equinoxorg/Micro-Hydro-ELC/README.md

hydrocontroller-hardware-designs
================================

This repository holds PCB/hardware designs for the e.quinox Kingfisher Micro Hydro Power Plant Controller.

Edit
