equinoxorg/Micro-Hydro-ELC/PCB_ControlStack/Images/breakoutTOP.png

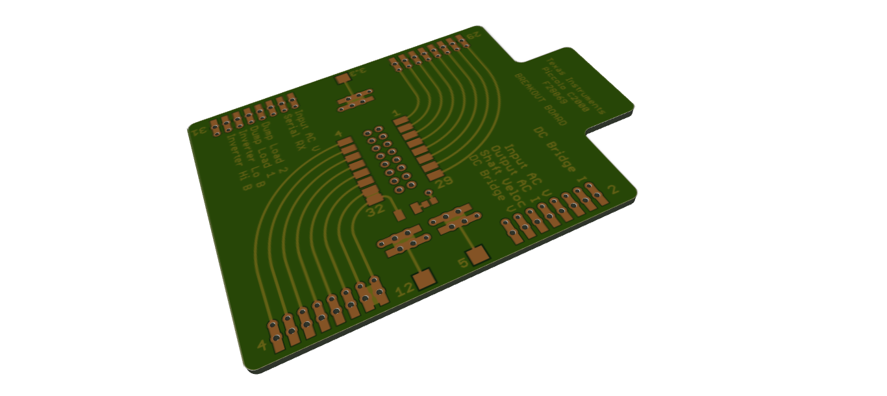
PCB_ControlStack/Images/breakoutTOP.png
