equinoxorg/Micro-Hydro-ELC/PCB_ControlStack/Images/supplyTOP.png

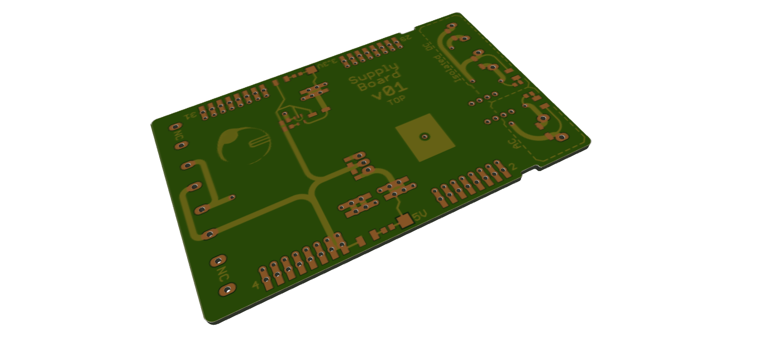
PCB_ControlStack/Images/supplyTOP.png
