equinoxorg/Micro-Hydro-ELC/PCB_ControlStack/Stacks Pin Layout.PNG

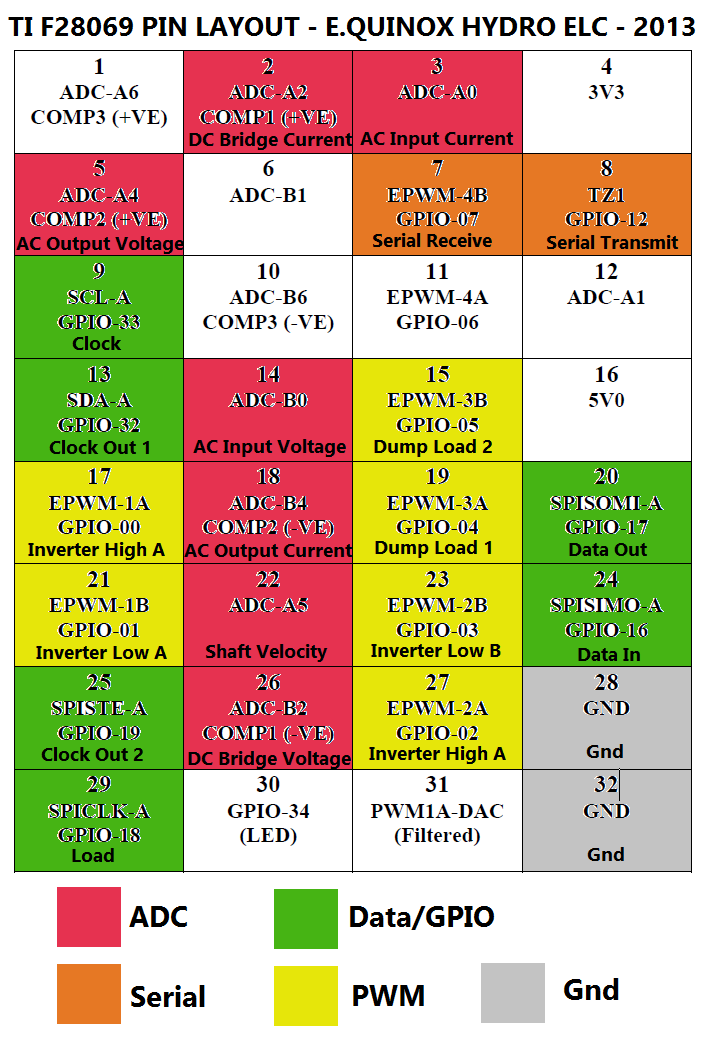
PCB_ControlStack/Stacks Pin Layout.PNG
