equinoxorg/Micro-Hydro-ELC/PCB_ControlStack/Components - Controller v07.xlsx

Sheet: Rev2
 | Board | Control PCB
 | Revision | 3rd |  | Authors | Wanyun Vivian Yang & Ali Al-Hakim |  |  |  | TOTAL | £95.75
 |  |  |  | Means EAGLE FILES ready available
Delivered? (Enter "d") | Order date | Supplier | Reference | Item Name | Description | Case/Package Type | Quantity | Minimum Order Quantity | Price, GBP | Total, GBP | URL | Other + EAGLE Package
d |  | OneCall | 1564483 | KA7805AETU | 12V to 5V regulator, 1A | TO-220 | 3 | 1 | £0.36 | £1.08 | http://onecall.farnell.com/fairchild-semiconductor/ka7805aetu/ic-reg-ldo-5v-1a-to220-3/dp/1564483 | controlPCB_aha.lbr
d |  | OneCall | 2219097 | MIC5219-3.3YM5TR | 12V to 3.3V regulator, 1.5A | SMD,SOT-23 | 6 | 1 | £1.14 | £6.84 | http://onecall.farnell.com/micrel-semiconductor/mic5219-3-3ym5-tr/ldo-0-5vdo-0-5a-3-3v-1-5sot23/dp/2219097 | MIC5219XX
d |  | OneCall | 8728151 | IL1212S | Isolated Power Supply 12V/12V |  | 4 | 1 | £4.50 | £18.00 | http://onecall.farnell.com/xp-power/il1212s/converter-dc-dc-2w-12v/dp/8728151 | controlPCB_aha.lbr
d |  | OneCall | 1201249 | 74HC165D | Shift Register Parallel to Serial | SOIC | 6 | 1 | £0.38 | £2.28 | http://uk.farnell.com/nxp/74hc165d/ic-74hc-cmos-smd-74hc165-soic16/dp/1201249 | U1 74HC165D.lbr
d |  | OneCall | 1752869 | SN74AHC594D | Shift Register Serial to Parallel | SMD, SO-16 | 6 | 1 | £0.29 | £1.74 | http://uk.farnell.com/texas-instruments/sn74ahc594d/logic-8bit-shift-register-16soic/dp/1752869 | S_REG_ONE, S_REG_TWO controlPCB_aha.lbr
d |  | OneCall | 1781148 | MCP2200 | USB 2.0 to UART chip, | SMD, SO-20 | 3 | 1 | £1.50 | £4.50 | http://onecall.farnell.com/microchip/mcp2200-i-so/ic-usb2-0-to-uart-w-gpio-20soic/dp/1781148 | controlPCB_aha.lbr
d |  | Onecall | 2063133 | MC22008B6W | Midas 2x20 character LCD display | n/a | 1 | 1 | £13.09 | £13.09 | http://onecall.farnell.com/midas/mc22008b6w-sptly/lcd-2x20-stn-g-b-l-8mm/dp/2063133?Ntt=2063133
d |  | OneCall | 1593421 | MC34735 | Male-Male Header 2.54mm pitch | Through-hole | 80 | 10 | £0.12 | £9.60 | http://onecall.farnell.com/multicomp/mc34735/header-1-row-vert-14way/dp/1593421?Ntt=1593421 | headers v6-2.lbr
d |  | RS | 681-6848 | n/a | HARWIN DIL receptacles, 2.54mm pitch | Through-hole | 4 | 5 | £1.78 | £8.90 | http://uk.rs-online.com/web/p/pcb-sockets/6816848/ | controlPCB_aha.lbr
d |  | RS | 673-7486 | n/a | HARWIN SIL 1x10w header, straight | Through-hole | 8 | 5 | £0.19 | £1.92 | http://uk.rs-online.com/web/p/headers-pcb-receptacles/6737486/ | headers v6-2.lbr
d |  | EE stores | CN0001 | n/a | PCB 2WAY 18A TERMINAL BLOCK 7.5MM | Through-hole | 10 | 1 | £0.14 | £1.40 | http://www.ee.ic.ac.uk/storesweb/Page8.html | headers v6-2.lbr
d |  | OneCall | RE06737 | 3296Y-1-103LF | 10kohmtrimmer, 25 turn, (through-hole) | 64Y | 4 | 1 | £0.89 | £3.56 | http://onecall.farnell.com/bourns/3296-1-103lf/trimmer-25-turn-10k/dp/RE06737 | R-TRIMM64Y
d |  | OneCall | 1506148 | LHVC0805-100KFT5 | Welwyn 100kohm resistor | SMD, 0805 | 20 | 10 | £0.02 | £0.46 | http://onecall.farnell.com/welwyn/lhvc0805-100kft5/resistor-100k-1-0805/dp/1506148 | R9, R10, R11, R12 R-EU_M0805
d |  | OneCall | 1500670 | RT0805FRE071K2L | Yageo 1.2kohm resistor | SMD, 0805 | 15 | 5 | £0.02 | £0.28 | http://onecall.farnell.com/yageo-phycomp/rt0805fre071k2l/resistor-0805-1-50ppm-1k2/dp/1500670 | R24, R25, R26 R-EU_M0805
d |  | OneCall | 2138843 | CRCW0805102RFKEA | Vishay Draloric 102ohm resistor | SMD, 0805 | 5 | 50 | £0.01 | £0.30 | http://onecall.farnell.com/vishay-draloric/crcw0805102rfkea/resistor-0805-102r-1/dp/2138843 | R27 R-EU_M0805
d |  | OneCall | 2138818 | CRCW080561R9FKEA | Vishay Draloric 61.9ohm resistor | SMD, 0805 | 5 | 50 | £0.01 | £0.30 | http://onecall.farnell.com/vishay-draloric/crcw080561r9fkea/resistor-0805-61r9-1/dp/2138818 | R28 R-EU_M0805
d |  | OneCall | 1653294 | RR1220P-201 | Susumu 200ohm resistor | SMD, 0805 | 100 | 1 | £0.06 | £6.40 | http://onecall.farnell.com/susumu/rr1220p-201-b-t5/resistor-0805-0-1-200r/dp/1653294 | R1, R2, R3, R4, R5, R6, R7, R8, R13, R14, R15, R16, R17, R18, R19, R20, R21, R22, R23, R29, R30 R-EY_M0805
d |  | OneCall | 1223746 | HSMF-A211-A00J1 | Avago LED red / yellow-green dual LED | SMD, PLCC-4 | 3 | 5 | £0.23 | £1.15 | http://onecall.farnell.com/avago-technologies/hsmf-a211-a00j1/led-smd-red-yel-grn/dp/1223746 http://onecall.farnell.com/avago-technologies/asmt-shb4-pw905/led-smd-plcc4-silicone-red-orange/dp/2065649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 | LEDP-LCC-4
d |  | OneCall | 1058404 | HSMS-A100-L00J1 | Avago LED red | SMD, PLCC-2 | 5 | 5 | £0.08 | £0.40 | http://onecall.farnell.com/avago-technologies/hsms-a100-l00j1/led-smd-plcc2-he-red/dp/1058404 | LG_T679-E1F1-1 OR LEDP-LCC-2
d |  | OneCall | 1659076 | VLMC3100-GS08 | Vishay LED green | SMD, PLCC-2 | 10 | 5 | £0.07 | £0.70 | http://onecall.farnell.com/vishay/vlmc3100-gs08/led-smd-plcc2-green/dp/1659076 | LG_T679-E1F1-1 OR LEDP-LCC-2
d |  | OneCall | 1865504 | C0603C390J1GACTU | Kemet 39pF ceramic capacitor | SMD, 0603 | 5 | 10 | £0.01 | £0.11 | http://onecall.farnell.com/kemet/c0603c390j1gactu/capacitor-np0-0603-100v-39pf/dp/1865504 | C11, C12 C-EUC0603
d |  | OneCall | 1833809 | 0603ZG105ZAT2A | AVX 1uF ceramic capacitor | SMD, 0603 | 3 | 10 | £0.02 | £0.19 | http://onecall.farnell.com/avx/0603zg105zat2a/capacitor-06035v-10v-1uf/dp/1833809 | C7
d |  | OneCall | 1889265 | GRM188C80J225KE19D | Murata 2.2uF ceramic capacitor | SMD, 0603 | 3 | 10 | £0.03 | £0.33 | http://onecall.farnell.com/murata/grm188c80j225ke19d/capacitor-0603-x6s-6-3v-2-2uf/dp/1889265 | C8
d |  | OneCall | 2112833 | C0603C104K8RACTU | Kemet 0.1uF ceramic capacitor | SMD, 0603 | 10 | 1 | £0.01 | £0.11 | http://onecall.farnell.com/kemet/c0603c104k8ractu/capacitor-0-1uf-10v-x7r-0603/dp/2112833 | C9, C10, C6 C-EUC0603
d |  | OneCall | 1510713 | PESD3V3L2BT | Bidirectional, dual ESD Protection | SMD, SOT-23 | 21 | 5 | £0.15 | £3.67 | http://uk.farnell.com/nxp/pesd3v3l2bt/diode-tvs-2ua-3-3v-sot-23/dp/1510713RL | BAS40-06
d |  | OneCall | SC10048 | LF A158A | IQD crystal oscillator, 12MHz | HC-49 | 4 | 1 | £0.28 | £1.12 | http://onecall.farnell.com/iqd-frequency-products/lf-a158a/crystal-12mhz/dp/SC10048 | CRYSTALHC49U-V
d |  | OneCall | CN15415 | MC32593 | USB connector | Through-hole | 4 | 1 | £0.32 | £1.28 | http://onecall.farnell.com/multicomp/mc32593/socket-usb-pcb-r-a-type-a/dp/CN15415 | controlPCB_aha.lbr
d |  | OneCall | CN15441 | 47346-0001 | Micro USB connector | SMD | 4 | 1 | £0.46 | £1.84 | http://onecall.farnell.com/molex/47346-0001/receptacle-micro-usb-b-bottom-mount/dp/CN15441 | MINI-USB-SCHIELD-32005-301

Sheet: Breakout
 | Board | Control PCB - Breakout Module
 | Revision | 4th |  | Authors | Ali Al-Hakim |  |  |  | TOTAL | £20.27
 |  |  |  | Means EAGLE FILES ready available
Delivered? (Enter "d") | Order date | Supplier | Reference | Item Name | Description | Case/Package Type | Quantity | Minimum Order Quantity | Price, GBP | Total, GBP | URL | Other + EAGLE Package
d |  | Onecall | 1022257 |  | Male header, 1x8way, 2.54mm pitch | TH | 4 | 10 | £0.10 | £0.97 | http://onecall.farnell.com/harwin/m20-9990846/header-1row-8way/dp/1022257
d |  | Onecall | 7992017 |  | Female header, 2x8way, 2.54mm pitch | TH | 2 | 10 | £1.86 | £18.60 | http://onecall.farnell.com/harwin/m20-7830846/socket-pcb-0-1-8-8way/dp/7992017
 |  | Onecall | 1830409 |  | LED, green | SMD, PLCC2 | 0 | 5 | £0.07 | £0.00 | http://onecall.farnell.com/avago-technologies/hsmg-a100-l02j1/led-smd-plcc2-green/dp/1830409
d |  | Onecall | SC11679 |  | LED, orange | SMD, PLCC2 | 1 | 5 | £0.08 | £0.40 | http://onecall.farnell.com/avago-technologies/hsmd-a100-j00j1/led-smd-plcc2-orange/dp/SC11679
 |  | Onecall | 1058404 |  | LED, red | SMD, PLCC2 | 0 | 5 | £0.08 | £0.00 | http://onecall.farnell.com/avago-technologies/hsms-a100-l00j1/led-smd-plcc2-he-red/dp/1058404 | LED1, LED2, LED3, LED4
 |  | Onecall | 1328367 |  | LED, yellow | SMD, PLCC2 | 0 | 5 | £0.09 | £0.00 | http://onecall.farnell.com/vishay/vlmy31j1k2-gs08/led-plcc2-yellow/dp/1328367
 |  | Onecall | 1561007 |  | LED, blue | SMD, PLCC2 | 0 | 5 | £0.32 | £0.00 | http://onecall.farnell.com/vishay/vlmb41p1q2-gs08/led-plcc2-blue/dp/1561007
 |  | Onecall | 1561003 |  | LED, white | SMD, PLCC2 | 0 | 5 | £0.18 | £0.00 | http://onecall.farnell.com/vishay/vlmw41s1t1-5k8l-08/led-plcc2-white/dp/1561003
d |  |  | 2138798 |  | Resistor, 39ohm | SMD, 0805 | 1 | 50 | £0.01 | £0.30 | http://onecall.farnell.com/vishay-draloric/crcw080539r0fkea/resistor-0805-39r-1/dp/2138798 | R3

Sheet: Power
 | Board | Control PCB - Supply Module
 | Revision | 4th |  | Authors | Ali Al-Hakim |  |  |  | TOTAL | £10.51
 |  |  |  | Means EAGLE FILES ready available
Delivered? (Enter "d") | Order date | Supplier | Reference | Item Name | Description | Case/Package Type | Quantity | Minimum Order Quantity | Price, GBP | Total, GBP | URL | Other + EAGLE Package
d |  | EEE | CN0001 |  | Vertical terminal block, 7.5mm pitch | TH | 7
d |  | Onecall |  | MIC5219 | Micrel 12V to 3V3 LDO | SMD, SOT23 | 1 | 1 | £1.14 | £1.14 | http://onecall.farnell.com/micrel-semiconductor/mic5219-3-3ym5-tr/ldo-0-5vdo-0-5a-3-3v-1-5sot23/dp/2219097 | U1
d |  | OneCall |  |  | Fairchild 10V to 5V LDO | TH, TO220 | 1 | 1 | £0.36 | £0.36 | http://onecall.farnell.com/fairchild-semiconductor/ka7805aetu/ic-reg-ldo-5v-1a-to220-3/dp/1564483 | U2
d |  |  | 9334688 |  | Resistor, 560ohm | SMD, 0805 | 2 | 50 | £0.01 | £0.50 | http://onecall.farnell.com/multicomp/mc-0-1w-0805-5-560r/resistor-0805-560r/dp/9334688 | R1, R2
d |  |  | 9333916 |  | Resistor, 150ohm | SMD, 0805 | 1 | 50 | £0.01 | £0.50 | http://onecall.farnell.com/multicomp/mc-0-1w-0805-5-150r/resistor-0805-150r/dp/9333916 | R4
d |  |  | 2138798 |  | Resistor, 39ohm | SMD, 0805 | 1 | 50 | £0.01 | £0.30 | http://onecall.farnell.com/vishay-draloric/crcw080539r0fkea/resistor-0805-39r-1/dp/2138798 | R3
d |  | Onecall | 2069174 |  | Electrolytic capacitor, 10uF | SMD, 4mm | 3 | 10 | £0.12 | £1.19 | http://onecall.farnell.com/kemet/exv106m025a9baa/capacitor-10uf-25v-smd/dp/2069174 | C1, C2, C3
d |  | Onecall | 2068683 |  | Electolytic capacitor, 2.2uF | SMD, 4mm | 1 | 10 | £0.08 | £0.81 | http://onecall.farnell.com/jsp/search/browse.jsp?N=411+202457+732+502+110059735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 | C4
d |  | Onecall | CA06659 |  | Ceramic capacitor, 470pF | SMD, 0805 | 1 | 10 | 0.028 | £0.28 | http://onecall.farnell.com/kemet/c0805c471j5gactu/capacitor-0805-470pf-50v-np0/dp/CA06659 | C5
d |  | Onecall | 1845770 |  | Ceramic capacitor, 1uF | SMD, 0805 | 1 | 10 | £0.04 | £0.42 | http://onecall.farnell.com/murata/grm219r71e105ka88d/cap-ceramic-1uf-25v-x7r-0805/dp/1845770 | C6
d |  | OneCall | 1759265 |  | Ceramic capacitor, 0.1uF | SMD, 0805 | 1 | 100 | £0.01 | £0.70 | http://onecall.farnell.com/multicomp/mcca000386/cap-ceramic-0-1uf-50v-x7r-0805/dp/1759265 | C8
d |  | Onecall | CA06414 |  | Ceramic capacitor, 0.33uF | SMD, 0805 | 1 | 100 | £0.02 | £1.60 | http://onecall.farnell.com/multicomp/mcca000283/mlcc-0805-x7r-16v-330nf/dp/CA06414 | C7
 |  | Onecall | 1830409 |  | LED, green | SMD, PLCC2 | 0 | 5 | £0.07 | £0.00 | http://onecall.farnell.com/avago-technologies/hsmg-a100-l02j1/led-smd-plcc2-green/dp/1830409
 |  | Onecall | SC11679 |  | LED, orange | SMD, PLCC2 | 0 | 5 | £0.08 | £0.00 | http://onecall.farnell.com/avago-technologies/hsmd-a100-j00j1/led-smd-plcc2-orange/dp/SC11679
nd |  | Onecall | 1058404 |  | LED, red | SMD, PLCC2 | 4 | 5 | £0.08 | £0.40 | http://onecall.farnell.com/avago-technologies/hsms-a100-l00j1/led-smd-plcc2-he-red/dp/1058404 | LED1, LED2, LED3, LED4
 |  | Onecall | 1328367 |  | LED, yellow | SMD, PLCC2 | 0 | 5 | £0.09 | £0.00 | http://onecall.farnell.com/vishay/vlmy31j1k2-gs08/led-plcc2-yellow/dp/1328367
 |  | Onecall | 1561007 |  | LED, blue | SMD, PLCC2 | 0 | 5 | £0.32 | £0.00 | http://onecall.farnell.com/vishay/vlmb41p1q2-gs08/led-plcc2-blue/dp/1561007
 |  | Onecall | 1561003 |  | LED, white | SMD, PLCC2 | 0 | 5 | £0.18 | £0.00 | http://onecall.farnell.com/vishay/vlmw41s1t1-5k8l-08/led-plcc2-white/dp/1561003
d |  | Amazon |  |  | Stackable header, 1x8way, 2.54mm pitch | TH | 7 | 1 | £0.33 | £2.31 | http://www.amazon.co.uk/8-Pin-Stackable-Header-Arduino/dp/B0046AKKHS

Sheet: Measure
 | Board | Control PCB - PWM and Measurement Module
 | Revision | 4th |  | Authors | Ali Al-Hakim |  |  |  | TOTAL | £11.97
 |  |  |  | Means EAGLE FILES ready available
Delivered? (Enter "d") | Order date | Supplier | Reference | Item Name | Description | Case/Package Type | Quantity | Minimum Order Quantity | Price, GBP | Total, GBP | URL | Other + EAGLE Package
d |  | Amazon | n/a |  | Stackable header, 1x8way, 2.54mm pitch | TH | 7 | 1 | £0.330 | £2.31 | http://www.amazon.co.uk/8-Pin-Stackable-Header-Arduino/dp/B0046AKKHS
d |  | Onecall | CN14508 |  | Right-angle male header, 1x14way, 2.35mm pitch | TH | 1 | 10 | £0.225 | £2.25 | http://onecall.farnell.com/multicomp/mc34759/header-1-row-r-angle-14way/dp/CN14508
d |  | OneCall | CN14560 |  | Multicomp crimp housing, 1x8way, 2.54mm pitch | n/a | 10 | 10 | £0.140 | £1.40 | http://onecall.farnell.com/multicomp/2226a-08/crimp-housing-1-row-8-way/dp/CN14560
d |  | OneCall | CN14558 |  | Multicomp crimp housing, 1x5way, 2.54mm pitch | n/a | 10 | 10 | £0.062 | £0.62 | http://onecall.farnell.com/multicomp/2226a-05/crimp-housing-1-row-5-way/dp/CN14558
d |  | OneCall | CN14556 |  | Multicomp crimp housing, 1x3way, 2.54mm pitch | n/a | 10 | 10 | £0.039 | £0.39 | http://onecall.farnell.com/multicomp/2226a-03/crimp-housing-1-row-3-way/dp/CN14556
d |  | OneCall | CN14576 |  | Multicomp crimp terminal, 24-28AWG | n/a | 100 | 100 | £0.050 | £5.00 | http://onecall.farnell.com/multicomp/2226tg/crimp-terminal-24-28awg/dp/CN14576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

Sheet: DigitalOut
 | Board | Control PCB - Digital Output Module
 | Revision | 4th |  | Authors | Ali Al-Hakim |  |  |  | TOTAL | £23.46
 |  |  |  | Means EAGLE FILES ready available
Delivered? (Enter "d") | Order date | Supplier | Reference | Item Name | Description | Case/Package Type | Quantity | Minimum Order Quantity | Price, GBP | Total, GBP | URL | Other + EAGLE Package
 |  | Onecall | 1607849 | SN74HC595DR | Texas Instruments serial-to-parallel shift register, 8 bit withstorage, tri-state | SOIC-16 | 2 | 1 | £0.25 | £0.50 | http://onecall.farnell.com/texas-instruments/sn74hc595dr/ic-sm-logic-74hc-register/dp/1607849
 |  | Onecall | 1201266 | 74HCT165D | NXP parallel-to-serial shift register, 8 bit | SOIC-16 | 1 | 1 | £0.23 | £0.23 | http://onecall.farnell.com/nxp/74hct165d/74hct-cmos-smd-74hct165-soic16/dp/1201266
 |  | Onecall | 2063133 | MC22008B6W | Midas Components LCD Display, 2x20 way, yellow/green | n/a | 1 | 1 | £13.09 | £13.09 | http://onecall.farnell.com/midas/mc22008b6w-sptly/lcd-2x20-stn-g-b-l-8mm/dp/2063133?Ntt=2063133
 |  | Onecall | 1099017 | MC9B232 | Multicomp latched male header, 2x8way, 2.54mm pitch, right angled | TH | 1 | 1 | £0.64 | £0.64 | http://onecall.farnell.com/multicomp/mc9b232-1634/header-right-angle-l-latch-16way/dp/1099017
 |  | Onecall | 1099238 | MC6FD016 | Multicomp IDC socket, 2x8way, 2.54mm pin pitch, 1.27mm cable pitch | n/a | 1 | 1 | £0.49 | £0.49 | http://onecall.farnell.com/multicomp/mc6fd016-30p1/socket-idc-with-s-relief-16way/dp/1099238
 |  | Onecall | 297318 | 3365-16 | 3M ribbon cable, 1x16way, 1.27mm pitch, 28AWG, per m cost | n/a | 1 | 1 | £1.56 | £1.56 | http://onecall.farnell.com/3m/3365-16/ribbon-cable-16way-per-m/dp/297318
 |  | Onecall | 473091 | 22-01-2165 | Molex crimp housing, 1x16way, 2.54mm pitch | n/a | 1 | 10 | £0.42 | £4.20 | http://onecall.farnell.com/molex/22-01-2165/crimp-housing-0-1-16way/dp/473091
 |  | Onecall | 1393516 | 22-05-7168 | Molex shrouded male header, 1x16way, 2.54mm pitch, right angled | TH | 1 | 1 | £0.10 | £0.10 | http://onecall.farnell.com/molex/22-05-7168/header-2-54mm-16way/dp/1393516
 |  | Onecall | 1696071 | 3361S-1-203GLF | Bourns trimmer, 20kohm, 1 turn | SMD | 1 | 5 | £0.53 | £2.65 | http://onecall.farnell.com/bourns/3361s-1-203glf/trimmer-smd-20k/dp/1696071
