equinoxorg/Micro-Hydro-ELC/PCB_ControlStack/Schematic v07.pdf

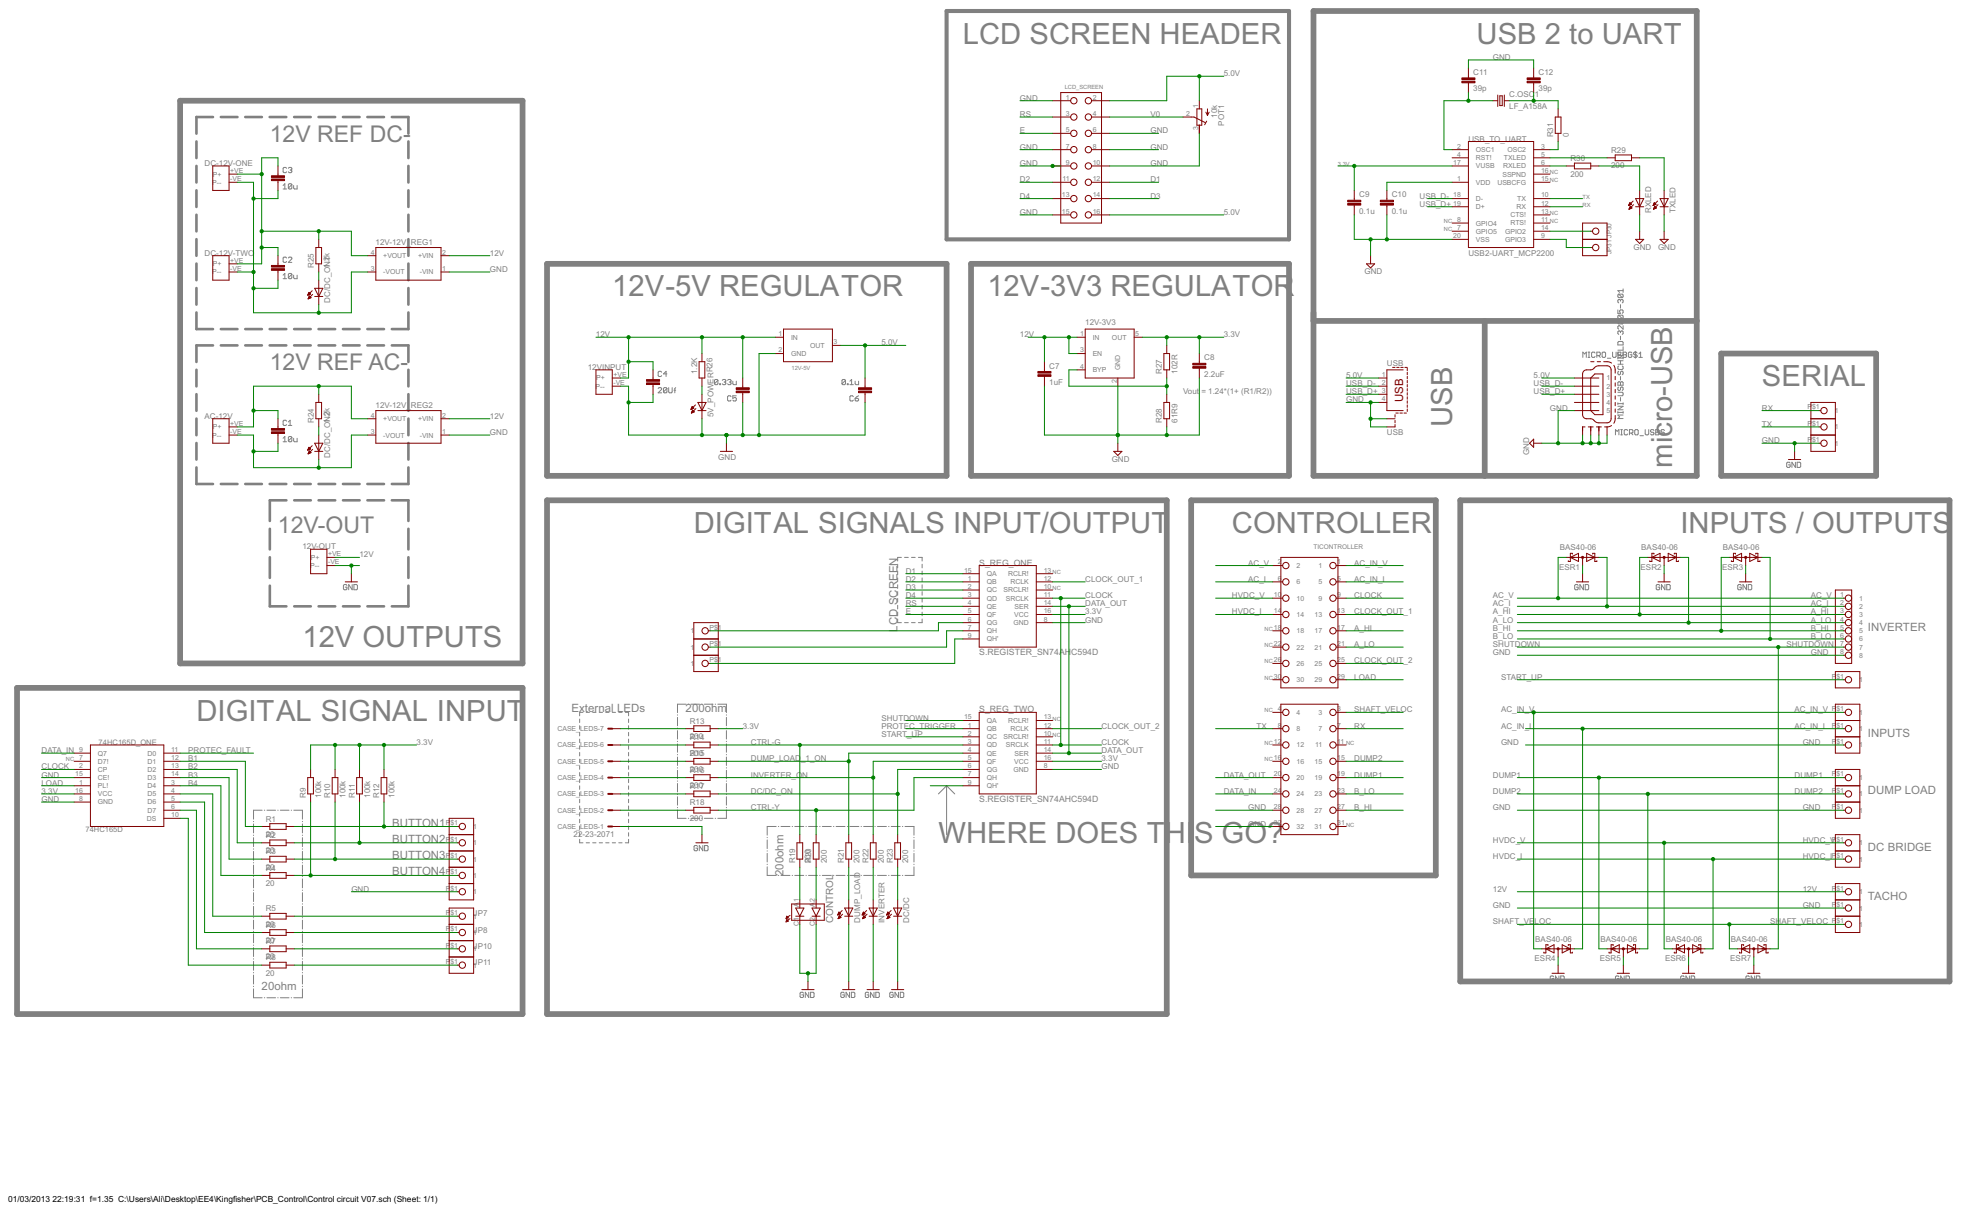
[picture p14: page 1]

16 SER
8 VCC

S.REGISTER_SN74AHC594D
WHERE DOES THIS GO?

01/03/2013 22:19:31 f=1.35 C:\Users\Ali\Desktop\EE4\Kingfisher\PCB_Control\Control circuit V07.sch (Sheet: 1/1)
