equinoxorg/Micro-Hydro-ELC/board_controller/controller 2.b.pdf

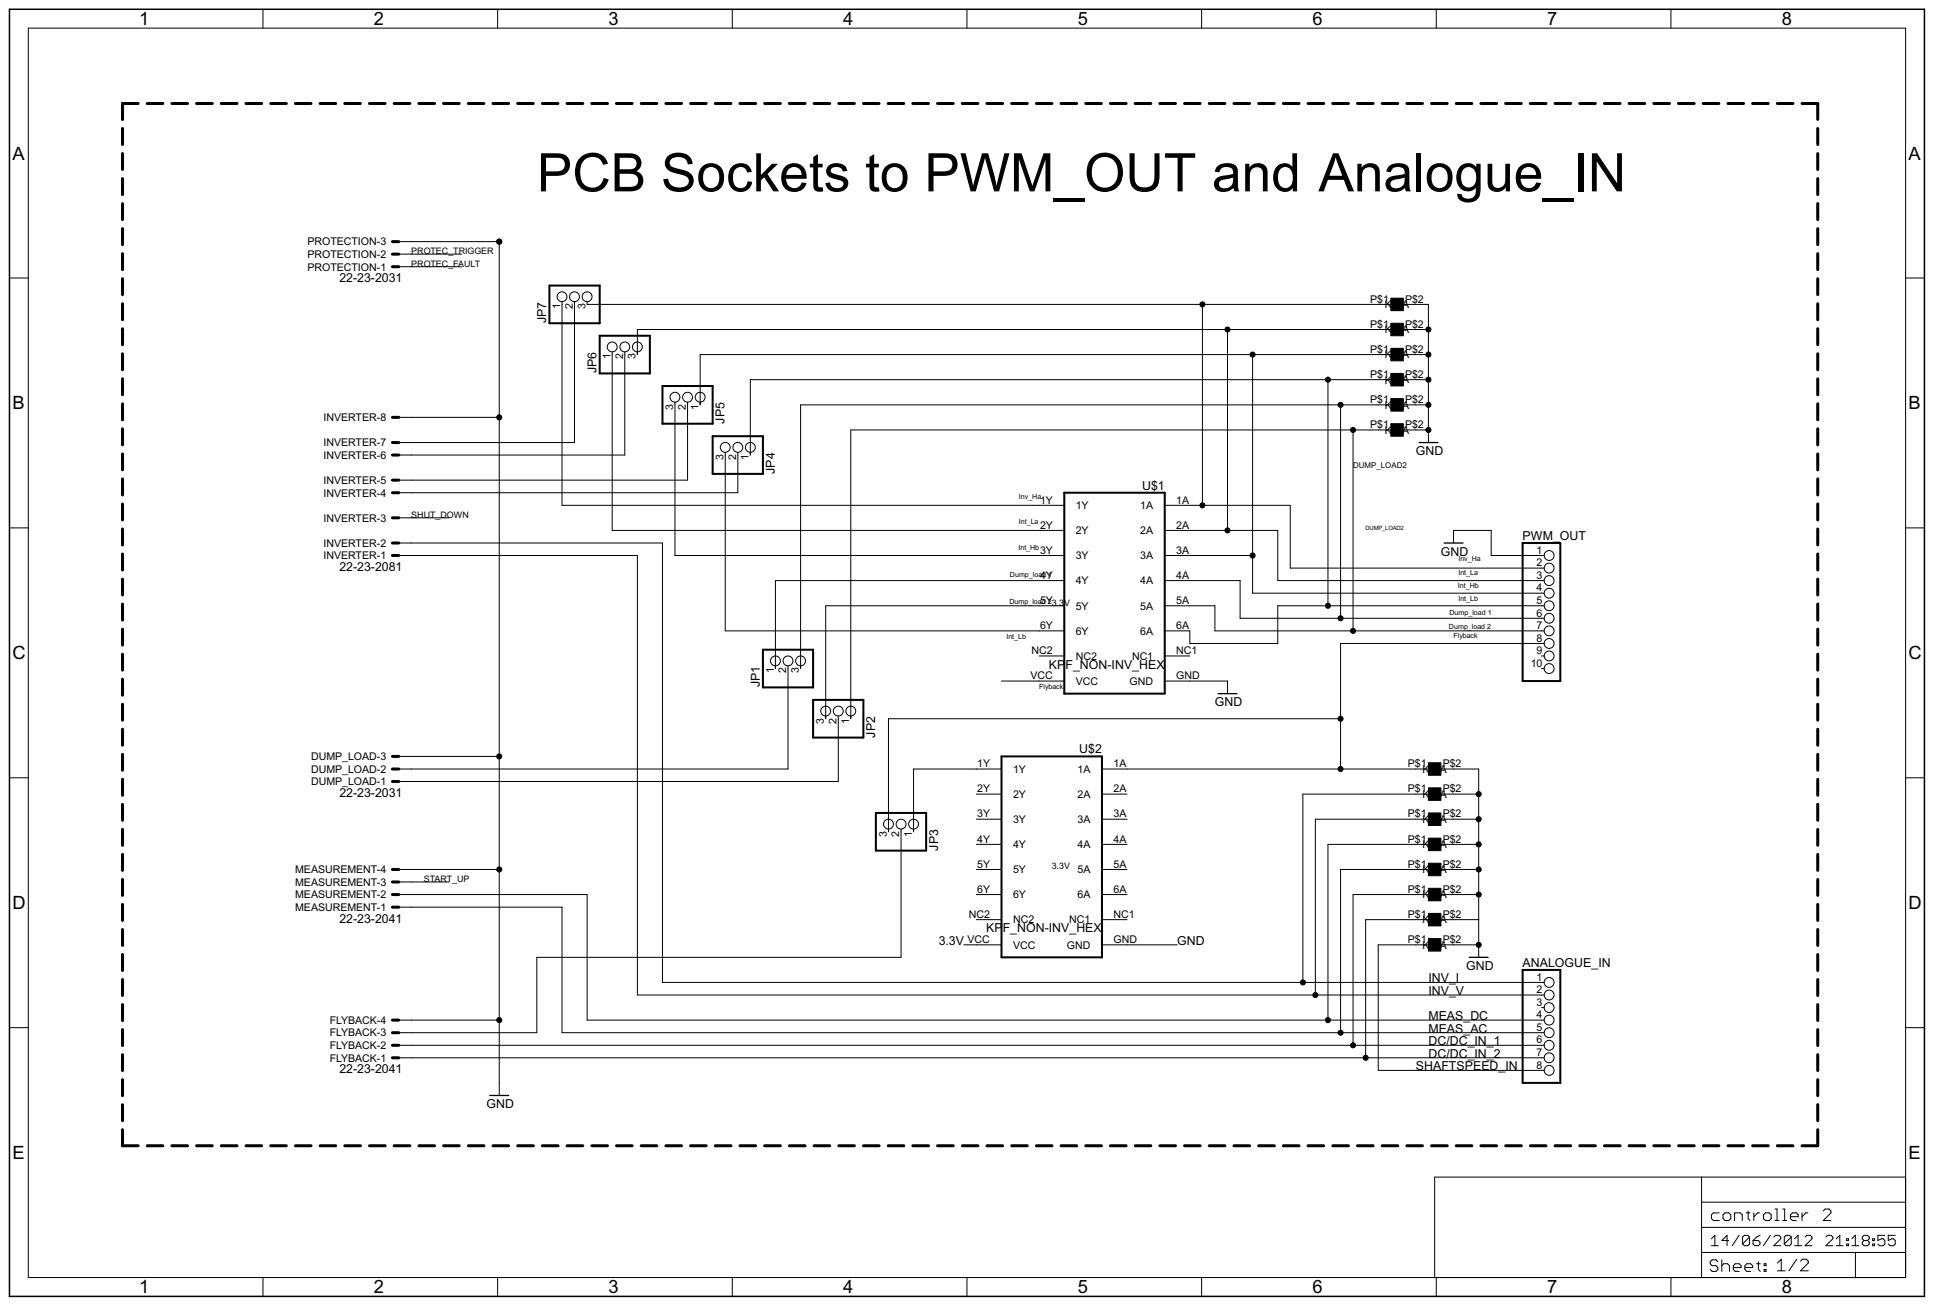
[picture p15: page 1]

PCB Sockets to PWM_OUT and Analogue_IN

Dump_load 1 Dump_load 2 5Y 3.3V | | 5A

Int_Lb VCC | NC2
