equinoxorg/Micro-Hydro-ELC/board_controller/controller 2.pdf

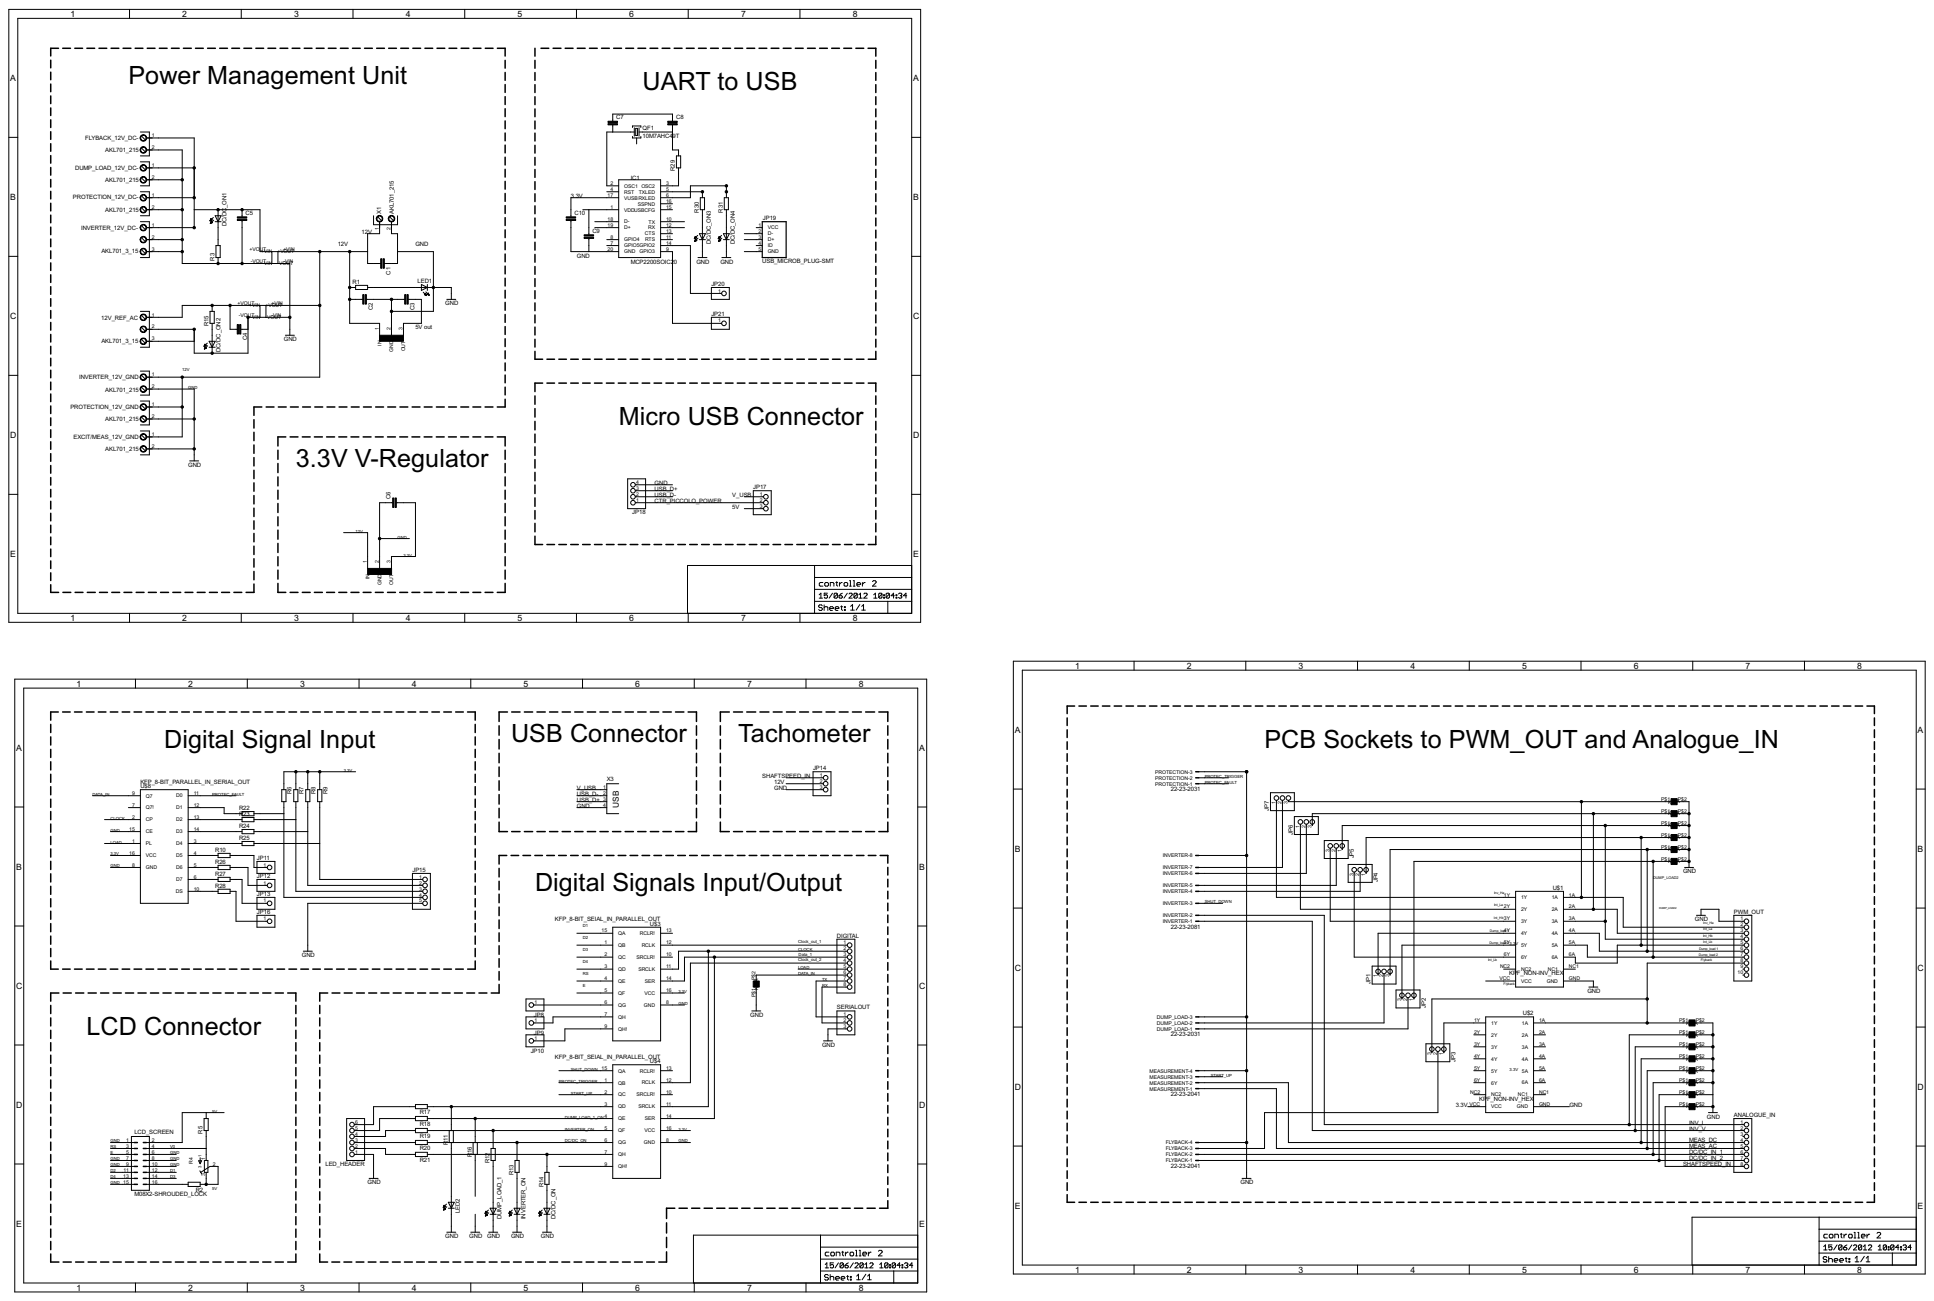
[picture p16: page 1]

PCB Sockets to PWM_OUT and Analogue_IN

Digital Signals Input/Output

MEASUREMENT-1 MEASUREMENT-2 MEASUREMENT-3 MEASUREMENT-4

FLYBACK-1 FLYBACK-2 FLYBACK-3 FLYBACK-4
