equinoxorg/Micro-Hydro-ELC/board_controller/controller 2.a.pdf

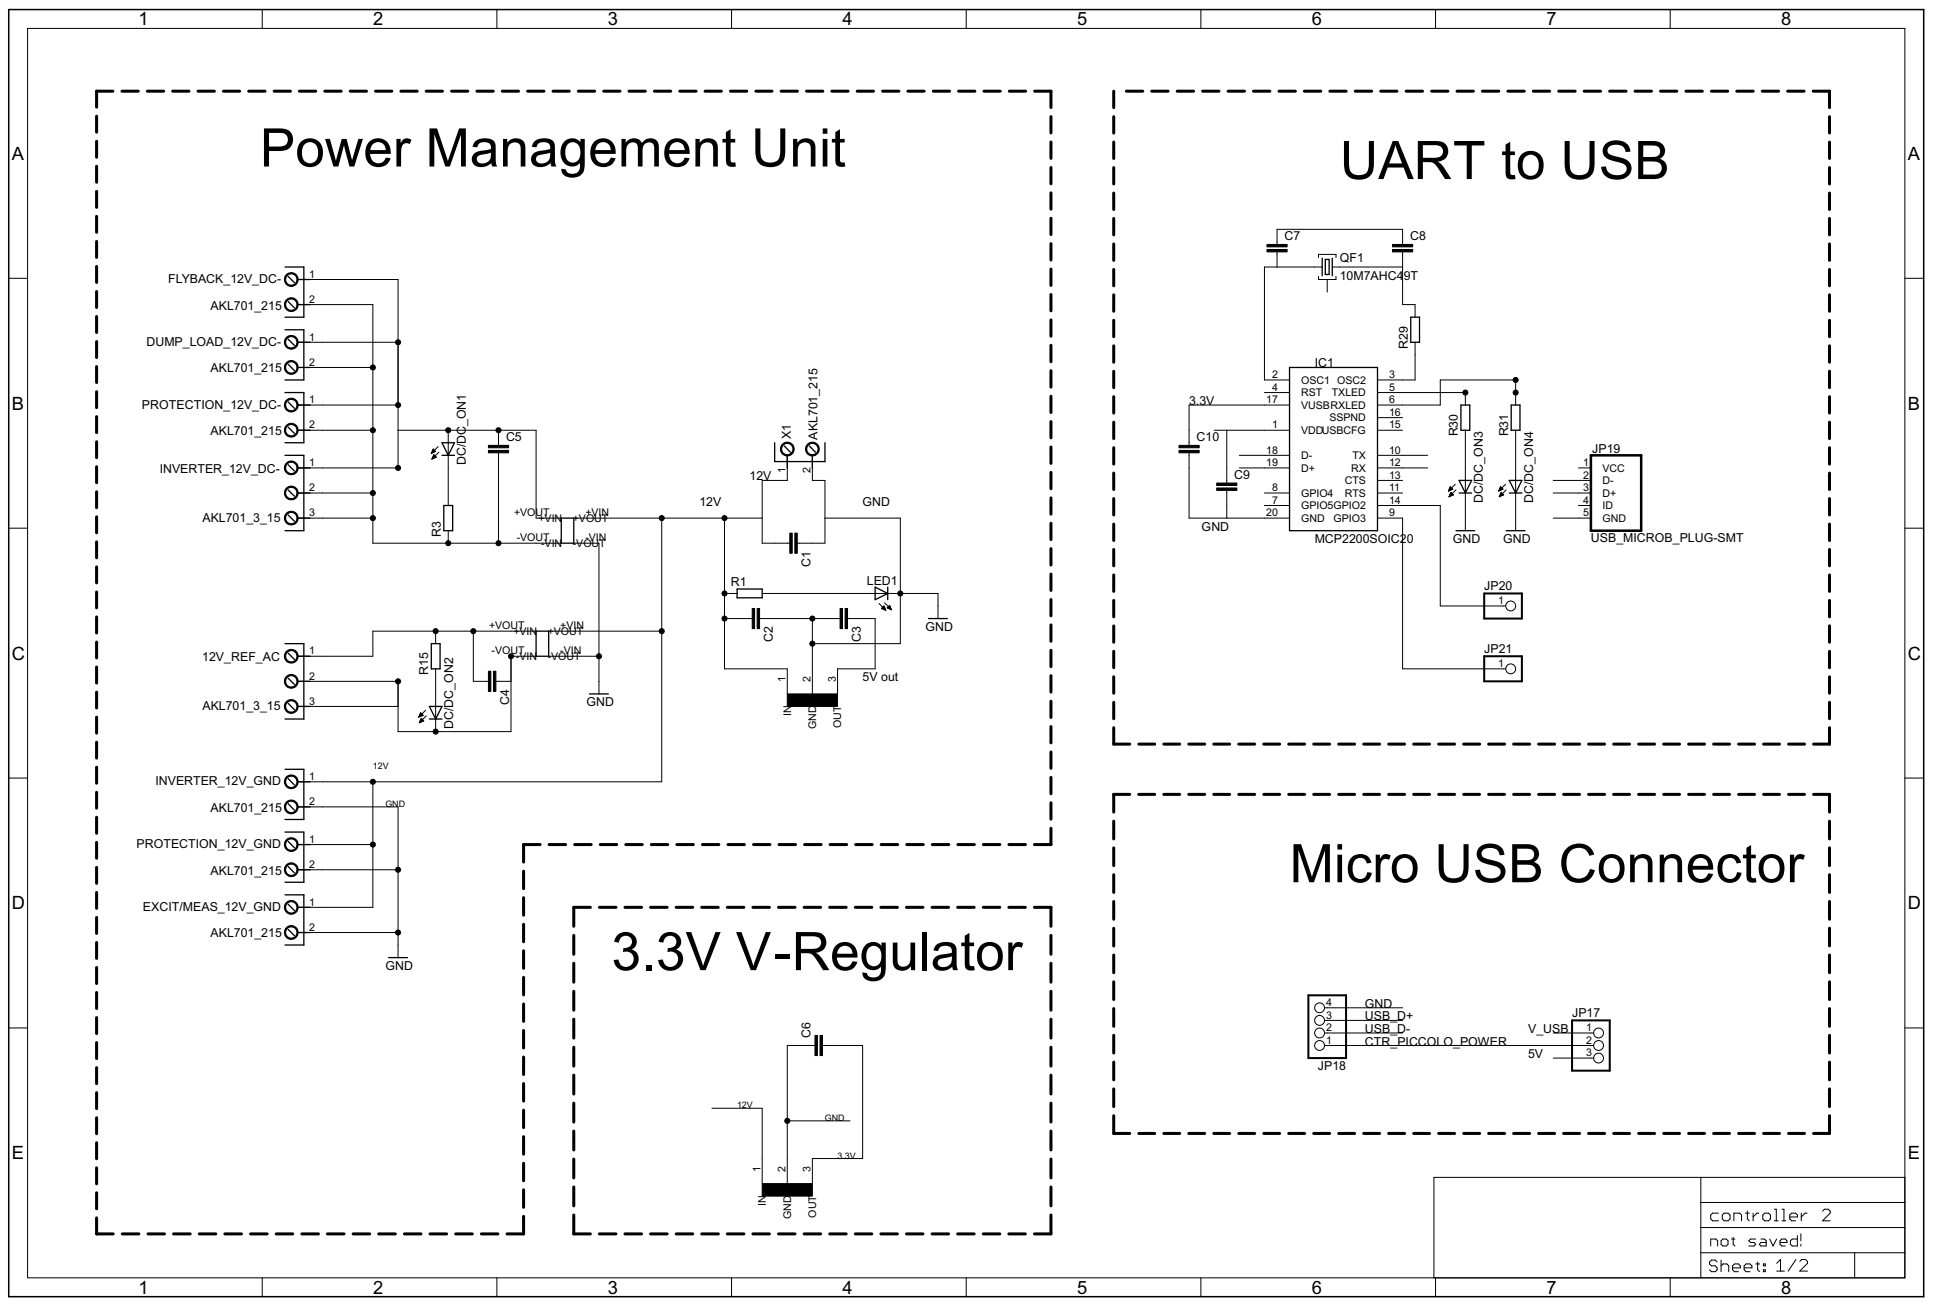
[picture p17: page 1]
