equinoxorg/Micro-Hydro-ELC/board_controller/controller 2.c.pdf

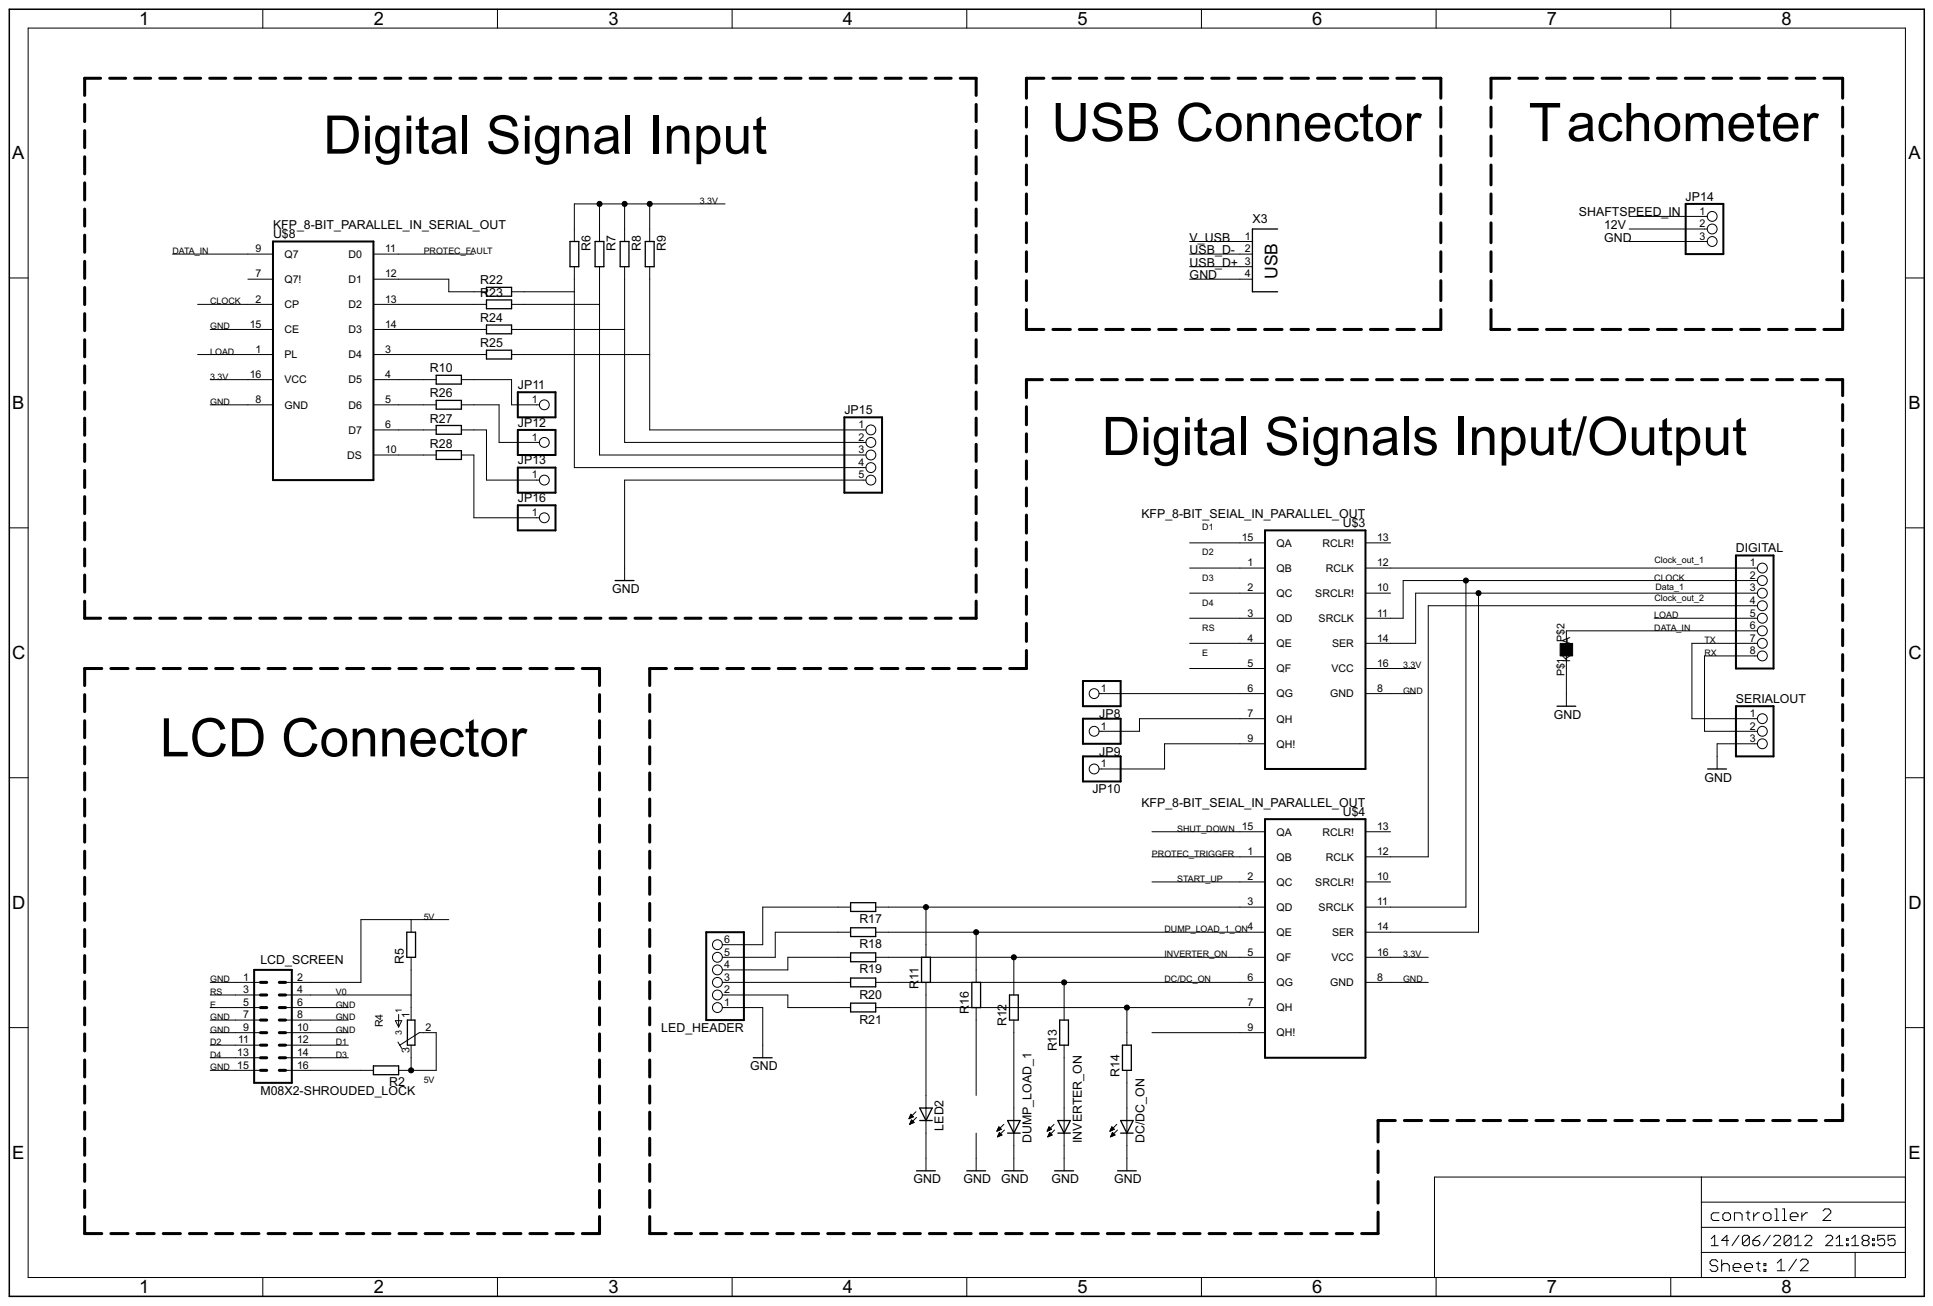
[picture p18: page 1]

Digital Signals Input/Output

LOAD DATA_IN | 5 6
