equinoxorg/Micro-Hydro-ELC/PCB_ControlStack/Supply-02.brd

## EAGLE design PCB_ControlStack/Supply-02.brd (2013-05-16)

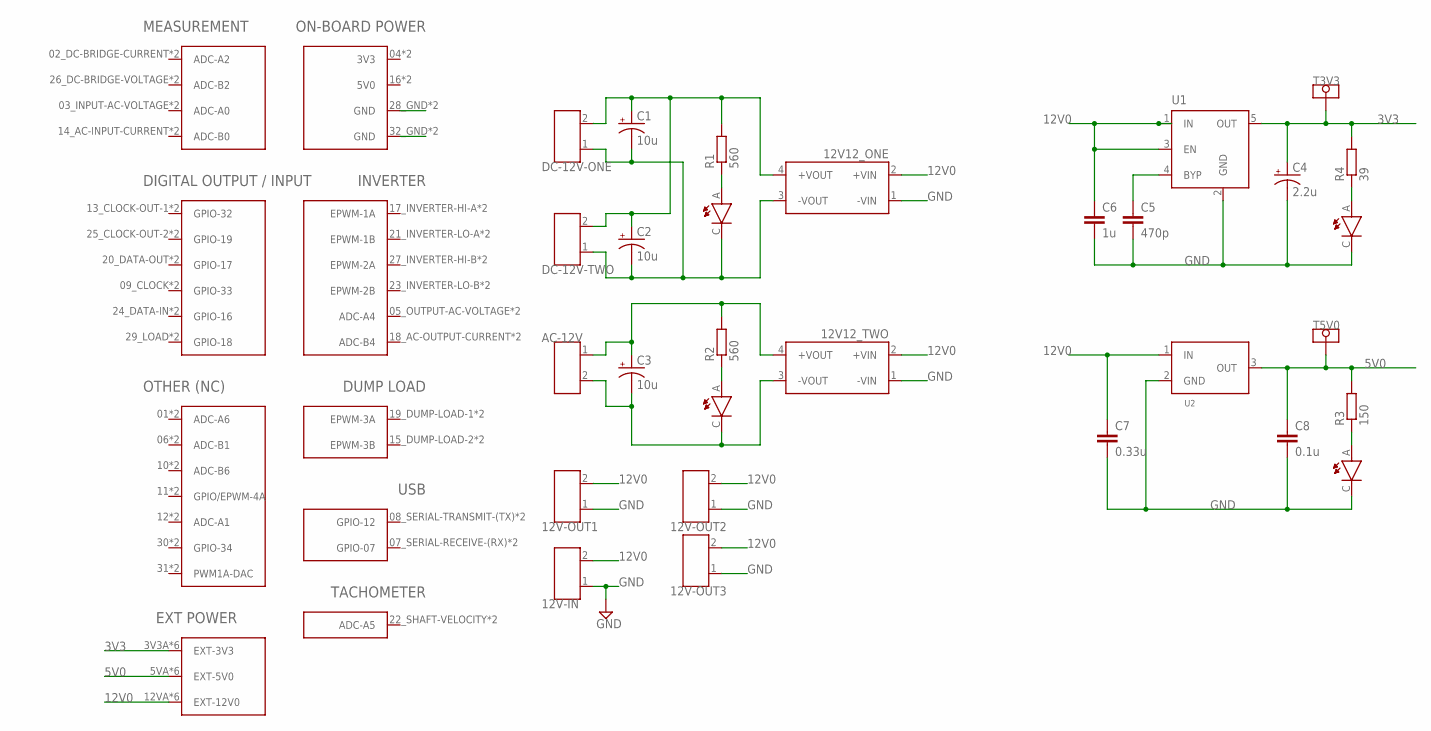
[picture p19: schematic Supply-02.sch]

Parts:
12V12_ONE, 12V12_TWO: 12V12_ISO_REG; SIL_REG
12V-IN, 12V-OUT1, 12V-OUT2, 12V-OUT3: 1X2_7,5_TB
AC-12V: 1X2_7,5_TB
C1, C2, C3: 10u; CPOL-4.0MM
C4: 2.2u; CPOL-4.0MM
C5: 470p; C0805
C6: 1u; C0805
C7: 0.33u; C0805
C8: 0.1u; C0805
DC-12V-ONE, DC-12V-TWO: 1X2_7,5_TB
H1: CONTROLLER_STACK
LED1, LED2, LED3, LED4: PLCC2
R1, R2: 560; R0805
R3: 150; R0805
R4: 39; R0805
T3V3, T5V0: TESTPAD
U1: MIC5219XX; SOT23-5
U2: 10V5V-REG-H; TO-220H

Connections:
3V3: C4.+, H1.3V3A (EXT-3V3), H1.3V3B (EXT-3V3), H1.3V3C (EXT-3V3), H1.3V3D (EXT-3V3), H1.3V3E (EXT-3V3), H1.3V3F (EXT-3V3), R4.2, T3V3.TP, U1.5 (OUT)
5V0: C8.1, H1.5VA (EXT-5V0), H1.5VB (EXT-5V0), H1.5VC (EXT-5V0), H1.5VD (EXT-5V0), H1.5VE (EXT-5V0), H1.5VF (EXT-5V0), R3.2, T5V0.TP, U2.3 (OUT)
12V0: 12V12_ONE.2 (+VIN), 12V12_TWO.2 (+VIN), 12V-IN.2, 12V-OUT1.2, 12V-OUT2.2, 12V-OUT3.2, C6.1, C7.1, H1.12VA (EXT-12V0), H1.12VB (EXT-12V0), H1.12VC (EXT-12V0), H1.12VD (EXT-12V0), H1.12VE (EXT-12V0), H1.12VF (EXT-12V0), U1.1 (IN), U1.3 (EN), U2.1 (IN)
GND: 12V12_ONE.1 (-VIN), 12V12_TWO.1 (-VIN), 12V-IN.1, 12V-OUT1.1, 12V-OUT2.1, 12V-OUT3.1, C4.-, C5.2, C6.2, C7.2, C8.2, H1.28_GND (GND), H1.32_GND (GND), H1.C28 (GND), H1.C32 (GND), LED3.C, LED4.C, U1.2 (GND), U2.2 (GND)
unnamed: 12V12_ONE.4 (+VOUT), C1.+, C2.+, DC-12V-ONE.2, DC-12V-TWO.2, R1.2
unnamed: 12V12_ONE.3 (-VOUT), C1.-, C2.-, DC-12V-ONE.1, DC-12V-TWO.1, LED1.C
unnamed: LED1.A, R1.1
unnamed: LED3.A, R3.1
unnamed: 12V12_TWO.3 (-VOUT), AC-12V.2, C3.-, LED2.C
unnamed: C5.1, U1.4 (BYP)
unnamed: LED2.A, R2.1
unnamed: 12V12_TWO.4 (+VOUT), AC-12V.1, C3.+, R2.2
unnamed: LED4.A, R4.1

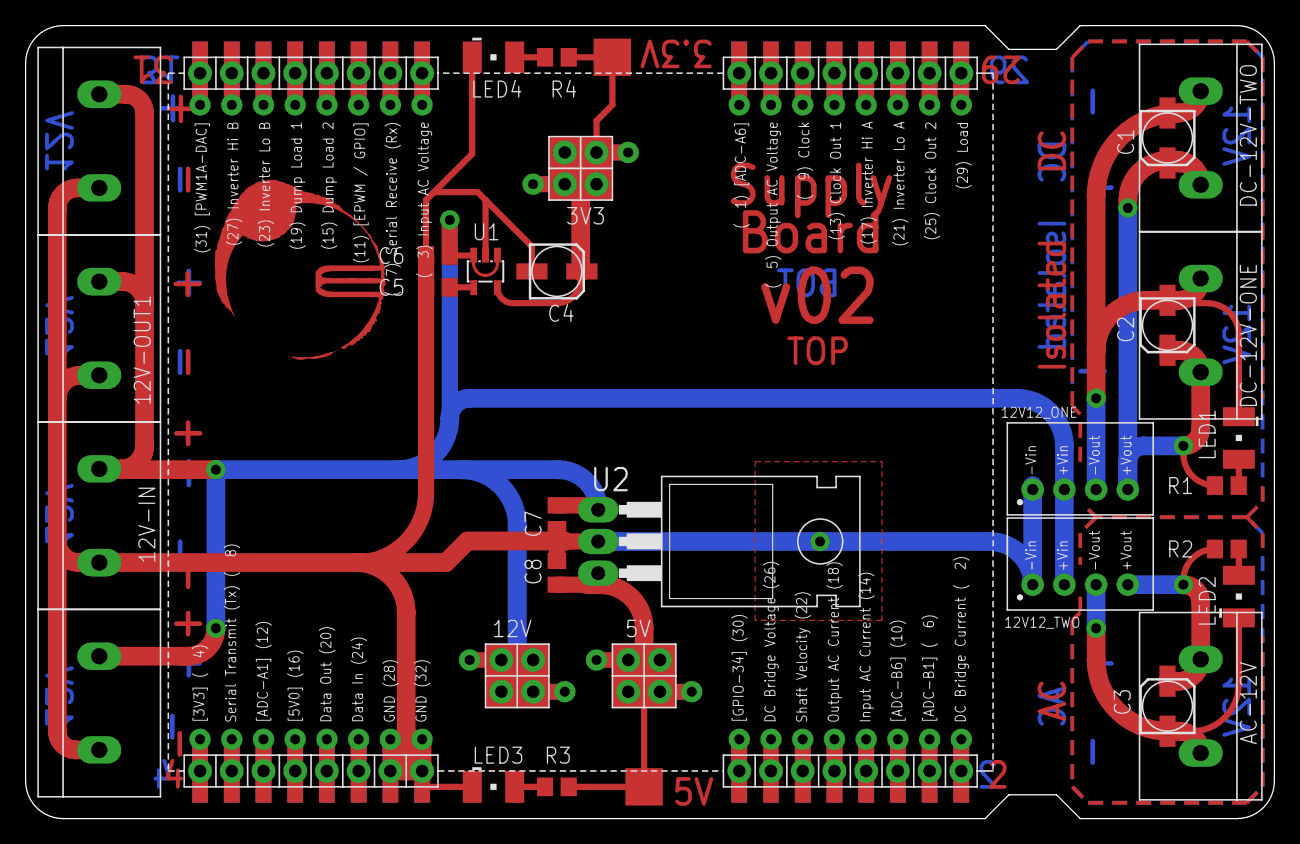
[picture p20: board Supply-02.brd from above]

Board: 2 copper layers, 100.0 x 63.5 mm, 30 parts (0 on the bottom side), 13 nets.
