equinoxorg/Micro-Hydro-ELC/PCB_ControlStack/DigitalOut-01.brd

## EAGLE design PCB_ControlStack/DigitalOut-01.brd (2013-05-16)

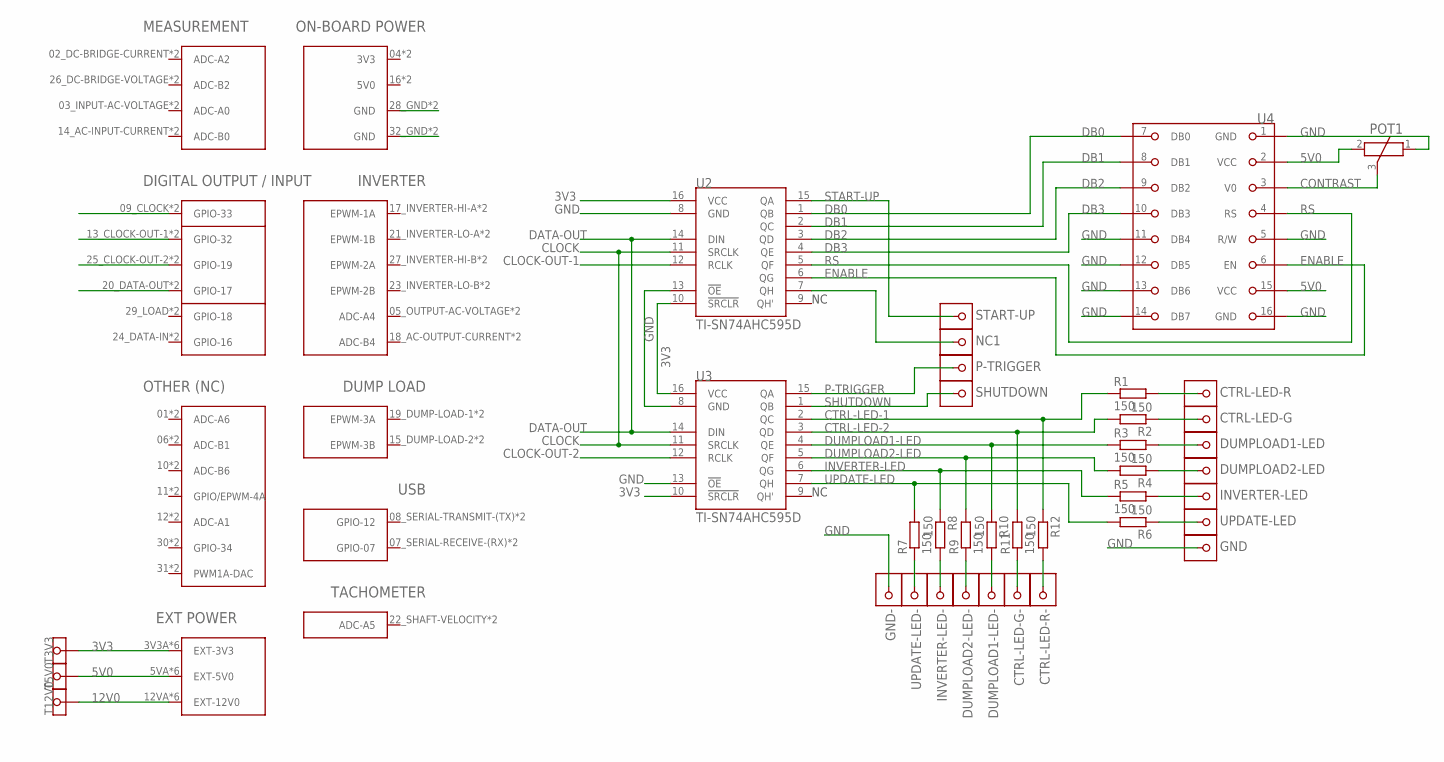
[picture p21: schematic DigitalOut-01.sch]

Parts:
CTRL-LED-G: 1X1HEADER(W/VIA)
CTRL-LED-G-: 1X1HEADER
CTRL-LED-R: 1X1HEADER(W/VIA)
CTRL-LED-R-: 1X1HEADER
DUMPLOAD1-LED, DUMPLOAD2-LED: 1X1HEADER(W/VIA)
DUMPLOAD1-LED-, DUMPLOAD2-LED-: 1X1HEADER
GND: 1X1HEADER(W/VIA)
GND-: 1X1HEADER
INVERTER-LED: 1X1HEADER(W/VIA)
INVERTER-LED-: 1X1HEADER
NC1: 1X1HEADER(W/VIA)
P-TRIGGER: 1X1HEADER(W/VIA)
POT1: BOURNS-3361S
R1, R2, R3, R4, R5, R6, R7, R8, R9, R10, R11, R12: 150; R0805
SHUTDOWN: 1X1HEADER(W/VIA)
START-UP: 1X1HEADER(W/VIA)
T3V3, T5V0, T12V0: TESTPAD
U1: CONTROLLER_STACK
U2, U3: TI-SN74AHC595D; SOIC-16D
U4: MULTICOMP-MC9B232
UPDATE-LED: 1X1HEADER(W/VIA)
UPDATE-LED-: 1X1HEADER

Connections:
3V3: T3V3.TP, U1.3V3A (EXT-3V3), U1.3V3B (EXT-3V3), U1.3V3C (EXT-3V3), U1.3V3D (EXT-3V3), U1.3V3E (EXT-3V3), U1.3V3F (EXT-3V3), U2.10 (!SRCLR), U2.16 (VCC), U3.10 (!SRCLR), U3.16 (VCC)
5V0: POT1.2, T5V0.TP, U1.5VA (EXT-5V0), U1.5VB (EXT-5V0), U1.5VC (EXT-5V0), U1.5VD (EXT-5V0), U1.5VE (EXT-5V0), U1.5VF (EXT-5V0), U4.2 (VCC), U4.15 (VCC)
12V0: T12V0.TP, U1.12VA (EXT-12V0), U1.12VB (EXT-12V0), U1.12VC (EXT-12V0), U1.12VD (EXT-12V0), U1.12VE (EXT-12V0), U1.12VF (EXT-12V0)
CLOCK: U1.09_CLOCK (GPIO-33), U1.C9 (GPIO-33), U2.11 (SRCLK), U3.11 (SRCLK)
CLOCK-OUT-1: U1.13_CLOCK-OUT-1 (GPIO-32), U1.C13 (GPIO-32), U2.12 (RCLK)
CLOCK-OUT-2: U1.25_CLOCK-OUT-2 (GPIO-19), U1.C25 (GPIO-19), U3.12 (RCLK)
CONTRAST: POT1.3, U4.3 (V0)
CTRL-LED-1: R1.1, R12.1, U3.2 (QC)
CTRL-LED-2: R2.2, R11.2, U3.3 (QD)
DATA-OUT: U1.20_DATA-OUT (GPIO-17), U1.C20 (GPIO-17), U2.14 (DIN), U3.14 (DIN)
DB0: U2.1 (QB), U4.7 (DB0)
DB1: U2.2 (QC), U4.8 (DB1)
DB2: U2.3 (QD), U4.9 (DB2)
DB3: U2.4 (QE), U4.10 (DB3)
DUMPLOAD1-LED: R3.1, R10.1, U3.4 (QE)
DUMPLOAD2-LED: R4.2, R9.2, U3.5 (QF)
ENABLE: U2.6 (QG), U4.6 (EN)
GND: GND.P$2, GND.P$3, GND.P$4, GND.PAD, GND-.P$1, POT1.1, U1.28_GND (GND), U1.32_GND (GND), U1.C28 (GND), U1.C32 (GND), U2.8 (GND), U2.13 (!OE), U3.8 (GND), U3.13 (!OE), U4.1 (GND), U4.5 (R/W), U4.11 (DB4), U4.12 (DB5), U4.13 (DB6), U4.14 (DB7), U4.16 (GND)
INVERTER-LED: R5.1, R8.1, U3.6 (QG)
unnamed: R7.1, UPDATE-LED-.P$1
unnamed: INVERTER-LED-.P$1, R8.2
unnamed: DUMPLOAD2-LED-.P$1, R9.1
unnamed: DUMPLOAD1-LED-.P$1, R10.2
unnamed: CTRL-LED-G-.P$1, R11.1
unnamed: CTRL-LED-R.P$2, CTRL-LED-R.P$3, CTRL-LED-R.P$4, CTRL-LED-R.PAD, R1.2
unnamed: CTRL-LED-R-.P$1, R12.2
unnamed: CTRL-LED-G.P$2, CTRL-LED-G.P$3, CTRL-LED-G.P$4, CTRL-LED-G.PAD, R2.1
unnamed: DUMPLOAD1-LED.P$2, DUMPLOAD1-LED.P$3, DUMPLOAD1-LED.P$4, DUMPLOAD1-LED.PAD, R3.2
unnamed: DUMPLOAD2-LED.P$2, DUMPLOAD2-LED.P$3, DUMPLOAD2-LED.P$4, DUMPLOAD2-LED.PAD, R4.1
unnamed: NC1.P$2, NC1.P$3, NC1.P$4, NC1.PAD, U2.7 (QH)
unnamed: INVERTER-LED.P$2, INVERTER-LED.P$3, INVERTER-LED.P$4, INVERTER-LED.PAD, R5.2
unnamed: R6.1, UPDATE-LED.P$2, UPDATE-LED.P$3, UPDATE-LED.P$4, UPDATE-LED.PAD
P-TRIGGER: P-TRIGGER.P$2, P-TRIGGER.P$3, P-TRIGGER.P$4, P-TRIGGER.PAD, U3.15 (QA)
RS: U2.5 (QF), U4.4 (RS)
SHUTDOWN: SHUTDOWN.P$2, SHUTDOWN.P$3, SHUTDOWN.P$4, SHUTDOWN.PAD, U3.1 (QB)
START-UP: START-UP.P$2, START-UP.P$3, START-UP.P$4, START-UP.PAD, U2.15 (QA)
UPDATE-LED: R6.2, R7.2, U3.7 (QH)

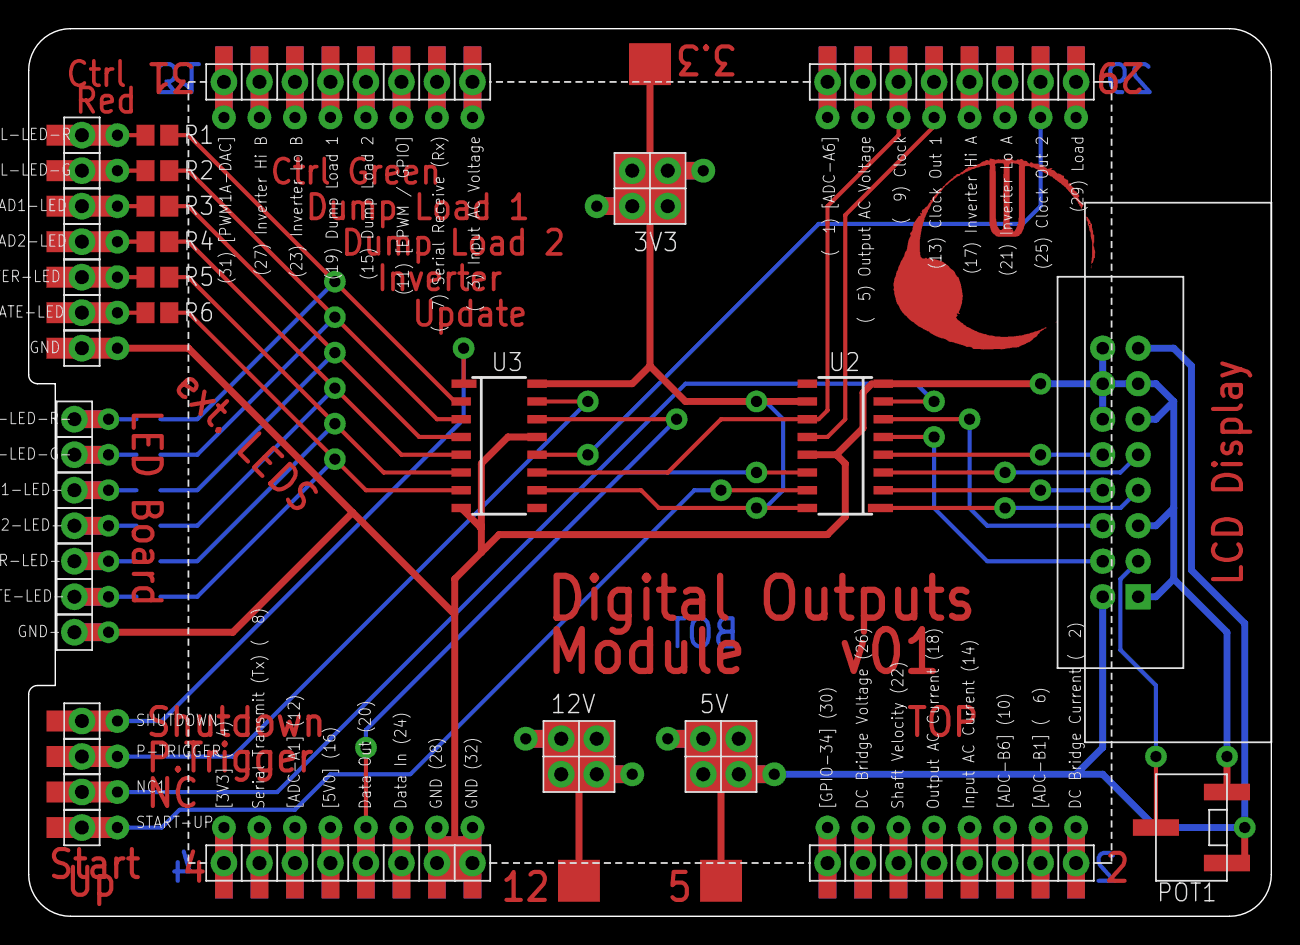
[picture p22: board DigitalOut-01.brd from above]

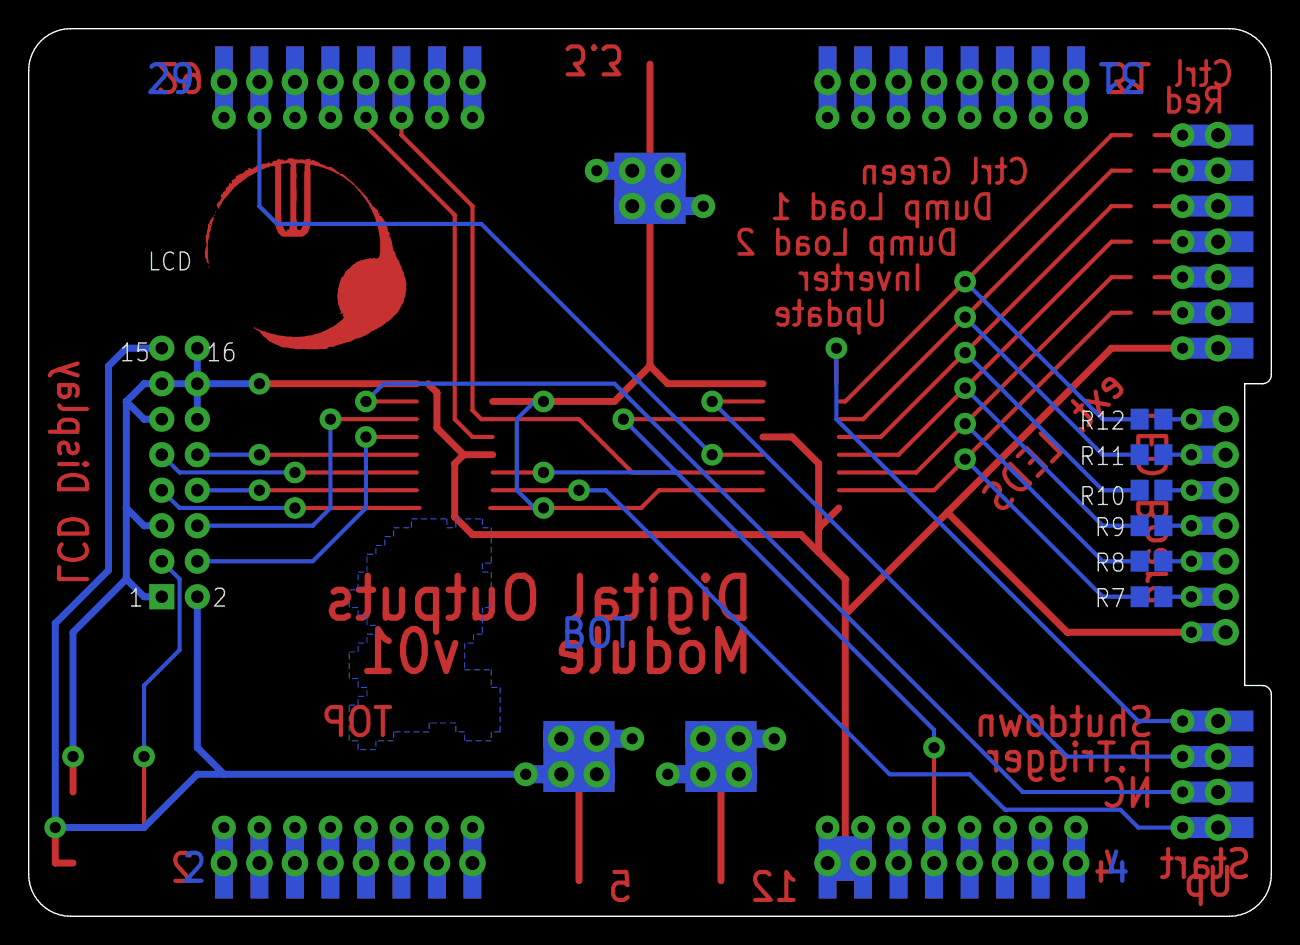
[picture p23: board DigitalOut-01.brd from below]

Board: 2 copper layers, 88.9 x 63.5 mm, 38 parts (6 on the bottom side), 37 nets.
