equinoxorg/Micro-Hydro-ELC/PCB_ControlStack/Measure-02b.brd

## EAGLE design PCB_ControlStack/Measure-02b.brd (2013-05-16)

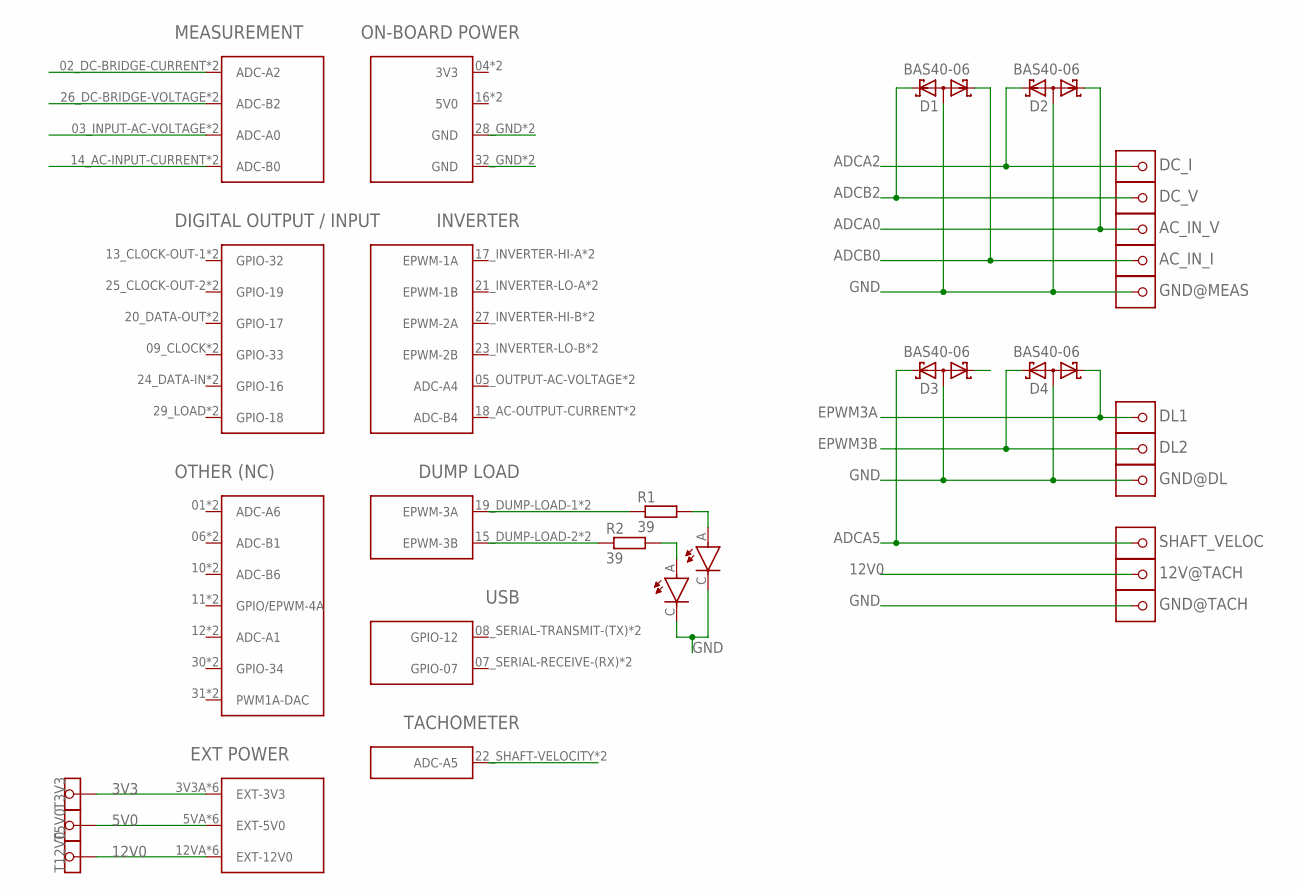
[picture p26: schematic Measure-02b.sch]

Parts:
12V@TACH: 1X1HEADER(W/VIA)
AC_IN_I: 1X1HEADER(W/VIA)
AC_IN_V: 1X1HEADER(W/VIA)
D1, D2, D3, D4: BAS40-06; SOT23
DC_I: 1X1HEADER(W/VIA)
DC_V: 1X1HEADER(W/VIA)
DL1, DL2: 1X1HEADER(W/VIA)
DL.1, DL.2: PLCC2
GND@DL: 1X1HEADER(W/VIA)
GND@MEAS: 1X1HEADER(W/VIA)
GND@TACH: 1X1HEADER(W/VIA)
R1, R2: 39; R0805
SHAFT_VELOC: 1X1HEADER(W/VIA)
T3V3, T5V0, T12V0: TESTPAD
U$1: CONTROLLER_STACK

Connections:
3V3: T3V3.TP, U$1.3V3A (EXT-3V3), U$1.3V3B (EXT-3V3), U$1.3V3C (EXT-3V3), U$1.3V3D (EXT-3V3), U$1.3V3E (EXT-3V3), U$1.3V3F (EXT-3V3)
5V0: T5V0.TP, U$1.5VA (EXT-5V0), U$1.5VB (EXT-5V0), U$1.5VC (EXT-5V0), U$1.5VD (EXT-5V0), U$1.5VE (EXT-5V0), U$1.5VF (EXT-5V0)
12V0: 12V@TACH.P$2, 12V@TACH.P$3, 12V@TACH.P$4, 12V@TACH.PAD, T12V0.TP, U$1.12VA (EXT-12V0), U$1.12VB (EXT-12V0), U$1.12VC (EXT-12V0), U$1.12VD (EXT-12V0), U$1.12VE (EXT-12V0), U$1.12VF (EXT-12V0)
ADCA0: AC_IN_V.P$2, AC_IN_V.P$3, AC_IN_V.P$4, AC_IN_V.PAD, D2.1 (K1), U$1.03_INPUT-AC-VOLTAGE (ADC-A0), U$1.C3 (ADC-A0)
ADCA2: D2.2 (K2), DC_I.P$2, DC_I.P$3, DC_I.P$4, DC_I.PAD, U$1.02_DC-BRIDGE-CURRENT (ADC-A2), U$1.C2 (ADC-A2)
ADCA5: D3.2 (K2), SHAFT_VELOC.P$2, SHAFT_VELOC.P$3, SHAFT_VELOC.P$4, SHAFT_VELOC.PAD, U$1.22_SHAFT-VELOCITY (ADC-A5), U$1.C22 (ADC-A5)
ADCB0: AC_IN_I.P$2, AC_IN_I.P$3, AC_IN_I.P$4, AC_IN_I.PAD, D1.1 (K1), U$1.14_AC-INPUT-CURRENT (ADC-B0), U$1.C14 (ADC-B0)
ADCB2: D1.2 (K2), DC_V.P$2, DC_V.P$3, DC_V.P$4, DC_V.PAD, U$1.26_DC-BRIDGE-VOLTAGE (ADC-B2), U$1.C26 (ADC-B2)
EPWM3A: D4.1 (K1), DL1.P$2, DL1.P$3, DL1.P$4, DL1.PAD, R1.1, U$1.19_DUMP-LOAD-1 (EPWM-3A), U$1.C19 (EPWM-3A)
EPWM3B: D4.2 (K2), DL2.P$2, DL2.P$3, DL2.P$4, DL2.PAD, R2.1, U$1.15_DUMP-LOAD-2 (EPWM-3B), U$1.C15 (EPWM-3B)
GND: D1.3 (AA), D2.3 (AA), D3.3 (AA), D4.3 (AA), DL.1.C, DL.2.C, GND@DL.P$2, GND@DL.P$3, GND@DL.P$4, GND@DL.PAD, GND@MEAS.P$2, GND@MEAS.P$3, GND@MEAS.P$4, GND@MEAS.PAD, GND@TACH.P$2, GND@TACH.P$3, GND@TACH.P$4, GND@TACH.PAD, U$1.28_GND (GND), U$1.32_GND (GND), U$1.C28 (GND), U$1.C32 (GND)
unnamed: DL.2.A, R2.2
unnamed: DL.1.A, R1.2
STARTUP: D3.1 (K1)

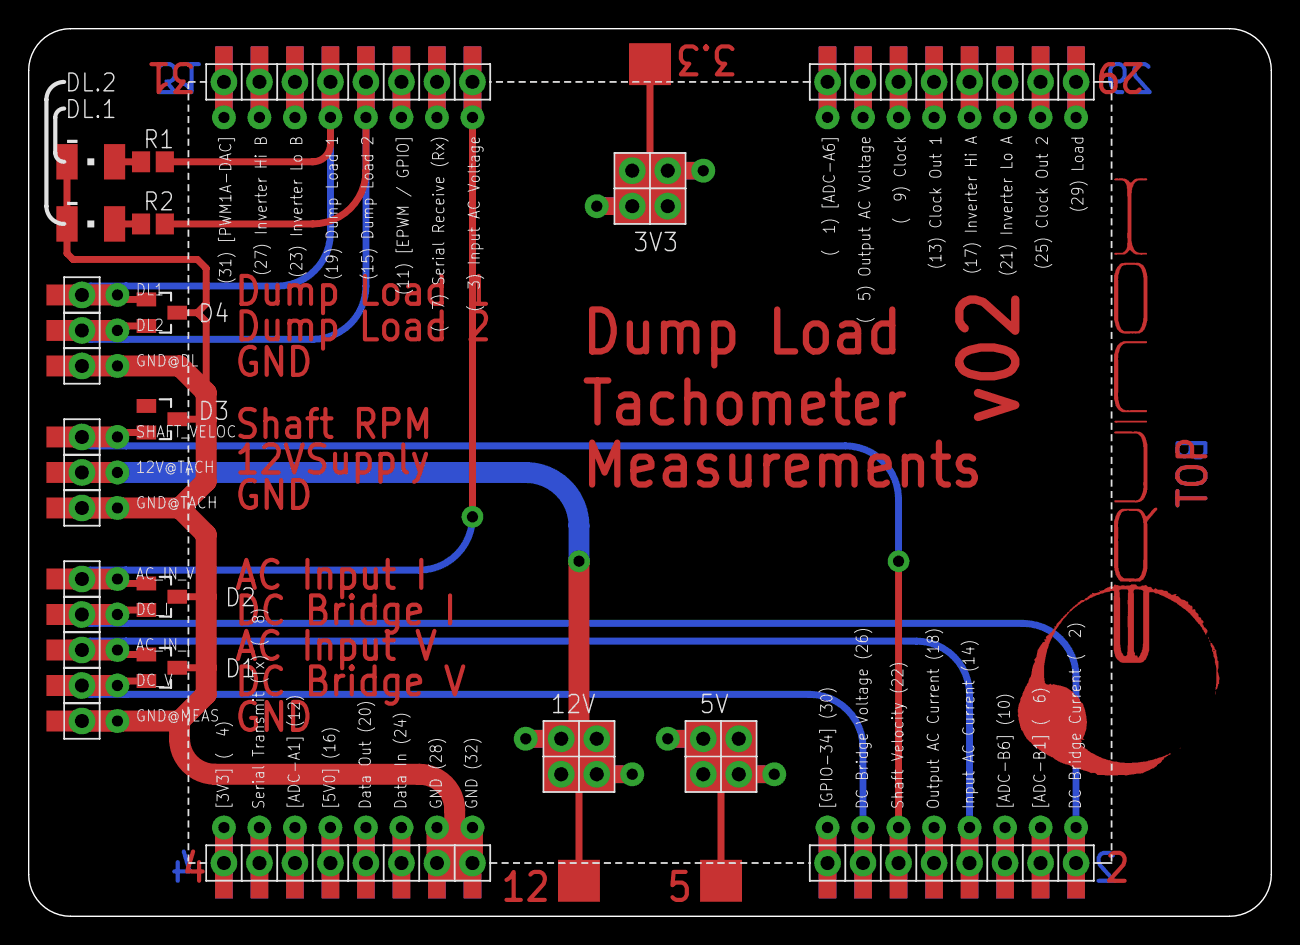
[picture p27: board Measure-02b.brd from above]

Board: 2 copper layers, 88.9 x 63.5 mm, 23 parts (0 on the bottom side), 13 nets.
