equinoxorg/Micro-Hydro-ELC/PCB_ControlStack/DigitalOutLED-02.brd

## EAGLE design PCB_ControlStack/DigitalOutLED-02.brd (2013-05-16)

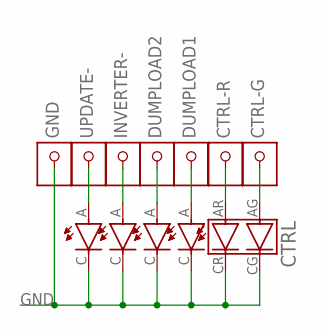
[picture p28: schematic DigitalOutLED-02.sch]

Parts:
CTRL: PLCC4-RG; PLCC4
CTRL-G: 1X1HEADER
CTRL-R: 1X1HEADER
DL1, DL2: PLCC2
DUMPLOAD1, DUMPLOAD2: 1X1HEADER
GND: 1X1HEADER
INVERTER: PLCC2
INVERTER-: 1X1HEADER
UPDATE: PLCC2
UPDATE-: 1X1HEADER

Connections:
GND: CTRL.CG, CTRL.CR, DL1.C, DL2.C, GND.P$1, INVERTER.C, UPDATE.C
unnamed: UPDATE.A, UPDATE-.P$1
unnamed: INVERTER.A, INVERTER-.P$1
unnamed: DL2.A, DUMPLOAD2.P$1
unnamed: DL1.A, DUMPLOAD1.P$1
unnamed: CTRL.AR, CTRL-R.P$1
unnamed: CTRL.AG, CTRL-G.P$1

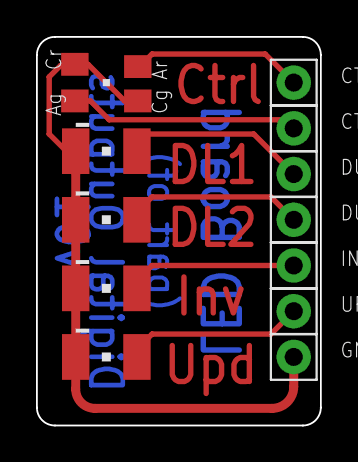
[picture p29: board DigitalOutLED-02.brd from above]

Board: 2 copper layers, 15.8 x 21.6 mm, 12 parts (0 on the bottom side), 7 nets.
