equinoxorg/Micro-Hydro-ELC/PCB_ControlStack/Breakout-02.brd

## EAGLE design PCB_ControlStack/Breakout-02.brd (2013-05-16)

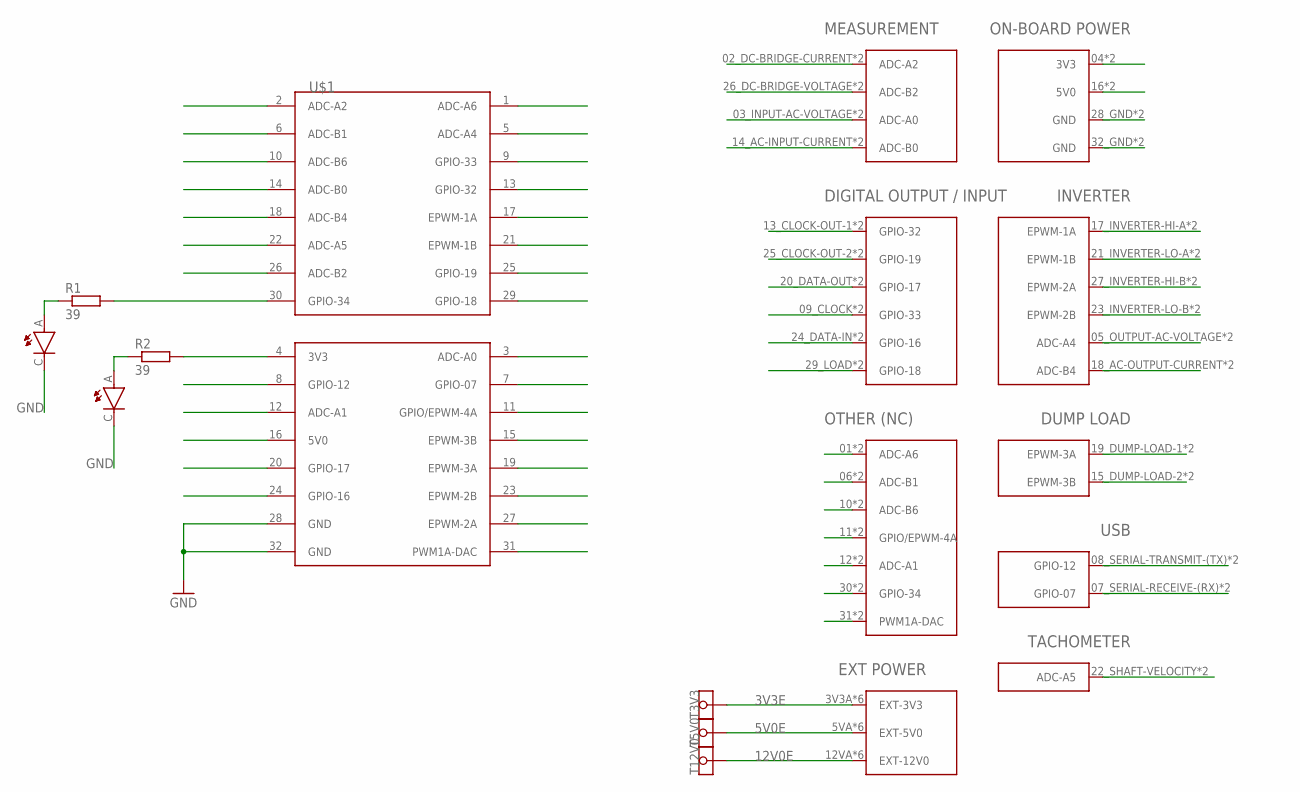
[picture p30: schematic Breakout-02.sch]

Parts:
GPIO34: PLCC2
PWR: PLCC2
R1, R2: 39; R0805
T3V3, T5V0, T12V0: TESTPAD
U$1: CONTROLLER_SOCKET
U$2: CONTROLLER_STACK

Connections:
3V3: R2.2, U$1.4 (3V3), U$2.04 (3V3), U$2.C4 (3V3)
3V3E: T3V3.TP, U$2.3V3A (EXT-3V3), U$2.3V3B (EXT-3V3), U$2.3V3C (EXT-3V3), U$2.3V3D (EXT-3V3), U$2.3V3E (EXT-3V3), U$2.3V3F (EXT-3V3)
5V0: U$1.16 (5V0), U$2.16 (5V0), U$2.C16 (5V0)
5V0E: T5V0.TP, U$2.5VA (EXT-5V0), U$2.5VB (EXT-5V0), U$2.5VC (EXT-5V0), U$2.5VD (EXT-5V0), U$2.5VE (EXT-5V0), U$2.5VF (EXT-5V0)
12V0E: T12V0.TP, U$2.12VA (EXT-12V0), U$2.12VB (EXT-12V0), U$2.12VC (EXT-12V0), U$2.12VD (EXT-12V0), U$2.12VE (EXT-12V0), U$2.12VF (EXT-12V0)
ADCA0: U$1.3 (ADC-A0), U$2.03_INPUT-AC-VOLTAGE (ADC-A0), U$2.C3 (ADC-A0)
ADCA1: U$1.12 (ADC-A1), U$2.12 (ADC-A1), U$2.C12 (ADC-A1)
ADCA2: U$1.2 (ADC-A2), U$2.02_DC-BRIDGE-CURRENT (ADC-A2), U$2.C2 (ADC-A2)
ADCA4: U$1.5 (ADC-A4), U$2.05_OUTPUT-AC-VOLTAGE (ADC-A4), U$2.C5 (ADC-A4)
ADCA5: U$1.22 (ADC-A5), U$2.22_SHAFT-VELOCITY (ADC-A5), U$2.C22 (ADC-A5)
ADCA6: U$1.1 (ADC-A6), U$2.01 (ADC-A6), U$2.C1 (ADC-A6)
ADCB0: U$1.14 (ADC-B0), U$2.14_AC-INPUT-CURRENT (ADC-B0), U$2.C14 (ADC-B0)
ADCB1: U$1.6 (ADC-B1), U$2.06 (ADC-B1), U$2.C6 (ADC-B1)
ADCB2: U$1.26 (ADC-B2), U$2.26_DC-BRIDGE-VOLTAGE (ADC-B2), U$2.C26 (ADC-B2)
ADCB4: U$1.18 (ADC-B4), U$2.18_AC-OUTPUT-CURRENT (ADC-B4), U$2.C18 (ADC-B4)
ADCB6: U$1.10 (ADC-B6), U$2.10 (ADC-B6), U$2.C10 (ADC-B6)
EPWM1A: U$1.17 (EPWM-1A), U$2.17_INVERTER-HI-A (EPWM-1A), U$2.C17 (EPWM-1A)
EPWM1B: U$1.21 (EPWM-1B), U$2.21_INVERTER-LO-A (EPWM-1B), U$2.C21 (EPWM-1B)
EPWM2A: U$1.27 (EPWM-2A), U$2.27_INVERTER-HI-B (EPWM-2A), U$2.C27 (EPWM-2A)
EPWM2B: U$1.23 (EPWM-2B), U$2.23_INVERTER-LO-B (EPWM-2B), U$2.C23 (EPWM-2B)
EPWM3A: U$1.19 (EPWM-3A), U$2.19_DUMP-LOAD-1 (EPWM-3A), U$2.C19 (EPWM-3A)
EPWM3B: U$1.15 (EPWM-3B), U$2.15_DUMP-LOAD-2 (EPWM-3B), U$2.C15 (EPWM-3B)
EPWM4A: U$1.11 (GPIO/EPWM-4A), U$2.11 (GPIO/EPWM-4A), U$2.C11 (GPIO/EPWM-4A)
GND: GPIO34.C, PWR.C, U$1.28 (GND), U$1.32 (GND), U$2.28_GND (GND), U$2.32_GND (GND), U$2.C28 (GND), U$2.C32 (GND)
GPIO07: U$1.7 (GPIO-07), U$2.07_SERIAL-RECEIVE-(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 (GPIO-07), U$2.C7 (GPIO-07)
GPIO12: U$1.8 (GPIO-12), U$2.08_SERIAL-TRANSMIT-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 (GPIO-12), U$2.C8 (GPIO-12)
GPIO16: U$1.24 (GPIO-16), U$2.24_DATA-IN (GPIO-16), U$2.C24 (GPIO-16)
GPIO17: U$1.20 (GPIO-17), U$2.20_DATA-OUT (GPIO-17), U$2.C20 (GPIO-17)
GPIO18: U$1.29 (GPIO-18), U$2.29_LOAD (GPIO-18), U$2.C29 (GPIO-18)
GPIO19: U$1.25 (GPIO-19), U$2.25_CLOCK-OUT-2 (GPIO-19), U$2.C25 (GPIO-19)
GPIO32: U$1.13 (GPIO-32), U$2.13_CLOCK-OUT-1 (GPIO-32), U$2.C13 (GPIO-32)
GPIO33: U$1.9 (GPIO-33), U$2.09_CLOCK (GPIO-33), U$2.C9 (GPIO-33)
GPIO34: R1.2, U$1.30 (GPIO-34), U$2.30 (GPIO-34), U$2.C30 (GPIO-34)
unnamed: PWR.A, R2.1
unnamed: GPIO34.A, R1.1
PWM1ADAC: U$1.31 (PWM1A-DAC), U$2.31 (PWM1A-DAC), U$2.C31 (PWM1A-DAC)

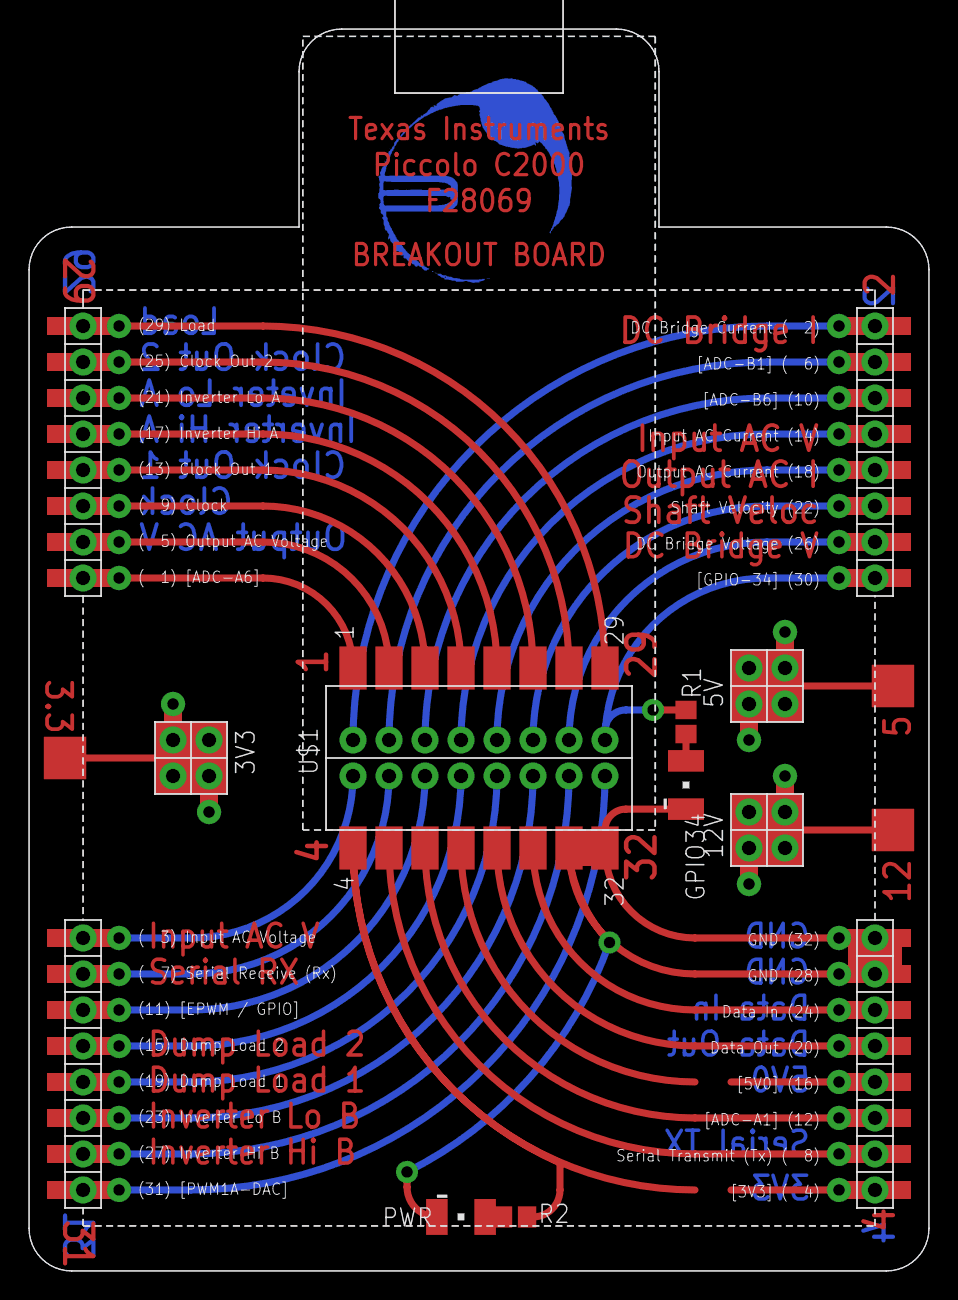
[picture p31: board Breakout-02.brd from above]

Board: 2 copper layers, 63.5 x 87.6 mm, 9 parts (0 on the bottom side), 36 nets.
