equinoxorg/Micro-Hydro-ELC/PCB_ControlStack/Breakout-01.brd

## EAGLE design PCB_ControlStack/Breakout-01.brd (2013-05-16)

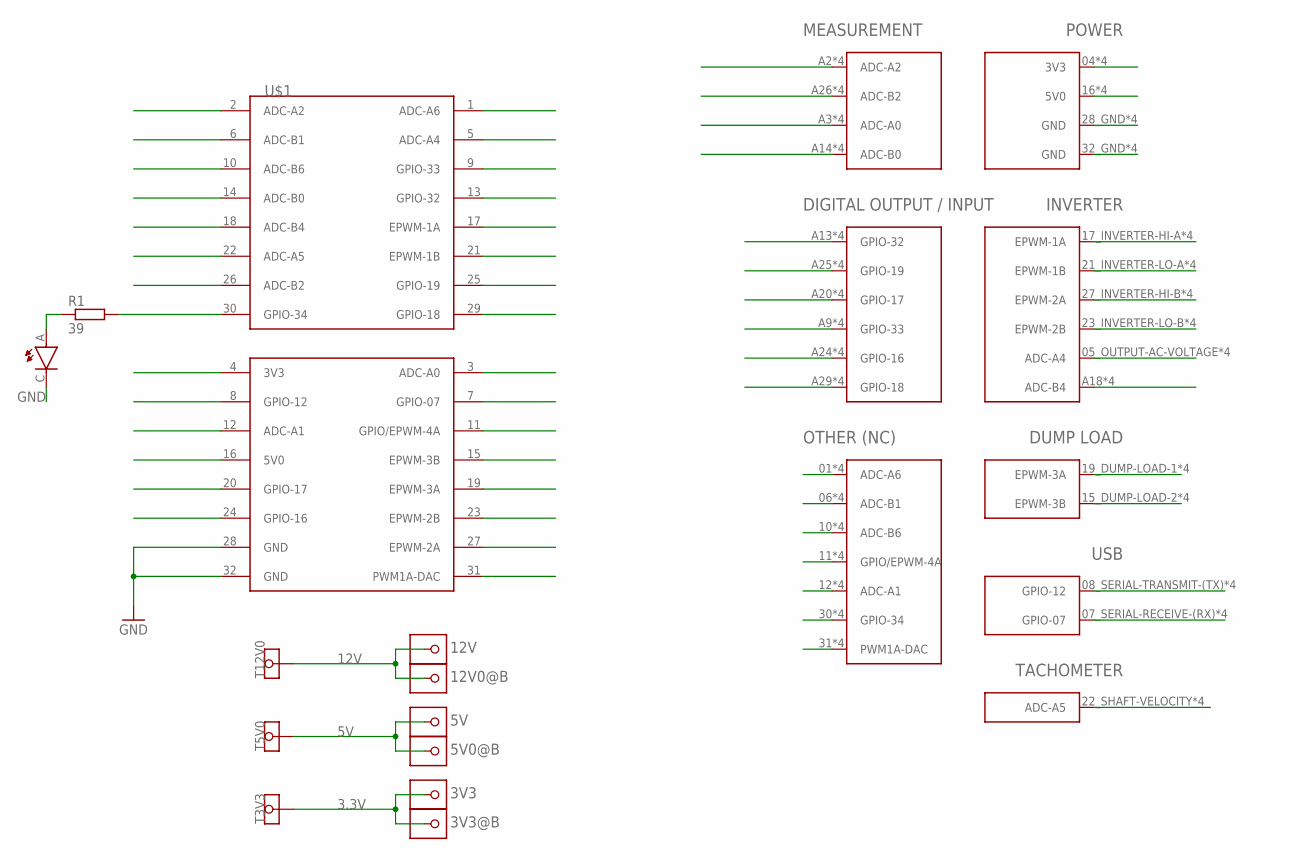
[picture p32: schematic Breakout-01.sch]

Parts:
3V3, 3V3@B, 5V, 5V0@B, 12V, 12V0@B: 1X1STACK
GPIO34: PLCC2
R1: 39; R0805
T3V3, T5V0, T12V0: TESTPAD
U$1: CONTROLLER_SOCKET
U$2: CONTROLLER_STACK

Connections:
3.3V: 3V3.P$2, 3V3.P$5, 3V3.P$58, 3V3.P$65, 3V3.PAD, 3V3@B.P$2, 3V3@B.P$5, 3V3@B.P$58, 3V3@B.P$65, 3V3@B.PAD, T3V3.TP
3V3: U$1.4 (3V3), U$2.04 (3V3), U$2.A4 (3V3), U$2.B4 (3V3), U$2.C4 (3V3)
5V: 5V.P$2, 5V.P$5, 5V.P$58, 5V.P$65, 5V.PAD, 5V0@B.P$2, 5V0@B.P$5, 5V0@B.P$58, 5V0@B.P$65, 5V0@B.PAD, T5V0.TP
5V0: U$1.16 (5V0), U$2.16 (5V0), U$2.A16 (5V0), U$2.B16 (5V0), U$2.C16 (5V0)
12V: 12V.P$2, 12V.P$5, 12V.P$58, 12V.P$65, 12V.PAD, 12V0@B.P$2, 12V0@B.P$5, 12V0@B.P$58, 12V0@B.P$65, 12V0@B.PAD, T12V0.TP
ADCA0: U$1.3 (ADC-A0), U$2.A3 (ADC-A0), U$2.B3 (ADC-A0), U$2.C3 (ADC-A0), U$2.INPUT-AC-VOLTAGE_03 (ADC-A0)
ADCA1: U$1.12 (ADC-A1), U$2.12 (ADC-A1), U$2.A12 (ADC-A1), U$2.B12 (ADC-A1), U$2.C12 (ADC-A1)
ADCA2: U$1.2 (ADC-A2), U$2.A2 (ADC-A2), U$2.B2 (ADC-A2), U$2.C2 (ADC-A2), U$2.DC-BRIDGE-CURRENT_02 (ADC-A2)
ADCA4: U$1.5 (ADC-A4), U$2.05_OUTPUT-AC-VOLTAGE (ADC-A4), U$2.A5 (ADC-A4), U$2.B5 (ADC-A4), U$2.C5 (ADC-A4)
ADCA5: U$1.22 (ADC-A5), U$2.22_SHAFT-VELOCITY (ADC-A5), U$2.A22 (ADC-A5), U$2.B22 (ADC-A5), U$2.C22 (ADC-A5)
ADCA6: U$1.1 (ADC-A6), U$2.01 (ADC-A6), U$2.A1 (ADC-A6), U$2.B1 (ADC-A6), U$2.C1 (ADC-A6)
ADCB0: U$1.14 (ADC-B0), U$2.A14 (ADC-B0), U$2.AC-INPUT-CURRENT_14 (ADC-B0), U$2.B14 (ADC-B0), U$2.C14 (ADC-B0)
ADCB1: U$1.6 (ADC-B1), U$2.06 (ADC-B1), U$2.A6 (ADC-B1), U$2.B6 (ADC-B1), U$2.C6 (ADC-B1)
ADCB2: U$1.26 (ADC-B2), U$2.A26 (ADC-B2), U$2.B26 (ADC-B2), U$2.C26 (ADC-B2), U$2.DC-BRIDGE-VOLTAGE_26 (ADC-B2)
ADCB4: U$1.18 (ADC-B4), U$2.A18 (ADC-B4), U$2.AC-OUTPUT-CURRENT_18 (ADC-B4), U$2.B18 (ADC-B4), U$2.C18 (ADC-B4)
ADCB6: U$1.10 (ADC-B6), U$2.10 (ADC-B6), U$2.A10 (ADC-B6), U$2.B10 (ADC-B6), U$2.C10 (ADC-B6)
EPWM1A: U$1.17 (EPWM-1A), U$2.17_INVERTER-HI-A (EPWM-1A), U$2.A17 (EPWM-1A), U$2.B17 (EPWM-1A), U$2.C17 (EPWM-1A)
EPWM1B: U$1.21 (EPWM-1B), U$2.21_INVERTER-LO-A (EPWM-1B), U$2.A21 (EPWM-1B), U$2.B21 (EPWM-1B), U$2.C21 (EPWM-1B)
EPWM2A: U$1.27 (EPWM-2A), U$2.27_INVERTER-HI-B (EPWM-2A), U$2.A27 (EPWM-2A), U$2.B27 (EPWM-2A), U$2.C27 (EPWM-2A)
EPWM2B: U$1.23 (EPWM-2B), U$2.23_INVERTER-LO-B (EPWM-2B), U$2.A23 (EPWM-2B), U$2.B23 (EPWM-2B), U$2.C23 (EPWM-2B)
EPWM3A: U$1.19 (EPWM-3A), U$2.19_DUMP-LOAD-1 (EPWM-3A), U$2.A19 (EPWM-3A), U$2.B19 (EPWM-3A), U$2.C19 (EPWM-3A)
EPWM3B: U$1.15 (EPWM-3B), U$2.15_DUMP-LOAD-2 (EPWM-3B), U$2.A15 (EPWM-3B), U$2.B15 (EPWM-3B), U$2.C15 (EPWM-3B)
EPWM4A: U$1.11 (GPIO/EPWM-4A), U$2.11 (GPIO/EPWM-4A), U$2.A11 (GPIO/EPWM-4A), U$2.B11 (GPIO/EPWM-4A), U$2.C11 (GPIO/EPWM-4A)
GND: GPIO34.C, U$1.28 (GND), U$1.32 (GND), U$2.28_GND (GND), U$2.32_GND (GND), U$2.A28 (GND), U$2.A32 (GND), U$2.B28 (GND), U$2.B32 (GND), U$2.C28 (GND), U$2.C32 (GND)
GPIO07: U$1.7 (GPIO-07), U$2.07_SERIAL-RECEIVE-(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 (GPIO-07), U$2.A7 (GPIO-07), U$2.B7 (GPIO-07), U$2.C7 (GPIO-07)
GPIO12: U$1.8 (GPIO-12), U$2.08_SERIAL-TRANSMIT-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 (GPIO-12), U$2.A8 (GPIO-12), U$2.B8 (GPIO-12), U$2.C8 (GPIO-12)
GPIO16: U$1.24 (GPIO-16), U$2.A24 (GPIO-16), U$2.B24 (GPIO-16), U$2.C24 (GPIO-16), U$2.DATA-IN_24 (GPIO-16)
GPIO17: U$1.20 (GPIO-17), U$2.A20 (GPIO-17), U$2.B20 (GPIO-17), U$2.C20 (GPIO-17), U$2.DATA-OUT_20 (GPIO-17)
GPIO18: U$1.29 (GPIO-18), U$2.A29 (GPIO-18), U$2.B29 (GPIO-18), U$2.C29 (GPIO-18), U$2.LOAD_29 (GPIO-18)
GPIO19: U$1.25 (GPIO-19), U$2.A25 (GPIO-19), U$2.B25 (GPIO-19), U$2.C25 (GPIO-19), U$2.CLOCK-OUT-2_25 (GPIO-19)
GPIO32: U$1.13 (GPIO-32), U$2.A13 (GPIO-32), U$2.B13 (GPIO-32), U$2.C13 (GPIO-32), U$2.CLOCK-OUT-1_13 (GPIO-32)
GPIO33: U$1.9 (GPIO-33), U$2.A9 (GPIO-33), U$2.B9 (GPIO-33), U$2.C9 (GPIO-33), U$2.CLOCK_09 (GPIO-33)
GPIO34: R1.2, U$1.30 (GPIO-34), U$2.30 (GPIO-34), U$2.A30 (GPIO-34), U$2.B30 (GPIO-34), U$2.C30 (GPIO-34)
unnamed: GPIO34.A, R1.1
PWM1ADAC: U$1.31 (PWM1A-DAC), U$2.31 (PWM1A-DAC), U$2.A31 (PWM1A-DAC), U$2.B31 (PWM1A-DAC), U$2.C31 (PWM1A-DAC)

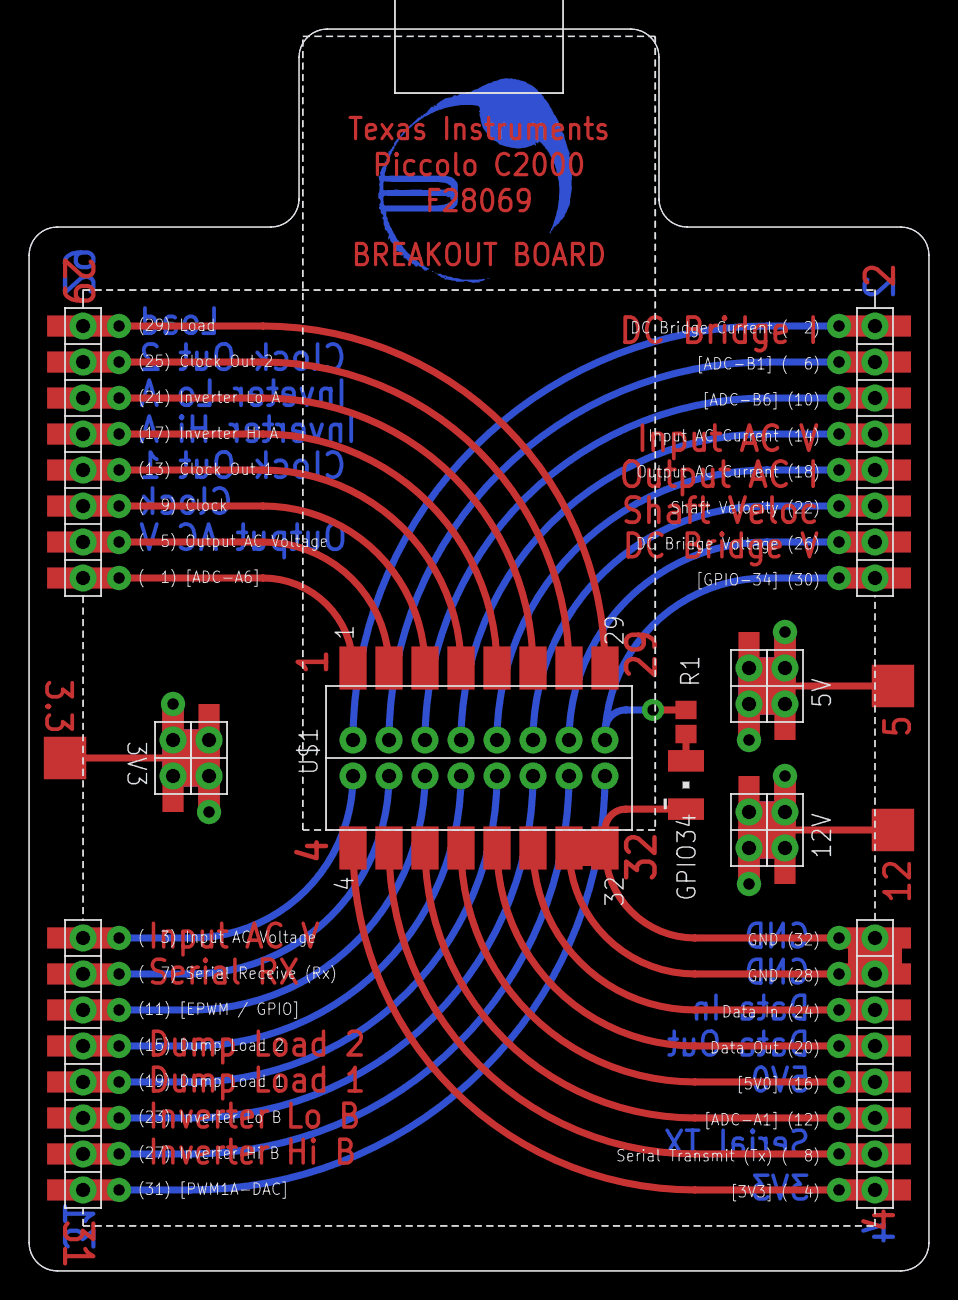
[picture p33: board Breakout-01.brd from above]

Board: 2 copper layers, 63.5 x 87.6 mm, 13 parts (0 on the bottom side), 35 nets.
