equinoxorg/Micro-Hydro-ELC/PCB_ControlStack/DigitalIn-01b.brd

## EAGLE design PCB_ControlStack/DigitalIn-01b.brd (2013-05-16)

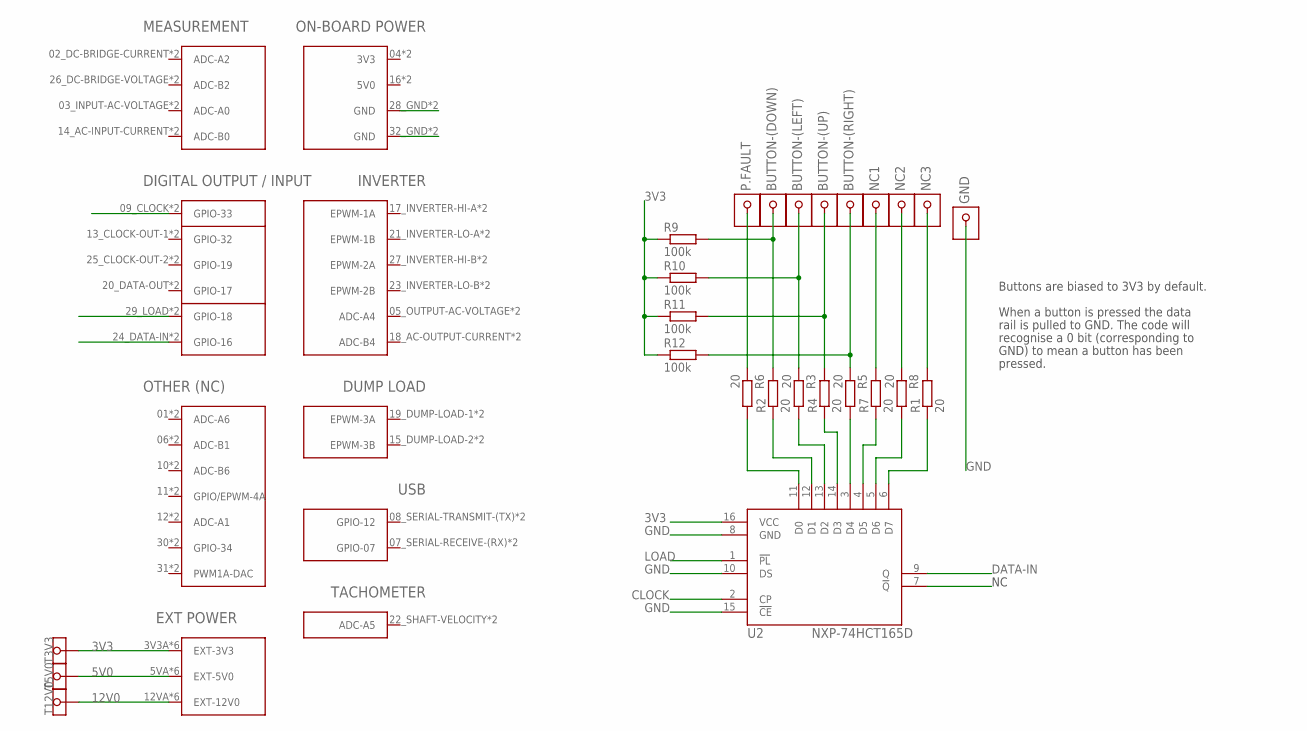
[picture p34: schematic DigitalIn-01b.sch]

Parts:
BUTTON-(DOWN): 1X1HEADER(W/VIA)
BUTTON-(LEFT): 1X1HEADER(W/VIA)
BUTTON-(RIGHT): 1X1HEADER(W/VIA)
BUTTON-(UP): 1X1HEADER(W/VIA)
GND: 1X1HEADER(W/VIA)
NC1, NC2, NC3: 1X1HEADER(W/VIA)
P.FAULT: 1X1HEADER(W/VIA)
R1, R2, R3, R4, R5, R6, R7, R8: 20; R0805
R9, R10, R11, R12: 100k; R0805
T3V3, T5V0, T12V0: TESTPAD
U1: CONTROLLER_STACK
U2: NXP-74HCT165D; SOIC-16D

Connections:
3V3: R9.1, R10.1, R11.1, R12.1, T3V3.TP, U1.3V3A (EXT-3V3), U1.3V3B (EXT-3V3), U1.3V3C (EXT-3V3), U1.3V3D (EXT-3V3), U1.3V3E (EXT-3V3), U1.3V3F (EXT-3V3), U2.16 (VCC)
5V0: T5V0.TP, U1.5VA (EXT-5V0), U1.5VB (EXT-5V0), U1.5VC (EXT-5V0), U1.5VD (EXT-5V0), U1.5VE (EXT-5V0), U1.5VF (EXT-5V0)
12V0: T12V0.TP, U1.12VA (EXT-12V0), U1.12VB (EXT-12V0), U1.12VC (EXT-12V0), U1.12VD (EXT-12V0), U1.12VE (EXT-12V0), U1.12VF (EXT-12V0)
CLOCK: U1.09_CLOCK (GPIO-33), U1.C9 (GPIO-33), U2.2 (CP)
DATA-IN: U1.24_DATA-IN (GPIO-16), U1.C24 (GPIO-16), U2.9 (Q)
GND: GND.P$2, GND.P$3, GND.P$4, GND.PAD, U1.28_GND (GND), U1.32_GND (GND), U1.C28 (GND), U1.C32 (GND), U2.8 (GND), U2.10 (DS), U2.15 (!CE)
LOAD: U1.29_LOAD (GPIO-18), U1.C29 (GPIO-18), U2.1 (!PL)
unnamed: R6.2, U2.11 (D0)
unnamed: R2.1, U2.12 (D1)
unnamed: R3.2, U2.13 (D2)
unnamed: R4.1, U2.14 (D3)
unnamed: P.FAULT.P$2, P.FAULT.P$3, P.FAULT.P$4, P.FAULT.PAD, R6.1
unnamed: R7.1, U2.4 (D5)
unnamed: R8.2, U2.5 (D6)
unnamed: R1.1, U2.6 (D7)
unnamed: R5.2, U2.3 (D4)
unnamed: BUTTON-(DOWN).P$2, BUTTON-(DOWN).P$3, BUTTON-(DOWN).P$4, BUTTON-(DOWN).PAD, R2.2, R9.2
unnamed: BUTTON-(LEFT).P$2, BUTTON-(LEFT).P$3, BUTTON-(LEFT).P$4, BUTTON-(LEFT).PAD, R3.1, R10.2
unnamed: BUTTON-(UP).P$2, BUTTON-(UP).P$3, BUTTON-(UP).P$4, BUTTON-(UP).PAD, R4.2, R11.2
unnamed: BUTTON-(RIGHT).P$2, BUTTON-(RIGHT).P$3, BUTTON-(RIGHT).P$4, BUTTON-(RIGHT).PAD, R5.1, R12.2
unnamed: NC1.P$2, NC1.P$3, NC1.P$4, NC1.PAD, R7.2
unnamed: NC2.P$2, NC2.P$3, NC2.P$4, NC2.PAD, R8.1
unnamed: NC3.P$2, NC3.P$3, NC3.P$4, NC3.PAD, R1.2

Notes on the sheet:
Buttons are biased to 3V3 by default.
When a button is pressed the data
rail is pulled to GND. The code will
recognise a 0 bit (corresponding to
GND) to mean a button has been
pressed.

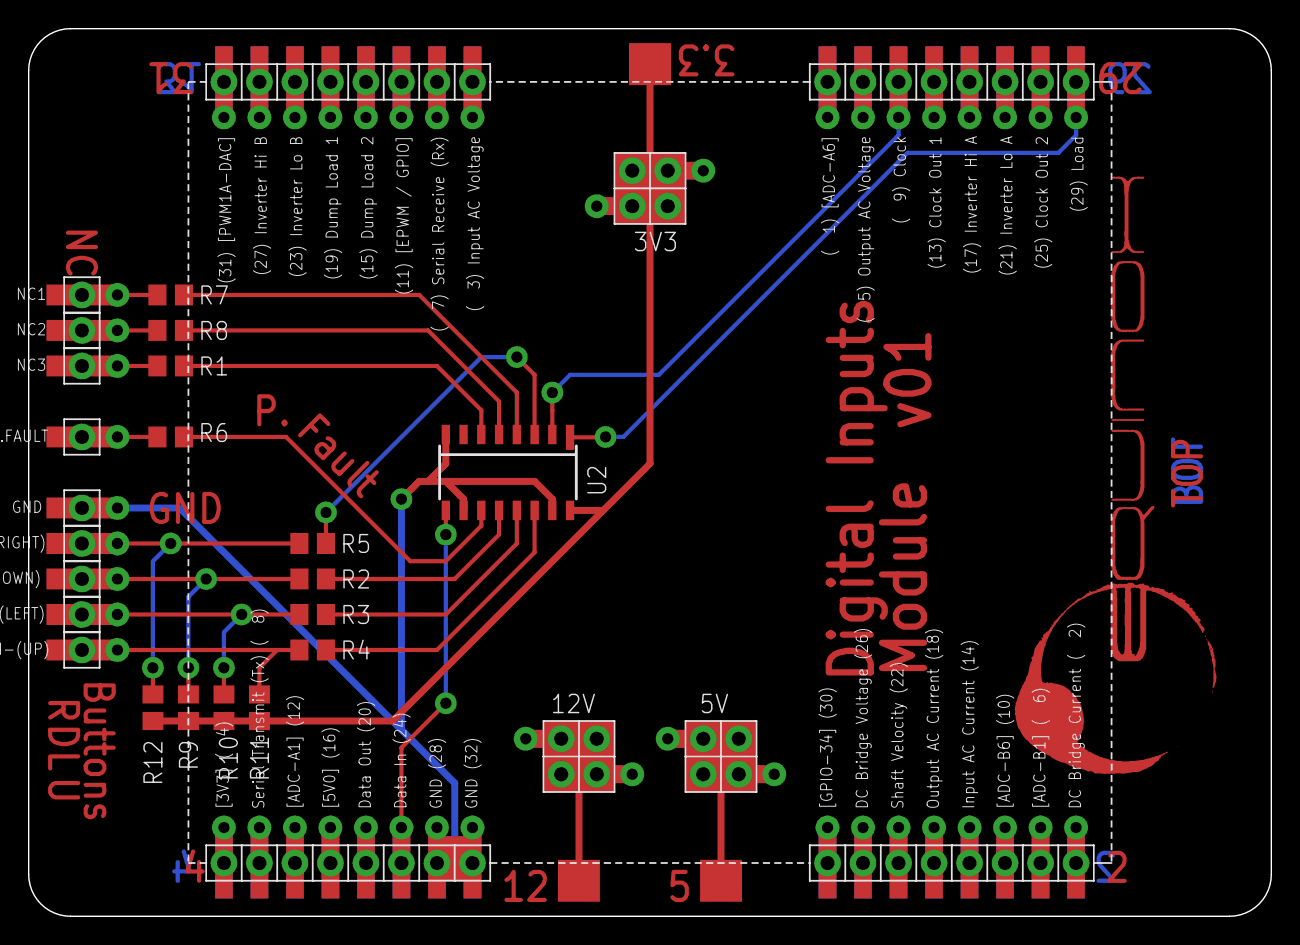
[picture p35: board DigitalIn-01b.brd from above]

Board: 2 copper layers, 88.9 x 63.5 mm, 26 parts (0 on the bottom side), 23 nets.
