equinoxorg/Micro-Hydro-ELC/board_dumpload/Dump Load 2.brd

## EAGLE design board_dumpload/Dump Load 2.brd (2012-08-17)

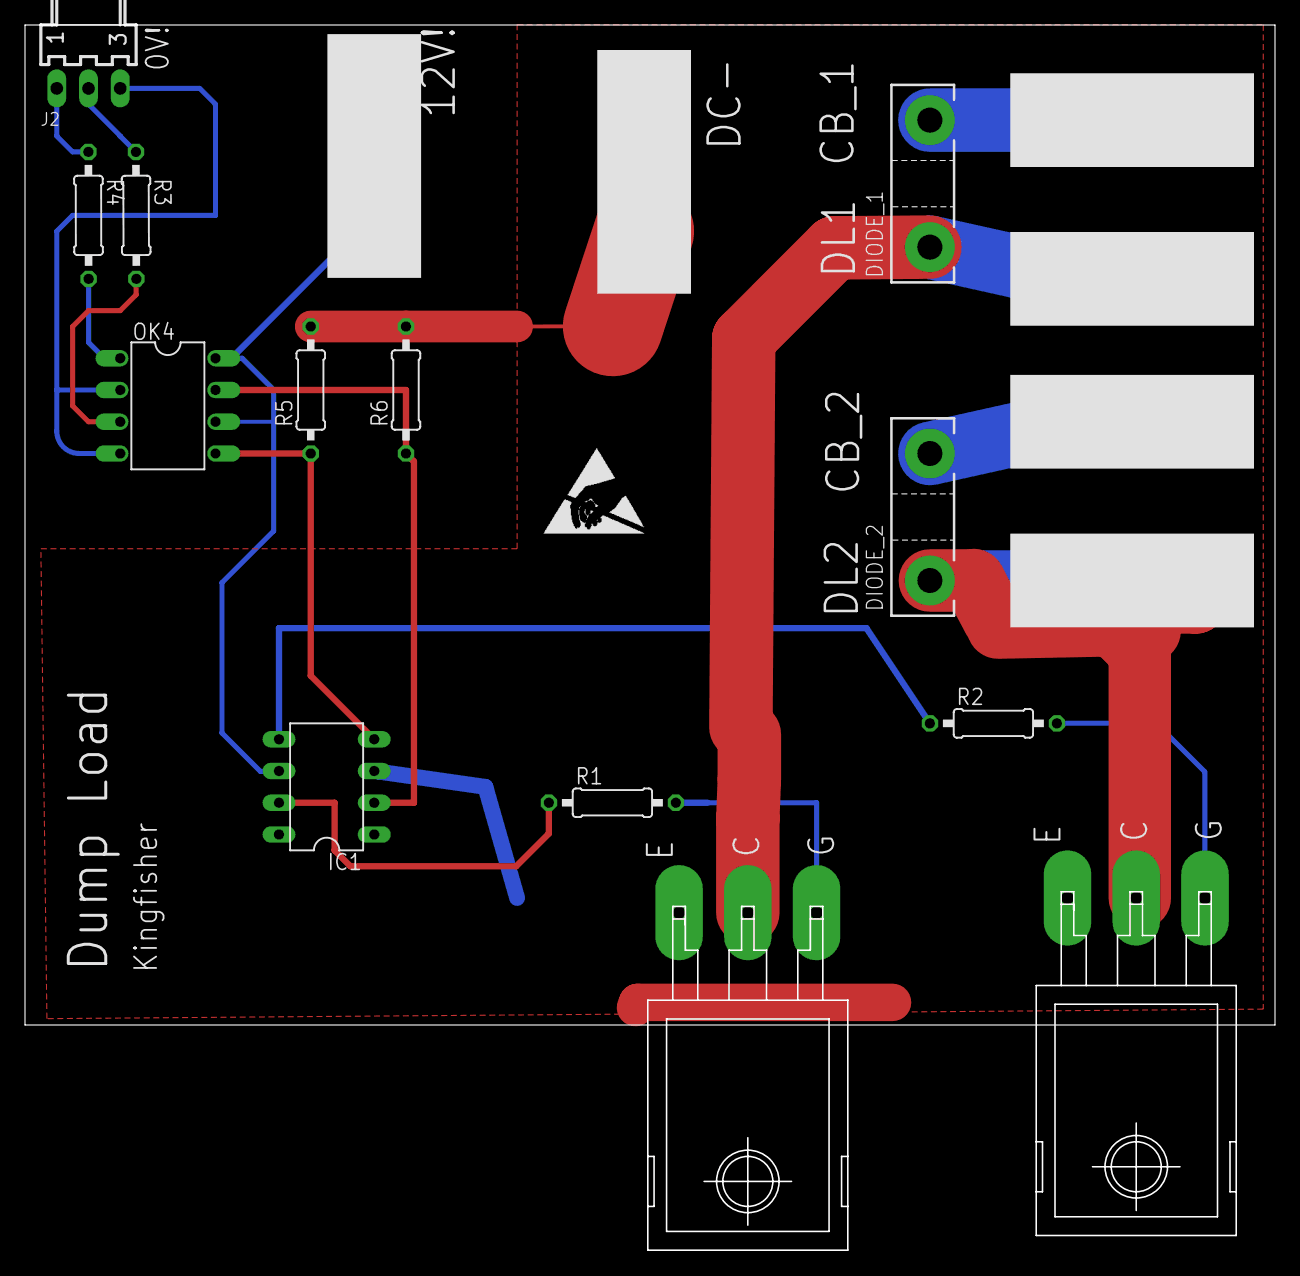
[picture p36: board Dump Load 2.brd from above]

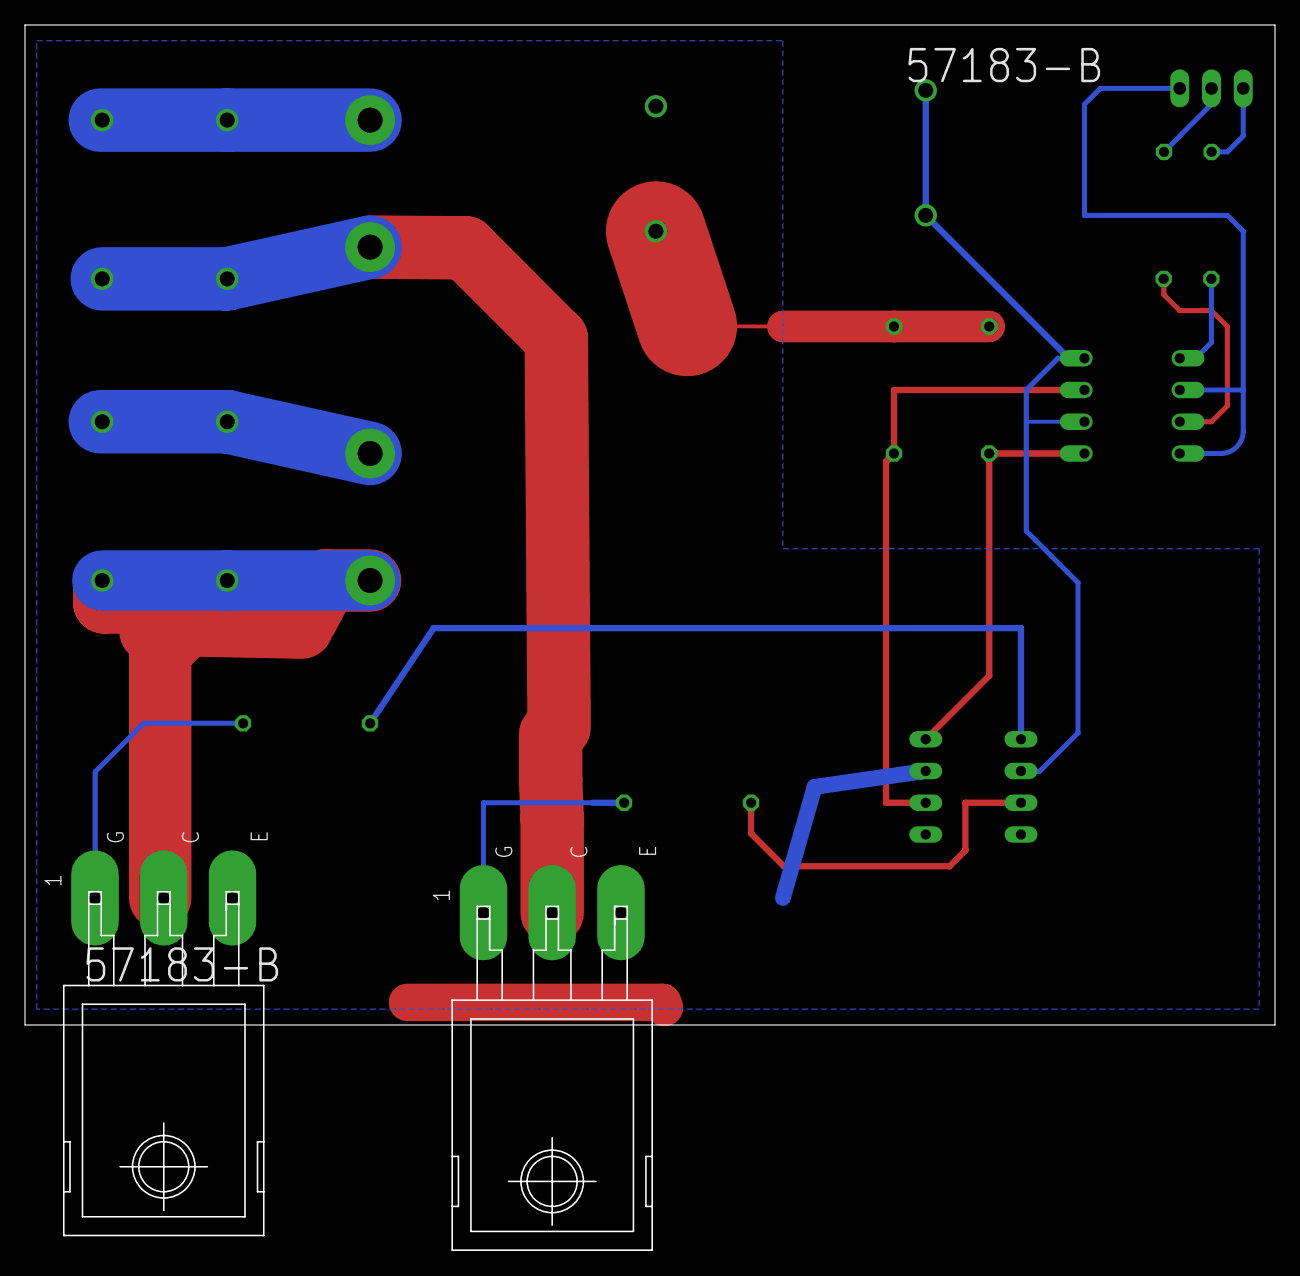
[picture p37: board Dump Load 2.brd from below]

Board: 2 copper layers, 100.0 x 80.0 mm, 19 parts (2 on the bottom side), 17 nets.

Parts:
DC_CB_1, DC_CB_2: HIGH_AMP_TERMINAL
DIODE_1, DIODE_2: TO-247-2V
DL1, DL2: HIGH_AMP_TERMINAL
IC1: DIL08
J2: 22-05-7038-03; 7395-03
OK4: TIL198; DIL08
R1, R2, R3, R4, R5, R6: 0207/10
U$1, U$2: TO-247C; TO-247-FLATUD
U$4: HIGH_AMP_TERMINAL
VCC_12V: HIGH_AMP_TERMINAL

Connections:
DC-: IC1.3, R5.2, R6.2, U$1.P$3, U$2.P$3, U$4.P$1, U$4.P$2
GND: J2.3, OK4.2, OK4.4
unnamed: R1.2, U$1.P$1
unnamed: R2.2, U$2.P$1
unnamed: IC1.4, OK4.5, R5.1
unnamed: IC1.7, R1.1
unnamed: IC1.5, R2.1
unnamed: J2.1, R4.1
unnamed: IC1.6, OK4.6, OK4.8, VCC_12V.P$1, VCC_12V.P$2
unnamed: DIODE_2.1, DL2.P$1, DL2.P$2, U$2.P$2
unnamed: OK4.3, R3.2
unnamed: J2.2, R3.1
unnamed: OK4.1, R4.2
unnamed: DC_CB_1.P$1, DC_CB_1.P$2, DIODE_1.2
unnamed: IC1.2, OK4.7, R6.1
unnamed: DIODE_1.1, DL1.P$1, DL1.P$2, U$1.P$2
unnamed: DC_CB_2.P$1, DC_CB_2.P$2, DIODE_2.2
