equinoxorg/Micro-Hydro-ELC/board_controller/controller 2.brd

## EAGLE design board_controller/controller 2.brd (2012-08-17)

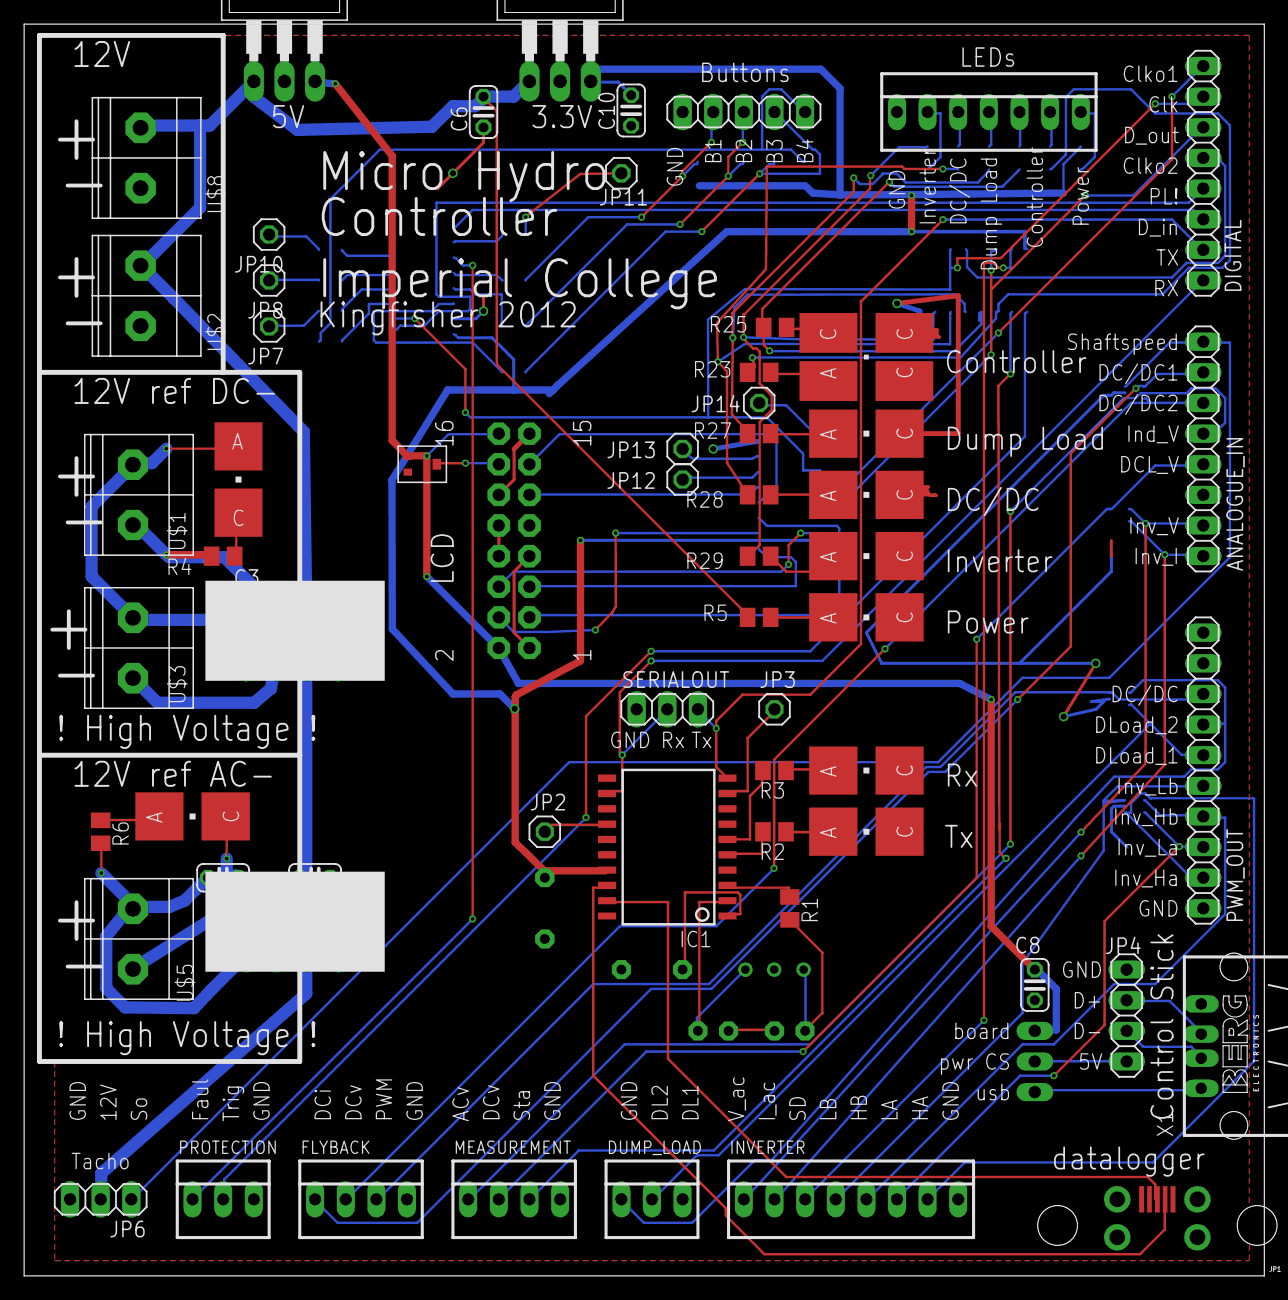
[picture p38: board controller 2.brd from above]

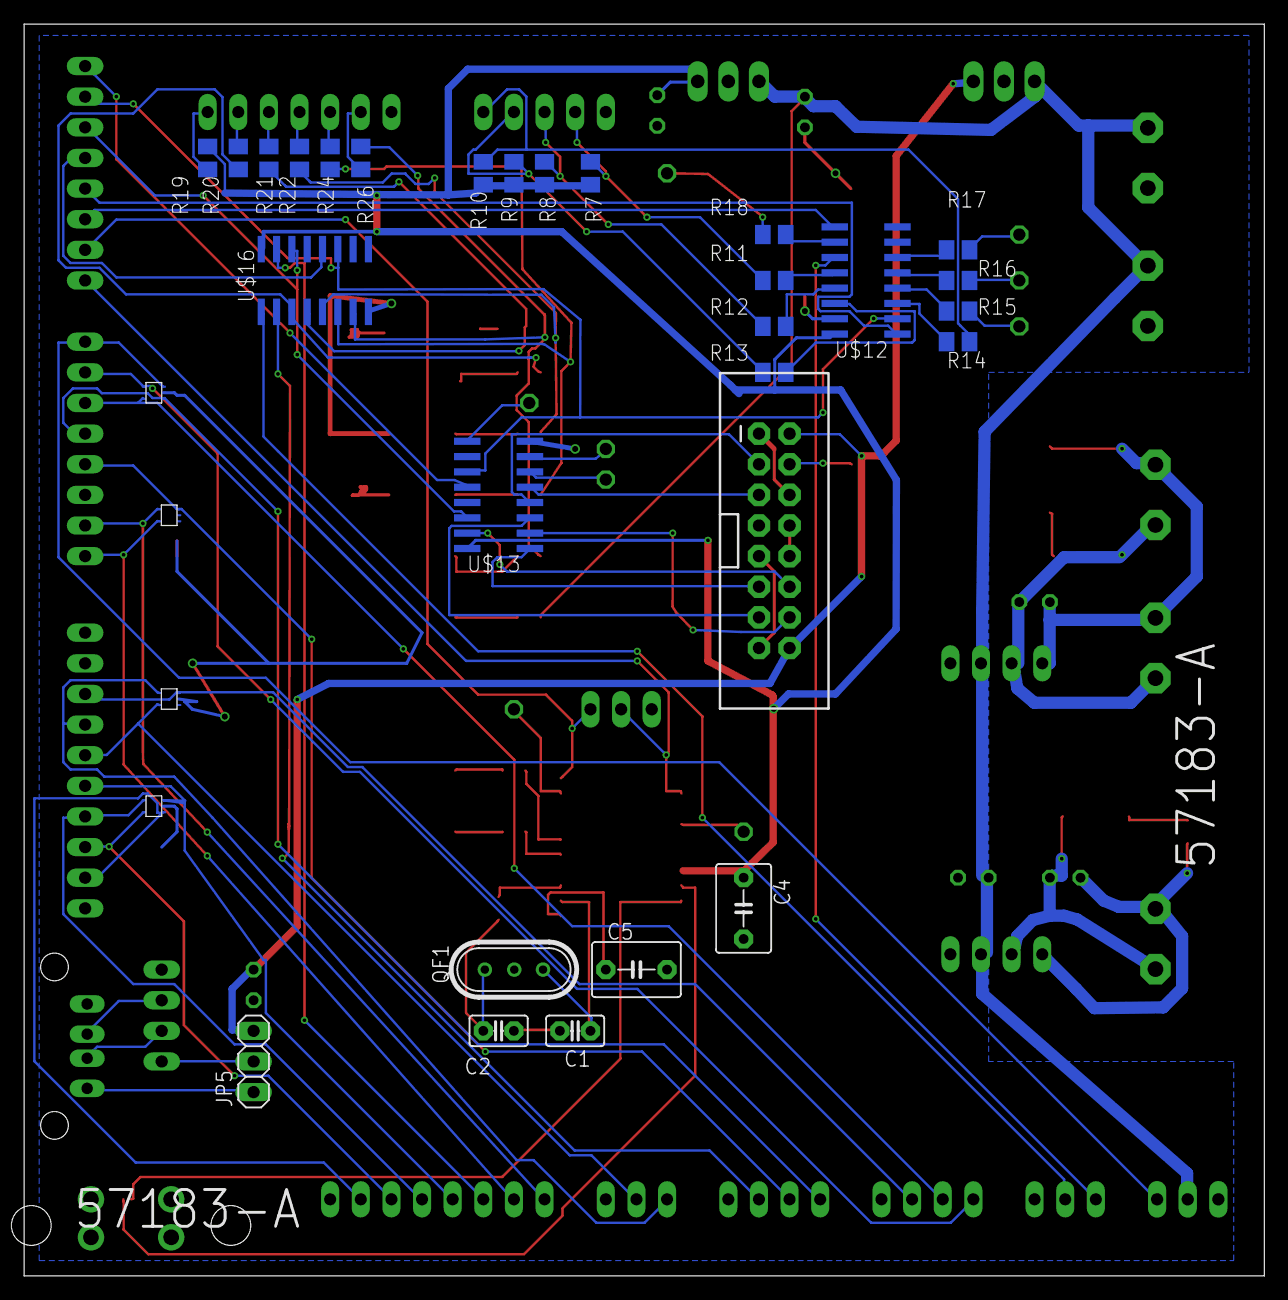
[picture p39: board controller 2.brd from below]

Board: 2 copper layers, 102.8 x 103.8 mm, 93 parts (32 on the bottom side), 95 nets.

Parts:
ANALOGUE_IN: 1X08
C1, C2: 39p; C2.5-2
C3, C9: 10u; C025-024X044
C4, C5: 0.1u; C5B4.5
C6: 20u; C025-024X044
C7: 0.33u; C025-024X044
C8, C10: 0.1u; C025-024X044
CONTR_GREEN: P-LCC-4
DC/DC: P-LCC-2
DC/DC_ON1, DC/DC_ON2, DC/DC_ON3, DC/DC_ON4: P-LCC-2
DIGITAL: 1X08
DUMP_LOAD: 22-23-2031
DUMP_LOAD_: P-LCC-2
FLYBACK: 22-23-2041
IC1: MCP2200SOIC20; SOIC20
INVERTER: 22-23-2081
INVERTER_: P-LCC-2
JP1: USB_MICROB_PLUG-SMT; MICRO-B-SMT
JP2, JP3, JP7, JP8, JP10, JP11, JP12, JP13, JP14: 1X01
JP4: 1X04
JP5, JP6: 1X03
JP9: 1X05
LCD_SCREEN: M08X2-SHROUDED_LOCK; 2X8-SHROUDED_LOCK
LED1: P-LCC-2
MEASUREMENT: 22-23-2041
PROTECTION: 22-23-2031
PWM_OUT: 1X10
QF1: 10M7AHC49T; HC49U
R1: 0; M0805
R2, R3, R19, R20, R21, R22, R23, R24, R25, R26, R27, R28, R29: 200; M0805
R4, R5, R6: 1.2k; M0805
R7, R8, R9, R10: 100k; M0805
R11, R12, R13, R14, R15, R16, R17, R18: 20; M0805
SERIALOUT: 1X03
U$1, U$2, U$3, U$5, U$8: CTB1500/2; CTB1500-2
U$4, U$6: KFP_DC-DC12V; KFP_DC-DC
U$7, U$9: KFP_VOLTAGE_REGULATOR; TO220
U$10, U$11, U$14, U$15: EVS_NXP
U$12: 74HC165; SO16
U$13, U$16: SN74AHC594; SO16
U$17: 10k; MURATA_PVZ2A
X1: PN87520
X2: 22-23-2071

Connections:
3.3V: C4.1, C10.2, IC1.17, R7.1, R8.1, R9.1, R10.1, R19.1, U$9.3, U$12.16, U$13.16, U$16.16
5V: C8.1, JP5.3, LCD_SCREEN.2, LCD_SCREEN.16, U$7.3, U$17.1
12V: C6.2, C7.2, JP6.2, R5.1, U$2.P$2, U$4.+VIN, U$6.+VIN, U$7.1, U$8.P$2, U$9.1
CLOCK: DIGITAL.2, U$12.2, U$13.11, U$16.11
CTR_PICCOLO_POWER: JP4.1, JP5.2
D1: LCD_SCREEN.12, U$13.15
D2: LCD_SCREEN.11, U$13.1
D3: LCD_SCREEN.14, U$13.2
D4: LCD_SCREEN.13, U$13.3
DATA_IN: DIGITAL.6, U$12.9
DC/DC_IN_1: ANALOGUE_IN.6, FLYBACK.2, U$15.P$5
DC/DC_IN_2: ANALOGUE_IN.7, FLYBACK.1, U$15.P$4
DC/DC_ON: R26.1, R29.2, U$16.7
DUMP_LOAD1: DUMP_LOAD.2, PWM_OUT.6, U$11.P$5
DUMP_LOAD2: DUMP_LOAD.1, PWM_OUT.7, U$11.P$4
DUMP_LOAD_1_ON: R22.1, R27.2, U$16.5
E: LCD_SCREEN.5, U$13.5
FLYBACK: FLYBACK.3, PWM_OUT.8, U$11.P$3
GND: C4.2, C5.2, C6.1, C7.1, C8.2, C10.1, CONTR_GREEN.C@4, DC/DC.C, DC/DC_ON2.C, DC/DC_ON3.C, DUMP_LOAD.3, DUMP_LOAD_.C, FLYBACK.4, IC1.20, INVERTER.8, INVERTER_.C, JP4.4, JP6.3, JP9.5, LCD_SCREEN.1, LCD_SCREEN.6, LCD_SCREEN.7, LCD_SCREEN.8, LCD_SCREEN.9, LCD_SCREEN.10, LCD_SCREEN.15, LED1.C, MEASUREMENT.4, PROTECTION.3, PWM_OUT.1, SERIALOUT.3, U$2.P$1, U$4.-VIN, U$6.-VIN, U$7.2, U$8.P$1, U$9.2, U$10.P$2, U$11.P$2, U$12.8, U$12.15, U$13.8, U$14.P$2, U$15.P$2, U$16.8, U$17.3, X1.4, X2.1
INVERTER_ON: R24.1, R28.2, U$16.6
INV_HA: INVERTER.7, PWM_OUT.2, U$10.P$1
INV_HB: INVERTER.5, PWM_OUT.4, U$10.P$4
INV_I: ANALOGUE_IN.1, INVERTER.2, U$14.P$5
INV_LA: INVERTER.6, PWM_OUT.3, U$10.P$5
INV_LB: INVERTER.4, PWM_OUT.5, U$10.P$3
INV_V: ANALOGUE_IN.2, INVERTER.1, U$14.P$4
LOAD: DIGITAL.5, U$12.1
MEAS_AC: ANALOGUE_IN.5, MEASUREMENT.1, U$15.P$1
MEAS_DC: ANALOGUE_IN.4, MEASUREMENT.2, U$14.P$3
unnamed: R12.1, U$12.13
unnamed: LED1.A, R5.2
unnamed: R19.2, X2.7
unnamed: R16.1, U$12.5
unnamed: DC/DC_ON1.C, R4.2
unnamed: R17.1, U$12.6
unnamed: JP12.1, U$13.6
unnamed: IC1.3, R1.1
unnamed: DIGITAL.1, U$13.12
unnamed: JP13.1, U$13.7
unnamed: R20.1, R23.2, U$16.3
unnamed: C2.2, QF1.3, R1.2
unnamed: DC/DC_ON4.A, R6.1
unnamed: JP14.1, U$13.9
unnamed: R21.1, R25.2, U$16.4
unnamed: DIGITAL.3, U$13.14, U$16.14
unnamed: JP9.1, R10.2, R14.2
unnamed: JP9.2, R9.2, R13.2
unnamed: C3.1, DC/DC_ON1.A, U$1.P$2, U$3.P$2, U$4.+VOUT
unnamed: C1.1, C2.1
unnamed: C1.2, IC1.2, QF1.1
unnamed: C3.2, R4.1, U$1.P$1, U$3.P$1, U$4.-VOUT
unnamed: R20.2, X2.6
unnamed: R21.2, X2.5
unnamed: R22.2, X2.4
unnamed: JP9.3, R8.2, R12.2
unnamed: C9.2, R6.2, U$5.P$2, U$6.+VOUT
unnamed: C9.1, DC/DC_ON4.C, U$5.P$1, U$6.-VOUT
unnamed: DIGITAL.4, U$16.12
unnamed: DUMP_LOAD_.A, R27.1
unnamed: DC/DC.A, R28.1
unnamed: INVERTER_.A, R29.1
unnamed: CONTR_GREEN.A, R23.1
unnamed: JP9.4, R7.2, R11.2
unnamed: R24.2, X2.3
unnamed: R26.2, X2.2
unnamed: R18.1, U$12.10
unnamed: R11.1, U$12.12
unnamed: R13.1, U$12.14
unnamed: R14.1, U$12.3
unnamed: R15.1, U$12.4
unnamed: JP7.1, R15.2
unnamed: JP8.1, R16.2
unnamed: JP10.1, R17.2
unnamed: JP11.1, R18.2
unnamed: DC/DC_ON2.A, R2.1
unnamed: DC/DC_ON3.A, R3.1
unnamed: C5.1, IC1.1
unnamed: IC1.5, R2.2
unnamed: IC1.6, R3.2
unnamed: IC1.14, JP2.1
unnamed: IC1.9, JP3.1
PROTEC_FAULT: PROTECTION.1, U$12.11
PROTEC_TRIGGER: PROTECTION.2, U$16.1
RS: LCD_SCREEN.3, U$13.4
RX: DIGITAL.8, IC1.12, SERIALOUT.2
SHAFTSPEED_IN: ANALOGUE_IN.8, JP6.1, U$15.P$3
SHUT_DOWN: INVERTER.3, U$16.15
START_UP: MEASUREMENT.3, U$16.2
TX: DIGITAL.7, IC1.10, SERIALOUT.1
USB_D+: JP4.3, X1.3
USB_D-: JP4.2, X1.2
USB_UART_D+: IC1.19, JP1.3
USB_UART_D-: IC1.18, JP1.2
V0: LCD_SCREEN.4, U$17.2
V_USB: JP5.1, X1.1
