equinoxorg/Micro-Hydro-ELC/board_protection/protection1.brd

## EAGLE design board_protection/protection1.brd (2012-08-17)

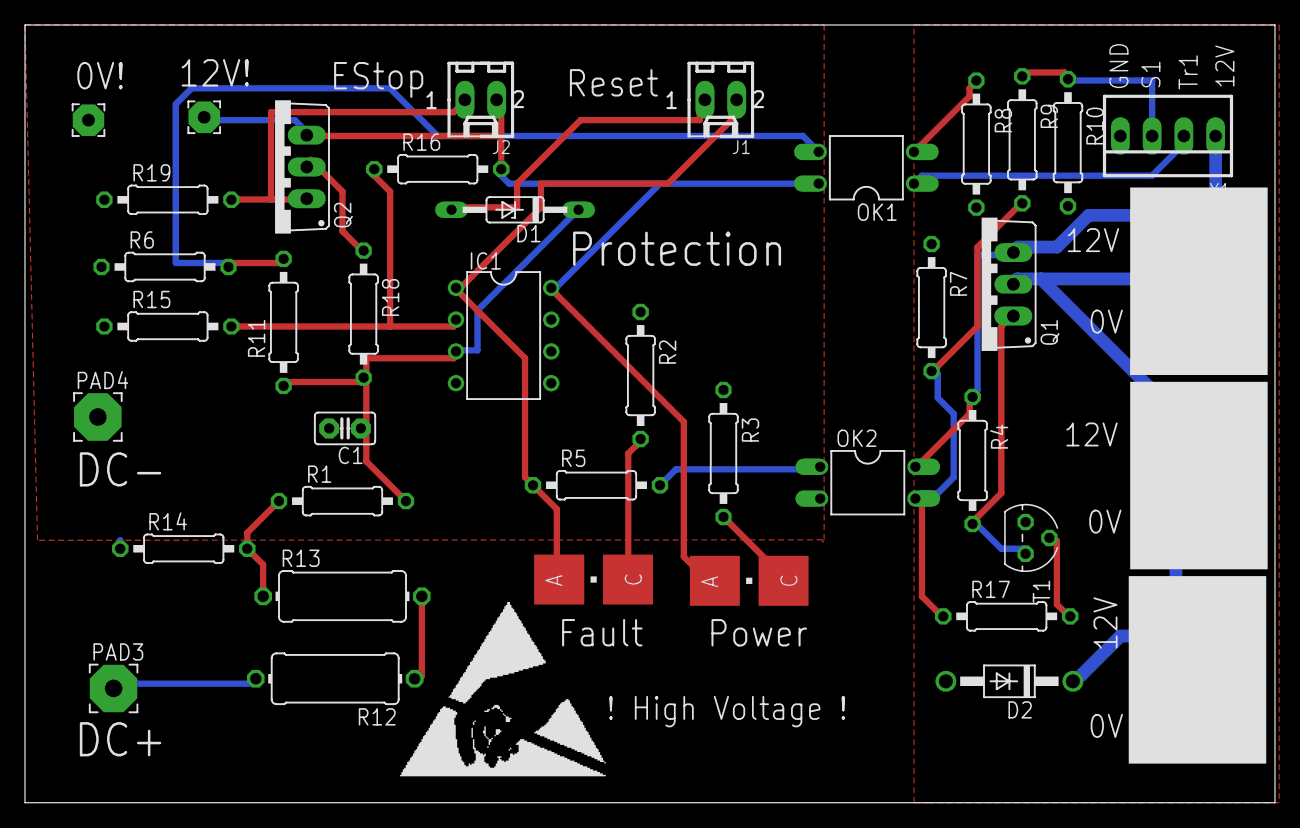
[picture p40: board protection1.brd from above]

Board: 2 copper layers, 100.0 x 62.2 mm, 40 parts (0 on the bottom side), 24 nets.

Parts:
C1: C2.5-2
D1: 1N821; DO35Z10
D2: 1N4004; DO41-10
IC1: MC33078P; DIL08
J1, J2: 22-27-2021-02; 6410-02
LED1, LED2: P-LCC-2
OK1, OK2: TIL191; DIL04
PAD1, PAD2: 2,54/1,0
PAD3, PAD4: 3,81/1,4
Q1, Q2: IRF9530; TO220BV
R1, R2, R3, R4, R5, R6, R7, R8, R9, R10, R11, R14, R15, R16, R17, R18, R19: 0207/10
R12, R13: 0411/12
T1: 2N3904; TO92
U$1, U$2, U$3: TERMINAL_2WAY_EESTORES
X1: 22-23-2041

Connections:
12V: OK2.4, Q1.S, R4.1, X1.1
12V_A: IC1.8, J2.2, LED1.A, OK1.4, PAD1.1, Q2.S, R16.2
DC+: PAD3.1, R12.2
FAULT: IC1.1, J1.2, LED2.A, R5.1
FAULT_B: OK2.3, R7.2, R9.2, R17.1
F_TRIGGER: OK1.3, R6.2, R11.2
F_TRIGGER_B: OK1.1, X1.2
GND: D2.A, R7.1, R8.2, R10.2, T1.3, U$1.P$1, U$2.P$1, U$3.P$1, X1.4
GND_A: C1.2, IC1.4, OK2.2, PAD2.1, PAD4.1, R2.1, R3.1, R6.1, R14.1, R15.1, R19.1
unnamed: OK2.1, R5.2
unnamed: C1.1, D1.C, IC1.3, R1.2, R11.1, R18.2
unnamed: LED2.C, R2.2
unnamed: Q1.G, R4.2, T1.1
unnamed: IC1.2, R15.2, R16.1
unnamed: R17.2, T1.2
unnamed: R1.1, R13.1, R14.2
unnamed: LED1.C, R3.2
unnamed: R12.1, R13.2
unnamed: D2.C, Q1.D, U$1.P$2, U$2.P$2, U$3.P$2
unnamed: OK1.2, R8.1
unnamed: R9.1, R10.1, X1.3
unnamed: D1.A, J1.1
unnamed: Q2.D, R18.1
unnamed: J2.1, Q2.G, R19.2
