equinoxorg/Micro-Hydro-ELC/board_measurement/ac and dc measurement.brd

## EAGLE design board_measurement/ac and dc measurement.brd (2012-08-17)

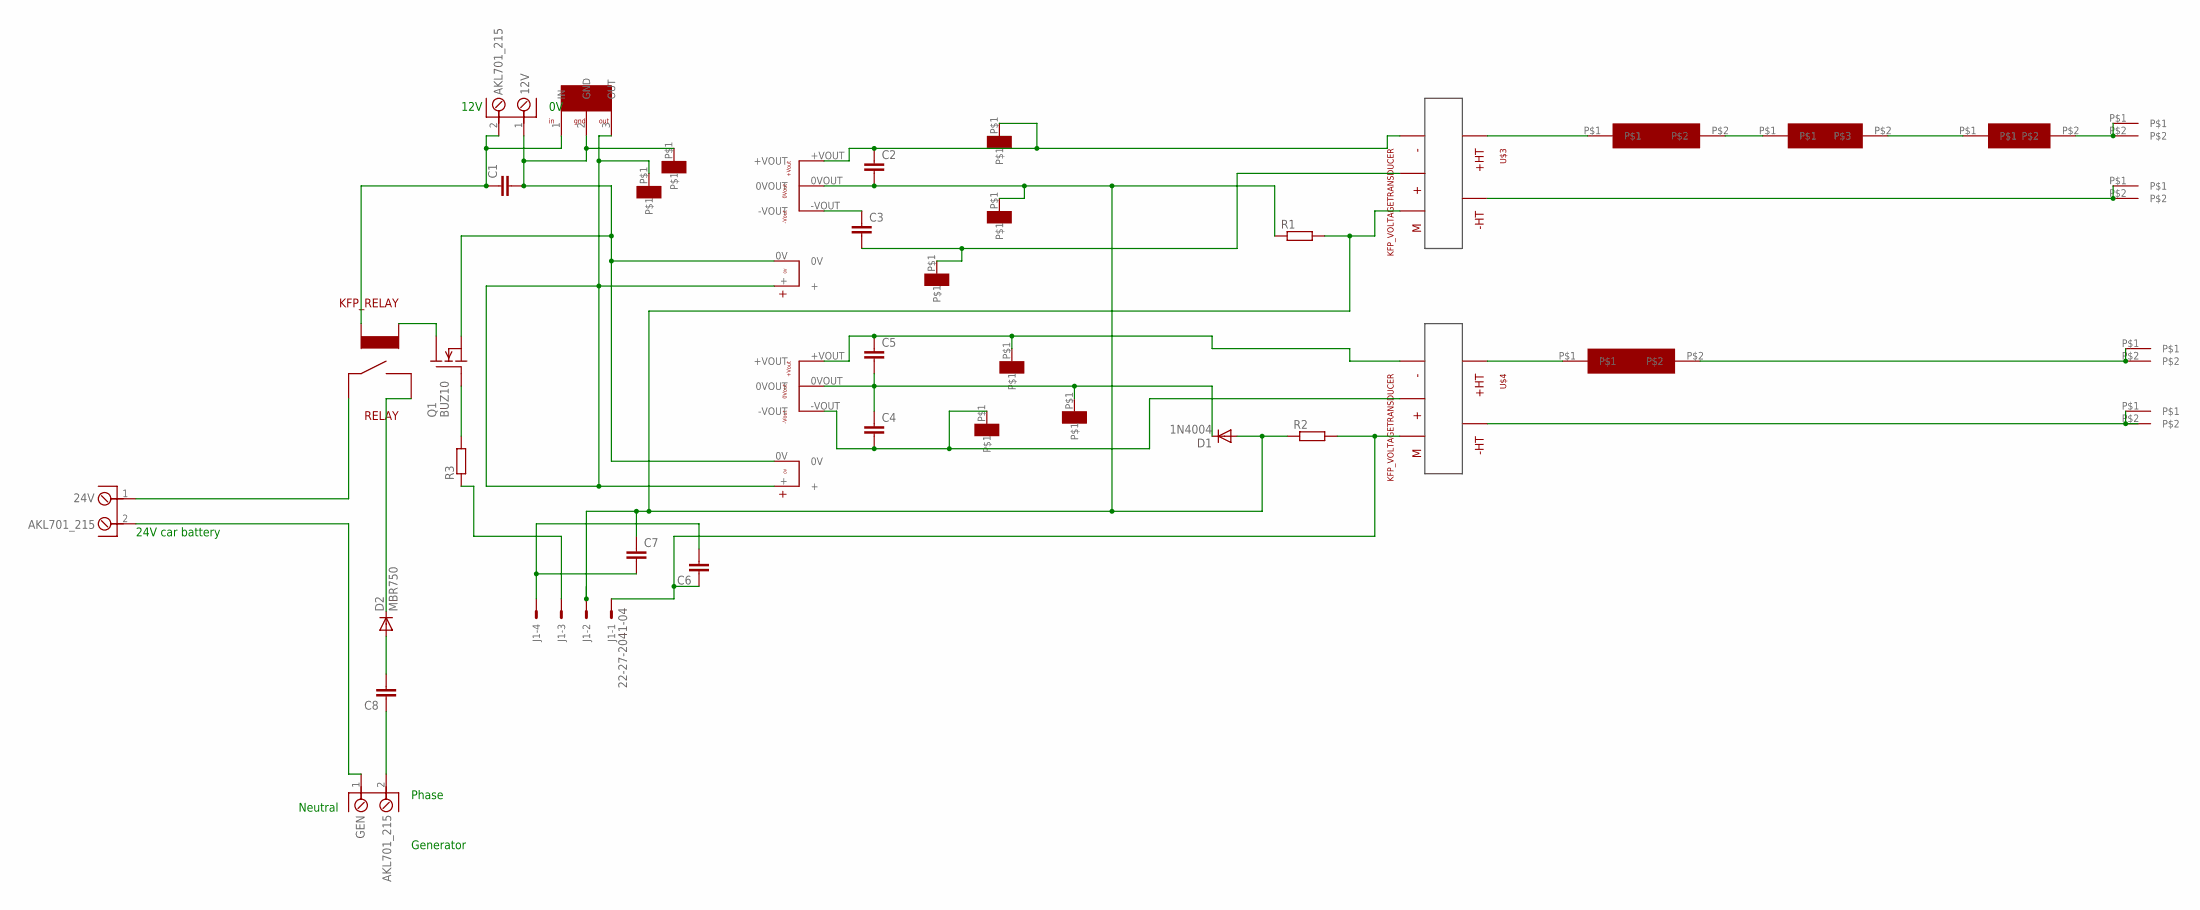
[picture p41: schematic ac and dc measurement.sch]

Parts:
5V: KFP_VOL_REG; TO220
12V, 24V: AKL701_215; AKL701_2_15
C1, C2, C3, C4, C5, C6, C7: C-EU025-024X044; C025-024X044
C8: C-EU025-030X050; C025-030X050
D1: 1N4004; DO41-10
D2: MBR750; TO220AC
GEN: AKL701_215; AKL701_2_15
J1: 22-27-2041-04; 6410-04
Q1: BUZ10; TO220
R1, R2, R3: R-EU_0204/7; 0204/7
RELAY: KFP_RELAY; KFP_RELAYSPST
U$1, U$2: KFP_DC_DC; KFP_DC-DC
U$3, U$4: KFP_VOLTAGETRANSDUCER
U$5, U$6: KFP_33K
U$7: KFP_22K
U$8: KFP_4.7K; KFP_18K
U$9, U$11, U$12, U$13: HIGH_AMP_TERMINAL
U$14, U$15, U$16, U$17, U$18, U$19, U$20, U$21: KFP_TEST

Connections:
unnamed: 5V.2 (GND), 12V.1, C1.2, Q1.3 (S), U$1.0V, U$2.0V, U$21.P$1
unnamed: 5V.3 (OUT), U$1.+, U$2.+, U$16.P$1
unnamed: C3.2, U$3.+, U$14.P$1
unnamed: C4.2, U$2.-VOUT, U$4.+, U$18.P$1
unnamed: C6.2, C7.2, J1.4
unnamed: C2.1, U$1.+VOUT, U$3.-, U$15.P$1
unnamed: C4.1, C5.2, D1.C, U$2.0VOUT, U$20.P$1
unnamed: C5.1, U$2.+VOUT, U$4.-, U$17.P$1
unnamed: 24V.2, GEN.1
unnamed: U$4.+HT] (+HT), U$5.P$1
unnamed: C6.1, J1.1, R2.2, U$4.M
unnamed: U$3.+HT] (+HT), U$6.P$1
unnamed: U$6.P$2, U$7.P$1
unnamed: Q1.2 (D), RELAY.A1
unnamed: U$5.P$2, U$12.P$1, U$12.P$2
unnamed: U$4.-HT, U$13.P$1, U$13.P$2
unnamed: Q1.1 (G), R3.2
unnamed: U$3.-HT, U$11.P$1, U$11.P$2
unnamed: C8.1, GEN.2
unnamed: C8.2, D2.A
unnamed: U$8.P$2, U$9.P$1, U$9.P$2
unnamed: C2.2, C7.1, D1.A, J1.2, R1.1, R1.2, R2.1, U$1.0VOUT, U$3.M, U$19.P$1
unnamed: C3.1, U$1.-VOUT
unnamed: J1.3, R3.1
unnamed: 5V.1 (IN), 12V.2, C1.1, RELAY.A2
unnamed: D2.C, RELAY.11
unnamed: 24V.1, RELAY.14
RESISTOR: U$7.P$2, U$8.P$1

Notes on the sheet:
12V
Generator
Phase
Neutral
24V car battery

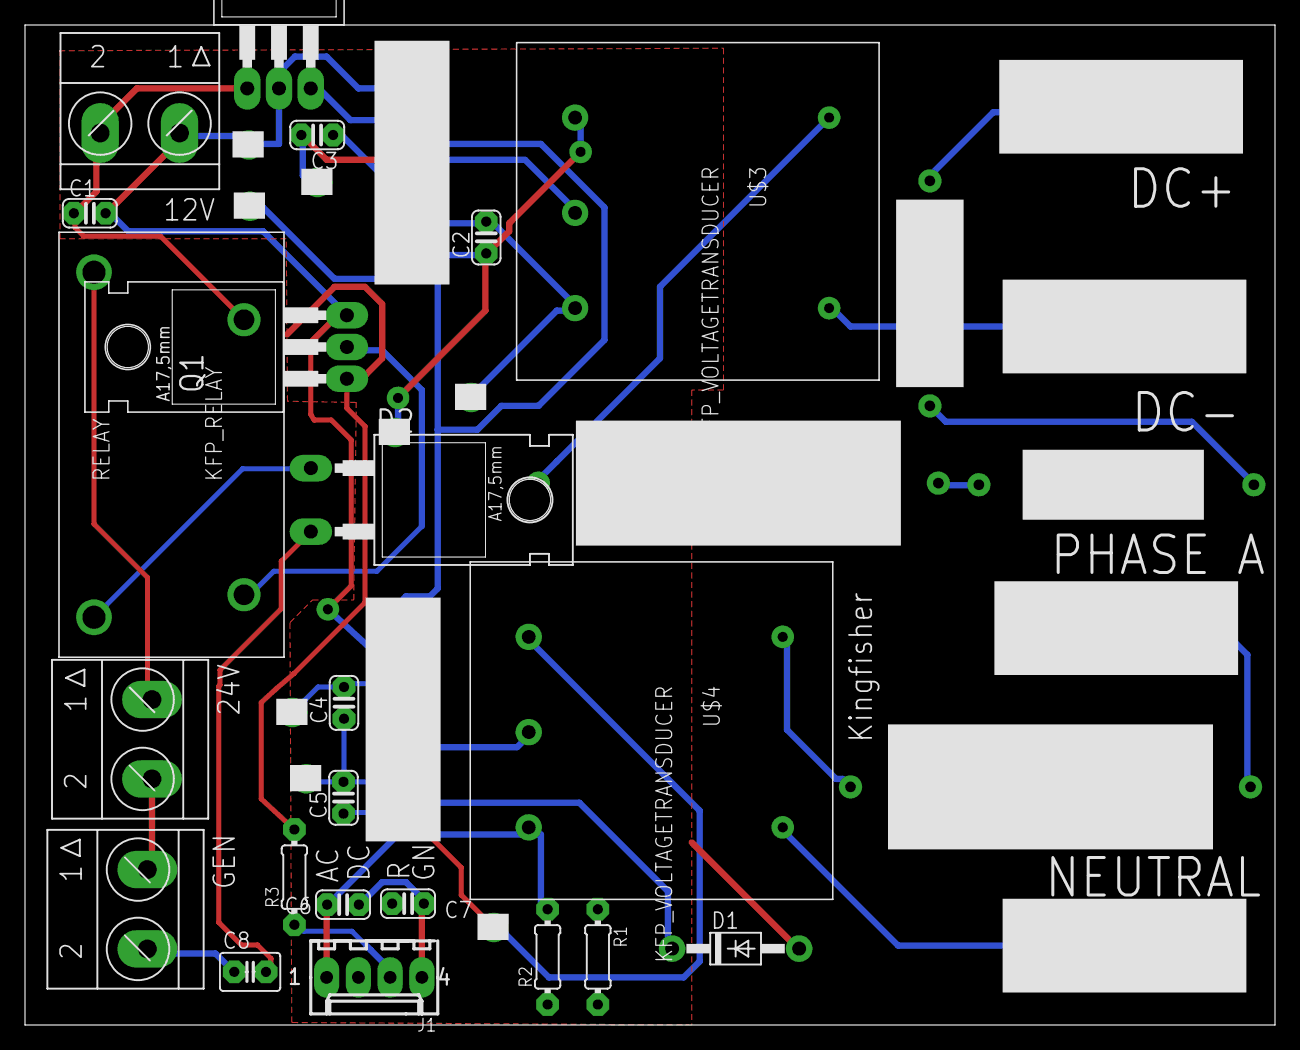
[picture p42: board ac and dc measurement.brd from above]

Board: 2 copper layers, 100.0 x 80.0 mm, 40 parts (0 on the bottom side), 28 nets.
