equinoxorg/Micro-Hydro-ELC/Controller_Software/Tut1- Project Creation and PWMs/source/main.c

//<<<<<<<<<<<<<<<<<<<<<<<<<<<<<<<<<<<<<>>>>>>>>>>>>>>>>>>>>>>>>>>>>>>>>>>>>>>\\
//<<	  FILE: main.c							DATE: 03/2013			   >>\\
//<<	DEVICE: TI Piccolo F28069										   >>\\
//<<<<<<<<<<<<<<<<<<<<<<<<<<<<<<<<<<<<<>>>>>>>>>>>>>>>>>>>>>>>>>>>>>>>>>>>>>>\\
//<<							Main Routine							   >>\\
//<<<<<<<<<<<<<<<<<<<<<<<<<<<<<<<<<<<<<>>>>>>>>>>>>>>>>>>>>>>>>>>>>>>>>>>>>>>\\


//###########################################################################//
//								INCLUDE FILES 								 //
//###########################################################################//
//
#include "Function_Prototypes.h"


//###########################################################################//
//								MAIN ROUTINE								 //
//###########################################################################//
//
void main(void)
{

// --- Initialisation
						// _SOURCE_
	DeviceInit();		// DeviceInit.c
	GpioInit();			// GpioInit.c
	PwmInit();			// PwmInit.c

	CpuTimer0Regs.PRD.all =  mSec100;	// Flag CpuTimer0 every 100ms [100ms*2 (# of LED states) = 0.2s blink rate]

// --- Infinite Loop
	
	while(1)
	{
		if(CpuTimer0Regs.TCR.bit.TIF == 1)			// Flag check
		{
			CpuTimer0Regs.TCR.bit.TIF = 1;			// Clear flag
			GpioDataRegs.GPBTOGGLE.bit.GPIO34 = 1;	// Toggle GPIO34 (LED)
		}

	}
}


//###########################################################################//
//								END OF FILE									 //
//###########################################################################//
