equinoxorg/Micro-Hydro-ELC/Controller_Software/Tut1- Project Creation and PWMs/source/Device_Init.c

//<<<<<<<<<<<<<<<<<<<<<<<<<<<<<<<<<<<<<>>>>>>>>>>>>>>>>>>>>>>>>>>>>>>>>>>>>>>\\
//<<	  FILE: Device_Init.c					DATE: 03/2013			   >>\\
//<<	DEVICE: TI Piccolo F28069										   >>\\
//<<<<<<<<<<<<<<<<<<<<<<<<<<<<<<<<<<<<<>>>>>>>>>>>>>>>>>>>>>>>>>>>>>>>>>>>>>>\\
//<<						Device Initialisation						   >>\\
//<<<<<<<<<<<<<<<<<<<<<<<<<<<<<<<<<<<<<>>>>>>>>>>>>>>>>>>>>>>>>>>>>>>>>>>>>>>\\


//###########################################################################//
//								INCLUDE FILES 								 //
//###########################################################################//
//
#include "F2806x_Device.h"

// Functions that will be run from RAM need to be assigned to
// a different section.  This section will then be mapped to a load and
// run address using the linker cmd file.
#pragma CODE_SECTION(InitFlash, "ramfuncs");
#define Device_cal (void   (*)(void))0x3D7C80

void WDogDisable(void);
void PLLset(Uint16);
void ISR_ILLEGAL(void);


//###########################################################################//
//				CONFIGURE DEVICE FOR TARGET APPLICATION						 //
//###########################################################################//
//
void DeviceInit(void)
{
	WDogDisable(); 	// Disable the watchdog initially
	DINT;			// Global Disable all Interrupts
	IER = 0x0000;	// Disable CPU interrupts
	IFR = 0x0000;	// Clear all CPU interrupt flags

// The Device_cal function, which copies the ADC & oscillator calibration values
// from TI reserved OTP into the appropriate trim registers, occurs automatically
// in the Boot ROM. If the boot ROM code is bypassed during the debug process, the
// following function MUST be called for the ADC and oscillators to function according
// to specification.
	EALLOW;
	SysCtrlRegs.PCLKCR0.bit.ADCENCLK = 1; // Enable ADC peripheral clock
	(*Device_cal)();					  // Auto-calibrate from TI OTP
	SysCtrlRegs.PCLKCR0.bit.ADCENCLK = 0; // Return ADC clock to original state
	EDIS;

// Switch to Internal Oscillator 1 and turn off all other clock
// sources to minimize power consumption
	EALLOW;
	SysCtrlRegs.CLKCTL.bit.INTOSC1OFF = 0;
    SysCtrlRegs.CLKCTL.bit.OSCCLKSRCSEL=0;  // Clk Src = INTOSC1
	SysCtrlRegs.CLKCTL.bit.XCLKINOFF=1;     // Turn off XCLKIN
	SysCtrlRegs.CLKCTL.bit.XTALOSCOFF=1;    // Turn off XTALOSC
	SysCtrlRegs.CLKCTL.bit.INTOSC2OFF=1;    // Turn off INTOSC2
    EDIS;

// SYSTEM CLOCK speed based on internal oscillator = 10 MHz
// 0x10=  80    MHz		(16)
// 0xF =  75    MHz		(15)
// 0xE =  70    MHz		(14)
// 0xD =  65    MHz		(13)
// 0xC =  60	MHz		(12)
// 0xB =  55	MHz		(11)
// 0xA =  50	MHz		(10)
// 0x9 =  45	MHz		(9)
// 0x8 =  40	MHz		(8)
// 0x7 =  35	MHz		(7)
// 0x6 =  30	MHz		(6)
// 0x5 =  25	MHz		(5)
// 0x4 =  20	MHz		(4)
// 0x3 =  15	MHz		(3)
// 0x2 =  10	MHz		(2)

	PLLset( 0x10 );	// choose from options above

// Initialise interrupt controller and Vector Table
// to defaults for now. Application ISR mapping done later.
//	PieCntlInit();		
//	PieVectTableInit();

   EALLOW; // below registers are "protected", allow access.

// LOW SPEED CLOCKS pre-scale register settings
   SysCtrlRegs.LOSPCP.all = 0x0002;		// Sysclk / 4 (20 MHz)
   SysCtrlRegs.XCLK.bit.XCLKOUTDIV=2;


//###########################################################################//
//						PERIPHERAL CLOCK ENABLES							 //
//###########################################################################//
//
// If you are not using a peripheral you may want to switch
// the clock off to save power, i.e. set to =0 
// 
// Note: not all peripherals are available on all 280x derivates.
// Refer to the datasheet for your particular device. 

   SysCtrlRegs.PCLKCR0.bit.ADCENCLK = 1;    // ADC
   //------------------------------------------------
   SysCtrlRegs.PCLKCR3.bit.COMP1ENCLK = 0;	// COMP1
   SysCtrlRegs.PCLKCR3.bit.COMP2ENCLK = 0;	// COMP2
   SysCtrlRegs.PCLKCR3.bit.COMP3ENCLK = 0;	// COMP3
   //------------------------------------------------
   SysCtrlRegs.PCLKCR0.bit.I2CAENCLK = 0;   // I2C
   //------------------------------------------------
   SysCtrlRegs.PCLKCR0.bit.SPIAENCLK = 0;	// SPI-A
   SysCtrlRegs.PCLKCR0.bit.SPIBENCLK = 0;	// SPI-B
   //------------------------------------------------
   SysCtrlRegs.PCLKCR0.bit.MCBSPAENCLK = 0;	// McBSP-A
   //------------------------------------------------
   SysCtrlRegs.PCLKCR0.bit.SCIAENCLK = 0;  	// SCI-A
   SysCtrlRegs.PCLKCR0.bit.SCIBENCLK = 0;	// SCI-B
   //------------------------------------------------
   SysCtrlRegs.PCLKCR1.bit.ECAP1ENCLK = 0;	// eCAP1
   SysCtrlRegs.PCLKCR1.bit.ECAP2ENCLK = 0;	// eCAP2
   SysCtrlRegs.PCLKCR1.bit.ECAP3ENCLK = 0;	// eCAP3
   //------------------------------------------------
   SysCtrlRegs.PCLKCR1.bit.EPWM1ENCLK = 0;  // ePWM1
   SysCtrlRegs.PCLKCR1.bit.EPWM2ENCLK = 0;  // ePWM2
   SysCtrlRegs.PCLKCR1.bit.EPWM3ENCLK = 0;  // ePWM3
   SysCtrlRegs.PCLKCR1.bit.EPWM4ENCLK = 0;  // ePWM4
   SysCtrlRegs.PCLKCR1.bit.EPWM5ENCLK = 0;	// ePWM5
   SysCtrlRegs.PCLKCR1.bit.EPWM6ENCLK = 0;	// ePWM6
   SysCtrlRegs.PCLKCR1.bit.EPWM7ENCLK = 0;	// ePWM7
   SysCtrlRegs.PCLKCR1.bit.EPWM8ENCLK = 0;	// ePWM8
   //------------------------------------------------
   SysCtrlRegs.PCLKCR0.bit.TBCLKSYNC = 0;   // Enable TBCLK
   //------------------------------------------------
   SysCtrlRegs.PCLKCR3.bit.DMAENCLK = 0;	// DMA
   //------------------------------------------------
   SysCtrlRegs.PCLKCR3.bit.CLA1ENCLK = 0;	// CLA
   //------------------------------------------------


	EDIS;	// Disable register access
}


//###########################################################################//
//									OTHER									 //
//###########################################################################//
//
//============================================================================
// NOTE:
// IN MOST APPLICATIONS THE FUNCTIONS AFTER THIS POINT CAN BE LEFT UNCHANGED
// THE USER NEED NOT REALLY UNDERSTAND THE BELOW CODE TO SUCCESSFULLY RUN THIS
// APPLICATION.
//============================================================================

void WDogDisable(void)
{
    EALLOW;
    SysCtrlRegs.WDCR= 0x0068;
    EDIS;
}

// This function initializes the PLLCR register.
//void InitPll(Uint16 val, Uint16 clkindiv)
void PLLset(Uint16 val)
{
   volatile Uint16 iVol;

   // Make sure the PLL is not running in limp mode
   if (SysCtrlRegs.PLLSTS.bit.MCLKSTS != 0)
   {
	  EALLOW;
      // OSCCLKSRC1 failure detected. PLL running in limp mode.
      // Re-enable missing clock logic.
      SysCtrlRegs.PLLSTS.bit.MCLKCLR = 1;
      EDIS;
      // Replace this line with a call to an appropriate
      // SystemShutdown(); function.
      asm("        ESTOP0");     // Uncomment for debugging purposes
   }

   // DIVSEL MUST be 0 before PLLCR can be changed from
   // 0x0000. It is set to 0 by an external reset XRSn
   // This puts us in 1/4
   if (SysCtrlRegs.PLLSTS.bit.DIVSEL != 0)
   {
       EALLOW;
       SysCtrlRegs.PLLSTS.bit.DIVSEL = 0;
       EDIS;
   }

   // Change the PLLCR
   if (SysCtrlRegs.PLLCR.bit.DIV != val)
   {

      EALLOW;
      // Before setting PLLCR turn off missing clock detect logic
      SysCtrlRegs.PLLSTS.bit.MCLKOFF = 1;
      SysCtrlRegs.PLLCR.bit.DIV = val;
      EDIS;

      // Optional: Wait for PLL to lock.
      // During this time the CPU will switch to OSCCLK/2 until
      // the PLL is stable.  Once the PLL is stable the CPU will
      // switch to the new PLL value.
      //
      // This time-to-lock is monitored by a PLL lock counter.
      //
      // Code is not required to sit and wait for the PLL to lock.
      // However, if the code does anything that is timing critical,
      // and requires the correct clock be locked, then it is best to
      // wait until this switching has completed.

      // Wait for the PLL lock bit to be set.
      // The watchdog should be disabled before this loop, or fed within
      // the loop via ServiceDog().

	  // Uncomment to disable the watchdog
      WDogDisable();

	  while(SysCtrlRegs.PLLSTS.bit.PLLLOCKS != 1) {}

      EALLOW;
      SysCtrlRegs.PLLSTS.bit.MCLKOFF = 0;
	  EDIS;
	}

	  //divide down SysClk by 2 to increase stability
	EALLOW;
	SysCtrlRegs.PLLSTS.bit.DIVSEL = 2; 
	EDIS;
}


interrupt void ISR_ILLEGAL(void)   // Illegal operation TRAP
{
  // Insert ISR Code here

  // Next two lines for debug only to halt the processor here
  // Remove after inserting ISR Code
  asm("          ESTOP0");
  for(;;);

}

// This function initializes the Flash Control registers

//                   CAUTION
// This function MUST be executed out of RAM. Executing it
// out of OTP/Flash will yield unpredictable results

void InitFlash(void)
{
   EALLOW;
   //Enable Flash Pipeline mode to improve performance
   //of code executed from Flash.
   FlashRegs.FOPT.bit.ENPIPE = 1;

   //                CAUTION
   //Minimum waitstates required for the flash operating
   //at a given CPU rate must be characterized by TI.
   //Refer to the datasheet for the latest information.

   //Set the Paged Waitstate for the Flash
   FlashRegs.FBANKWAIT.bit.PAGEWAIT = 3;

   //Set the Random Waitstate for the Flash
   FlashRegs.FBANKWAIT.bit.RANDWAIT = 3;

   //Set the Waitstate for the OTP
   FlashRegs.FOTPWAIT.bit.OTPWAIT = 5;

   //                CAUTION
   //ONLY THE DEFAULT VALUE FOR THESE 2 REGISTERS SHOULD BE USED
   FlashRegs.FSTDBYWAIT.bit.STDBYWAIT = 0x01FF;
   FlashRegs.FACTIVEWAIT.bit.ACTIVEWAIT = 0x01FF;
   EDIS;

   //Force a pipeline flush to ensure that the write to
   //the last register configured occurs before returning.

   asm(" RPT #7 || NOP");
}


// This function will copy the specified memory contents from
// one location to another. 
// 
//	Uint16 *SourceAddr        Pointer to the first word to be moved
//                          SourceAddr < SourceEndAddr
//	Uint16* SourceEndAddr     Pointer to the last word to be moved
//	Uint16* DestAddr          Pointer to the first destination word
//
// No checks are made for invalid memory locations or that the
// end address is > then the first start address.

void MemCopy(Uint16 *SourceAddr, Uint16* SourceEndAddr, Uint16* DestAddr)
{
    while(SourceAddr < SourceEndAddr)
    { 
       *DestAddr++ = *SourceAddr++;
    }
    return;
}
	
//###########################################################################//
//								END OF FILE									 //
//###########################################################################//
