equinoxorg/Micro-Hydro-ELC/Controller_Software/Kingfisher_ELC_Workspace/KP_Controller_1/DelayUs.asm

**********************************************************************
* File: DelayUs.asm
* Devices: TMS320F2806x
* Author: Technical Training Organization (TTO), Texas Instruments
* History:
*   10/14/11 - original
**********************************************************************

WDKEY	.set	0x7025

**********************************************************************
* Function: DelayUs()
* Description: Implements a time delay
* MCU: TMS320F2806x (80 MHz)
* Include files: none
* Function Prototype: void DelayUs(unsigned int)
* Useage: DelayUs(Usec);
* Input Parameters: unsigned int Usec = time delay in microseconds
* Return Value: none
* Notes:
*   1) The execution time of this routine is based upon a 80 MHz
*      CPUCLK.  It also assumes that the function executes out of
*      internal RAM.  If executing out of internal flash or external
*      memory, the execution speed will be slightly slower.
*      However, the inner loop of this function is essentially
*      invariant to the memory it is running in.  Therefore, even
*      when running in flash memory, the basic loop time will be
*      only slightly longer than 1 us.
*
*   2) The outer loop of this function is interruptible (i.e., every
*      1 us).  The user should disable interrupts before calling the
*      function if they need an exact delay time, as opposed to a
*      minimum delay time.
*
**********************************************************************
       .def _DelayUs
       .text

_DelayUs:
        MOVB AH, #0                   ;Zero AH
        PUSH ST1                      ;Save ST1 to preserve EALLOW setting

DelayUs1:                             ;Outer loop

;Service the watchdog in case it is active
        EALLOW
        MOVZ DP, #(WDKEY>>6)
        MOV @WDKEY, #0x0055
        MOV @WDKEY, #0x00AA
        EDIS

;Proceed with the inner loop
        RPT #68                       ;Inner loop
     || NOP

        SUBB ACC,#1                   ;Decrement outer loop counter
        BF DelayUs1, GT               ;Branch for outer loop

;Finish up
        POP ST1                       ;Restore ST1
        LRETR                         ;Return

;end of function DelayUs()
**********************************************************************

       .end
;end of file DelayUs.asm
