equinoxorg/Micro-Hydro-ELC/(commit log)

2012-08-16 inital commit
    [controller 2.brd, controller 2.sch]
2012-08-16 protection_board added
    [protection1.brd, protection1.sch]
2012-08-16 dumpload circuit added
    [Dump Load 2.brd, Dump Load 2.sch]
2012-08-16 measurement_board added, still needs check and possible editing for manufacture
    [ac and dc measurement-old.brd, ac and dc measurement-old.sch, ac and dc measurement.brd, ac and dc measurement.sch]
2012-08-16 changed directory names
    [Dump Load 2.brd, Dump Load 2.sch, ac and dc measurement-old.brd, ac and dc measurement-old.sch, ac and dc measurement.brd, ac and dc measurement.sch, controller 2.brd, controller 2.sch]
2012-08-17 measurement and exitation added, all boards labeled for manufacturing
    [ac and dc measurement-old.brd, ac and dc measurement.brd]
2012-08-17 library added, boards labeled with manufacturing id
    [Dump Load 2.brd, ac and dc measurement-old.sch, controller 2.brd, protection1.brd]
2013-05-16 Hydro ELC Control Stack PCBs and Supporting Files
    [Breakout-01.brd, Breakout-01.sch, Breakout-02.brd, Breakout-02.sch, Components - Controller v07.xlsx, DigitalIn-01.brd, DigitalIn-01.sch, DigitalIn-01b.brd]
